Pinticketaro/DZ-GH-60_keyboard/LOG.md

# 製作ログ

新しいものを上に追記する。何を変えたか、実物でどうだったか、次に何を試すかを書く。写真は `photos/` に入れて名前で参照する。

---

## 2026-11-06 道具の更新（monozukuri 0.8.0）
- `scaffold.py --update-tools --force` でテンプレートの道具（geom.py・common.py・coupons.py・dims_sheet.py・render_model.py・slices.py・compare.py・params_diff.py）を入れた。requirements.txt はテンプレートの版に置き換え、ezdxf の1行を足し直した。元は tools/.backup-20261106-182902/
- このプロジェクトは mock.py ではなく gen_case.py → build3d.py で形を作るので、tools/model.py（make_version.py の --tool 用）を足した。mock.py.new は使わないので置かない
- 寸法ファイル：仮の寸法は basis の先頭を「仮（要実測・未確定）」に（0.8.0 はそこで見分ける）、meta.process = both
- 確認ボードを 0.8.0 のテンプレートで作り直して再公開。v19 の問い「底の中央のほぞ」→ いいえ（決定事項に記録）
- 次に試す：DZ60 が届いたら USB-C の位置・PCB の厚さ・PCB の下の部品の高さを測る → v20 は `make_version.py . v20 --tool tools/model.py`（gen_case.py の VER・PARENT を先に書き換える）

## 2026-10-27 v17〜v19（確認ボードで版を重ねた日）
- 2026-10-27 v17（モック）：補強板を枠の掘り込みに入れた（チャットで決定。ボードへの書き込みは0件）→ 側面のアクリルが1枚になり塊感が増した。ただしサポート確認で、上面下・下面下どちらで刷っても壁の内側に幅11.7mmのサポートが1周要ると分かった → 印刷の向き（A上面下／B下面下／Cv16に戻す）をボードで決める。図面・Fusionスクリプトは向きが決まってから更新。
- 2026-10-27 v18b（モック・v17 から分けた案 B・ブランチ claude/tray-v18、はじめ v18 として作り改名）：トレー型（枠＋底3.0一体のPLA、底を下にして印刷、ほぞは下側・M3×8）→ v17 の壁の内側のサポートが消え、残るのは小さな橋渡しだけ。見た目と高さはv17と同じ。次：トレー型とサンドイッチ型のどちらで進めるかをボードで決める。確認ボードはPCのブラウザで開く形（tools/serve_review.py）でも見られるようにした。
- 2026-10-27 v18a（モック・v17 から分けた案 A、ブランチ claude/old-design-v02）：サンドイッチ型のまま、枠は上面を下にして刷り、掘り込みの床をサポート（約19cm³）で受ける。形は v17 と同じ。確認ボードを monozukuri の最新（版の枝分かれ・ツリー表示）で作り直した。
- 2026-10-27 v19（モック・v18b から）：確認ボードの答えとフィードバックを反映（底2mm・M3×16・手前16.9mm、補強板の穴をU字の切り欠き（角は角ごと）、USBの窓を13×7の長穴＋窓の上は掘り込みを止める、内角の逃げ0.3、下面の面取り0.6、継ぎ目のV溝、マットブラック＋すりガラス）→ 窓の上下のPLAは2.55mmに。切り欠きを縁へまっすぐ抜くと角に細い耳が残るのに気づき、角は角ごと抜いた。次：DZ60 の USB-C の位置を実測して窓を決める、試し片（すき間・逃げ・ナット溝）。
- 2026-10-27 案：トレー型ならPCBを下からねじ止めできる（スペーサー＋下からM2）→ 保留。打鍵感がやわらかすぎたら検討（docs/改善案.md 1-8）。
- 次に試す：DZ60 の USB-C の位置を実測して窓を決める、テストピース（すき間・内角の逃げ・ナット溝）

## 2026-10-22
- 外部のデザインレビュー（docs外、design_feedback_v15）を受けて、方向性は「塊（ソリッド感）」に決定。傾きの指摘（3〜5°）は未決
- v16（サンドイッチ＋スカート）：枠を下へスカート状に延ばし（厚さ2・高さ2.9）、ボトムプレートを内側に収める（約310×121、ネジ穴はU字の切り欠き）。横から見えるのは枠と上のアクリル2枚だけに。枠は上面を下にして印刷する前提で、継ぎ目のほぞを上側へ（ナットは右半分の下面、ボトムプレートで隠れる）。全高は変わらず18.3
- 比較案として「箱型（底一体のPLAトレイ）」も検討中（未作成）

## 2026-10-15
- 旧プロジェクト（2025年2〜3月）のデータを調査 → `docs/旧プロジェクト.md`
- 方針変更：旧デザイン（2025-03-05の積層ケース）を踏襲。プレート・底板はレーザー、枠だけ3Dプリントの混成。外形315×126、M3×8
- 配列を旧配列に戻す：2u Backspace。あわせてKLEのCaps段のキー数の誤り（13→12）を修正。旧swillkbのスイッチ穴65個と全数一致を確認
- 矢絣模様は入れない
- 角はApple風（曲率が連続する角丸）にする。比較図とA4テスト片を作成。半径は現行iPadの角に当てて決める
- 図面v01を生成（`tools/gen_case.py`）：プレート・枠・底板、重ね合わせ図 `docs/img/overlay_v01.png`
- 構造を確定：トッププレート（アクリル・レーザー）／枠（PLA・3Dプリント）／ボトムプレート（アクリル・レーザー）
- 図面v02：枠の内側の角もApple風に丸める。PCBの角に当たらない最大のR4.5（すき間0.58mm）。角のネジ穴は自動で再配置
- PCBはネジ止めせず、ボトムプレート側の柔らかい台座で押し上げてトッププレートとスイッチで挟み込む方式に決定。トッププレートは剛性のため3mm（仮）
- v03：高さ方向をパラメータ化（枠の厚さは自動計算で8.6mm、合計14.6mm）。断面図 `docs/img/section_v03.png`
- 訂正：3mmの1枚板ではMXの爪が掛からず、台座で押し上げるとPCBとスイッチが浮く（挟み込みにならない）
- Fusion 360で寸法ベースに編集できるように：`fusion/DZ60_case/`（Fusionで実行するスクリプト。ユーザーパラメータ約40個と寸法つきスケッチ・押し出し・フィレット・分割でケースを組み立てる。生成元 `tools/make_fusion_script.py`）と、寸法確認用のSTEP（`case/step/`、`tools/export_step.py`）を追加
- v15：枠の継ぎ目をピンからほぞ＋縦向きのM3×6ボタンヘッドに（剛性のため）。ほぞ（左半分の下側から出る舌 幅9×厚さ4.5×長さ16）を右半分の下が開いたほぞ穴（片側0.2大）に入れ、縦向きのM3×6ボタンヘッド（他の8本と同じ向き・種類）で締める。前後の壁に1組ずつ、継ぎ目から8の所。頭は上面のざぐり、ナットはほぞの下面（上下ともプレートで隠れる、プレートは貫通しない）。サポートなしで印刷できる形に限定（最初に横向きボルトで作ったのは取り消し）
- Fusion 360で自分でモデリングする用の図面セット（A3・7枚：組立断面と部品表／外形・ネジ穴と角の点列／トッププレートとスタビ穴の詳細／スイッチ穴の座標表／補強板／枠／足）と、同じ座標のDXF・CSVを `case/drawings/` に追加（`tools/fusion_drawings.py`）
- v14：傾きをなくす（0°）。手前の角の穴を奥と前後対称に移し（Y=103.3、X=−5.85／290.85）、足を同じ形のPLAのバー×4に（幅12・長さ110.6・高さ3.7、`foot_bar_x4_v14.stl` を4個）。手前の高さ18.3mm
- v13：丸棒の加工がネックなので、一旦奥もPLAの足に。手前と同じ左右ずつのバー×2（高さ8.1、ナット受け）、ボルトは8本ともM3×18＋ナット。傾き約2.2°と後ろの穴位置（φ4）は丸棒φ8版と同じにして、あとで差し替えられるようにした
- v12：角R8・丸棒φ8で一旦検討。傾き約2.2°、丸棒313.3mm・約134g。溝底φ6.4では下穴が下まで6.4mmしかないため、めねじは貫通（ドリル・タップとも通し）。ねじ込み4.6、ボルト先端は下の出口から1.8手前。端の溝が丸棒の端に寄りすぎたので（縁から0.9mm）、後ろの角の穴を自動で内側へ（溝の縁から端まで3mm、X=−5.85／290.85）
- v11：丸棒の平面加工をやめ、旋盤でねじ穴を中心に全周の溝×4（幅10.5・深さ0.8）を掘ってゴムテープ（幅10・厚さ1）を巻く形に。テープは溝より0.2厚く、締めると上側が沈んで丸棒の外周がほぼプレートに接する。ボルトはテープを貫通。傾き約4.1°。加工図を溝つきに更新（平面の高さ公差は±0.1に緩和、端面は旋盤仕上げを明記）
- v10：丸棒の上面を幅6mmの平面にフライス加工する案に（削り深さ0.80、平面から下端11.20）。奥の受け台をなくし、ねじ込みは5.4mmに。傾き約3.7°。加工を頼む人に渡せる加工図（A3・第三角法・図枠と表題欄・正面/平面1:1・断面A-A 5:1・注記）を作成
- v09：足を左右ずつまとめる形に変更（手前バー×2＋奥の丸棒受け×2、各110mm）。中央2本のネジを左右対称（X=92.7／192.3）にし、左右の部品を鏡像の同じ形に。丸棒の穴位置も左右対称になり、治具1つで両端に使える
- v08：足を前後一体の4本に（取り消し：意図と違った）。列ごとに手前のナット受け（丸い台）と奥の丸棒受けを1本につなぐ（幅12・厚さ3・約120mm）。部品は足4＋丸棒1。Ender-3でそのまま印刷できる
- v07：丸棒とボトムプレートの間にPLAの受け台（最も薄い所1mm、左右2分割）を追加し、線当たりによるアクリルの割れを防ぐ。後ろの穴を全層φ4.0に広げ、丸棒の穴位置±0.3を吸収。傾きは約4.6°（φ12）。丸棒の穴あけ治具（左右2つ）と加工図（PDF）を追加
- v06：奥側の足を真鍮丸棒φ12（仮）に。底面の奥側に沿わせて左右方向に置き、横から端の丸が見えるように。後ろの4穴を一直線に並べ、M3×20を丸棒のめねじへ。傾きは丸棒の太さから自動計算（φ12で約4.1°）。穴あけ型紙を追加
- v05：外観・打鍵感の改善を調査して反映（`docs/改善案.md`）。打鍵感は板の厚さより留め方とフォームで決まると判明（はんだ後のたわみは1Nで約0.004mm）。足兼ナット受け（φ12×8、傾き5°仮、M3×18）、枠を0.3mm内側に、継ぎ目の位置決め穴、フォームの型紙、3Dモデル（STL）と外観プレビュー・色比較
- v04：トッププレート1.5mm（爪が掛かる）＋補強板2mm（穴は片側0.8mm大きい）に変更。補強板は接着せず、枠との間に挟んでM3で共締め。枠8.1mm、合計14.6mm

## 2026-10-14
- 方針決定：DZ60 V2（はんだ付け版）、CO2レーザーでプレート（1.5mm）、PLAで2分割ケース
- 配列データ（KLE）を作成：ISO系カスタム、分割Backspace、左Shift 1u＋1u、右Shift 1u×3
- GH60オープンソースPCBから基準寸法（外形・ネジ穴・キー位置）を抽出
- リポジトリ作成

- 2026-10-22 確認ボード公開（v05〜v16 の節目を収録、v16 が最新）。決めてほしいこと：補強板の埋め込み／箱型案／傾き／ボルトの色・低頭／継ぎ目のV溝／配色。次はボードのフィードバックを読んで v17 に反映。
