Pinticketaro/DZ-GH-60_keyboard/docs/決定事項.md

# 自作キーボード（DZ60）決定事項

最終更新：2026-10-27

## 基本方針
**旧デザイン（2025-03-05の積層ケース案）を基本的に踏襲する。** 旧データの中身は [旧プロジェクト.md](旧プロジェクト.md)。

## 資材
| 項目 | 決定 | 備考 |
|---|---|---|
| PCB | DZ60 V2（はんだ付け版） | 配列はPCB上の対応レイアウトから選ぶ |
| 配列 | 旧配列どおり（KLE：`layout/layout_kle.json`） | **2u Backspace**、ISO Enter、Caps段1u×12、4段目1u×15（左右Shiftとも1u分割）、下段 1.25u×3＋6.25u＋1u×5。計65キー（2026-10-15変更：分割BS→2u） |
| ケース方式 | **積層（サンドイッチ）・混成**：トッププレート（アクリル1.5）／補強板（アクリル2）／枠（PLA・3Dプリント）／ボトムプレート（アクリル） | 4層をM3ネジ8本で共締め。**接着しない** |
| PCBの固定 | **ネジ止めしない**。スイッチの爪がトッププレートの裏に掛かって上方向、肩がプレート上面に乗って下方向を止める。ボトムプレート側の柔らかい台座で下から軽く支える（ダンパー） | 2026-10-15決定。台座の素材・位置は未決（PCB裏の部品を避ける） |
| 外形 | **315×126mm**（旧デザイン） | 枠の幅14mm → 枠の内側287×98mm（PCB 285×94.6の周囲に約1mm） |
| 角 | **Apple風の角丸**（曲率が連続する角）。枠の内側の角も同じ方式で丸める（R4.5） | 外側は**R8・スムージング0.6で一旦検討**（2026-10-15、v12。v11まではR12）。比較図 `docs/img/corner_compare.png`、テスト片 `case/corner_test_A4.svg` |
| トッププレート | **アクリル1.5mm**、CO2レーザー。スイッチ・スタビ穴は旧swillkb出力（Cherryスタビ） | MXの爪が掛かる厚さ（1.6mm以下）。1.5mmアクリルはスタビ周りが割れやすいのでキャスト材を推奨 |
| 補強板 | **アクリル2mm（仮）**、CO2レーザー。トッププレートの下に重ね、枠との間に挟んで共締め | 2026-10-15決定（3mm1枚案は爪が掛からず不可）。穴はトッププレートより片側0.8mm大きく（15.6角）爪の逃げを確保。役目は、はんだ前の薄いアクリルの割れ防止・外周の剛性・プレート下の空洞を減らすこと。はんだ後の全体の硬さはプレート＋スイッチ＋PCBの箱で決まる（`docs/改善案.md`）。**2026-10-27（v17・試し中）：枠の上面の掘り込み（深さ2、外側の縁2、すき間0.2）に入れる**→外形310×121（ボトムプレートと同じ）。横から見えるアクリルはトッププレートだけ。印刷の向きは未決（どちら向きでも壁の内側に幅11.7のサポートが1周要る） |
| 枠 | PLA、Ender-3 Pro、左右2分割（中央 X=142.5）。**下にスカート（厚さ2）を延ばし、ボトムプレートを内側に収める**。**上面を下にして印刷**。継ぎ目はほぞ＋縦向きのM3×6ボタンヘッド（前後の壁に1組ずつ） | 2026-10-22（v16）：ソリッド感のため、横から見えるのを枠と上のアクリル2枚だけにした（ボトムプレートは見えない）。スカートの高さはボトムプレートより0.1低く2.9（足がボトムプレートを直接押さえる）。継ぎ目：ほぞ（左半分の上側から出る舌 幅9×厚さ3.8×長さ16）を右半分の上が開いたほぞ穴（片側0.2大）に入れ、縦向きのM3×6ボタンヘッドで締める。前後の壁に1組ずつ、継ぎ目から8の所。頭はほぞの上面のざぐり（補強板で隠れる）、ナットは右半分の下面（ボトムプレートで隠れる）。上面を下にした向きで、ほぞ・ほぞ穴・スカートの段差ともサポート不要 |
| ボトムプレート | **アクリル**、CO2レーザー、3mm（仮）。**枠のスカートの内側に入る大きさ（約310×121）、ネジ穴は縁から切り込んだU字の切り欠き** | 2026-10-22（v16）：位置はスカートで決まり、足と共締めなので閉じた穴でなくてよい（縁が細くならず割れにくい）。台座の土台になる |
| ネジ | **M3ボタンヘッド×8本＋ナット**。8本ともM3×18、上から全層を通す | 2026-10-15決定。穴は前後・左右対称の一直線2列：X=−5.85／92.7／192.3／290.85、Y=−8.7（奥）／103.3（手前）。奥の列は全層φ4.0のまま（丸棒に戻すときもプレートはそのまま使える） |
| 足 | **v14：傾きなし（0°）。同じ形のPLAのバー×4（幅12・長さ110.6・高さ3.7、ナット受け×2ずつ）** | 2026-10-15。手首の反りを減らすため平らに。手前の角の穴を奥と対称に移し、4本を同じ部品にした（`case/stl/foot_bar_x4_v14.stl` を4個印刷）。丸棒（v12の加工図）は保留。戻すなら手前の足も丸棒と同じ高さ（約8mm）にして平らのまま差し替え |
| 装飾 | 矢絣模様は入れない | 2026-10-15決定 |
| 外観の細部 | 枠をアクリルより0.3mm内側に下げる（影の線）。USB切り欠きは枠の全高 | 改善案は `docs/改善案.md` |
| フォーム | ケースフォーム（PCB下・台座を兼ねる）とプレートフォーム（補強板〜PCB 1.5mm） | 型紙は `case/foam_*_v05.svg`。素材は未決。**PORONはレーザーで切らない** |
| スタビ | PCBマウント・ネジ止め式 | はんだ付け前に取り付ける |
| 版管理 | GitHubリポジトリ | テキスト形式（SVG/DXF/JSON/コード）は差分管理、STEP/STLは版の記録 |

## 道具の分担
- Claude：基準寸法・図面生成（`tools/gen_case.py`）・枠の土台モデル（STEP）・寸法チェック・部品表
- Fusion 360：枠の最終造形（本人）→ STEPで返して寸法チェック
- Inkscape：プレート・底板の図面確認とレーザーへの出力（本人）
- Blender：完成イメージのレンダリング（任意）

## 進め方
1. 入力をそろえる：KLE JSON（済）、角丸の決定、実測値
2. プレート：図面生成（v01済）→ テストカット（スイッチ穴1＋スタビ1組）→ カーフ確定 → 本番
3. 枠：土台モデル → USB部と角の試し刷り → 2分割で本番
4. 底板：プレートと同じ外形・穴で切断
5. 組み立て：スタビ取付 → スイッチをトッププレートに挿す → PCBに載せてはんだ付け → 台座をボトムプレートに貼る → 補強板・枠・ボトムプレートを重ねて共締め → 動作確認
   ※補強板はスイッチを挿す前にトッププレートの下へ重ねておく（スイッチの下部が補強板の穴を通る）

## 確認ボードで決めたこと（2026-10-27）
| 項目 | 決定 | 理由 | 版 |
|---|---|---|---|
| ケースの形 | **トレー型**（枠と底を一体のPLAトレーに、底を下にして印刷）。サンドイッチ型（v18a）は残すが続けない | サポートがほぼ要らない。v17 の掘り込みはどちら向きでも壁の内側に1周サポートが要った | v18b で選び、v19 から |
| 底の厚さ | 2.0mm（ボルト M3×16、足 3.3mm、手前の高さ 16.9mm） | 全体を1mm低く | v19 |
| 傾き | 0°のまま | — | v19 |
| 補強板のネジ穴 | 縁へ開いたU字の切り欠き。角の4本は角ごと抜く | 穴と縁の間が約2.8mmで割れが不安（フィードバック）。角は細い耳・尖った先を残さない | v19 |
| USBの窓 | 角丸の長穴 13×7、窓の上は掘り込みを止めて壁を上まで残す（補強板は R1.5 で切り欠く） | 窓の上下のPLAが薄くて折れそう（フィードバック）。高さと位置は DZ60 の実測まで仮 | v19 |
| 内角の逃げ | RELIEF=0.3（ほぞ穴の奥の角、掘り込みの床と縁のL字） | 3Dプリントの内角の丸みで相手の角が当たる（フィードバック）。大きさは試し片で | v19 |
| 底の反り対策 | 下面の外周に0.6mmの面取り＋ブリム（スライサー）。内側を0.2mm浮かせる案は採らない | 浮かせると約280×95mmの橋渡しになり、0.2mmでは垂れてベッドに付く。付きも弱くなる | v19 |
| 継ぎ目の線 | 前後の外側の面に深さ0.4のV溝 | 継ぎ目を意図した線に見せる | v19 |
| 色 | PLA マットブラック、アクリル すりガラス | — | v19 |
| 天面のボルト | 頭の低いもの（極低頭 M3） | — | v19 |
| 底の中央のほぞ | 入れない（v19 の問いで「いいえ」。2026-10-27） | 前後の壁のほぞ2組と、プレート・補強板の共締めで足りるとみる。試作で継ぎ目の段差・たわみを確かめる | v19 |

## 未決事項
- 角丸：一旦R8（v12）。テスト片を現行iPadの角に当てて最終決定
- CO2レーザーの加工エリア（プレート・底板に **315×126mm以上** が必要）
- 補強板の厚さ（2mm／3mm）、ボトムプレートの厚さ
- 補強板の穴の大きさ（爪の逃げ0.8mm、スタビのハウジング下部）→ テストカットに補強板の小片も入れて確認
- アクリルの種類（キャスト／押し出し）と色・透明度
- （保留）真鍮丸棒：加工先が見つかったら差し替え（傾き0°のまま使うなら手前の足も約8mmに）。太さは一旦φ8。溝＋テープのとき φ6≈1.2°／φ8≈2.1°／φ10≈3.2°／φ12≈4.1°／φ14≈5.1°
- テープの素材（硬めのゴム推奨。厚さが変わる場合は溝の深さを「テープ厚−0.2」に合わせる）
- 丸棒の加工場所（大学のものづくりセンター、ホームセンターの工作室など）。治具と加工図は用意済み
- 剛性が足りなければ：補強板とトッププレートの間に薄い両面テープ、またはキーの間にM2の小ネジを数本足す
- DZ60実測値（USB-C位置・高さ、裏面部品高さ）→ USB切り欠き位置と枠の厚さが決まる
- 色の組み合わせ（トッププレートの仕上げ：すりガラス推奨、枠の色）
- 台座・フォームの素材（PORON／EVA／PE）
