Pinticketaro/DZ-GH-60_keyboard/docs/改善案.md

# 外観・打鍵感の改善案（v12時点）

調査・評価日：2026-10-15
数値の根拠：`tools/analysis.py` → `case/analysis_v05.json`、`tools/gen_case.py` → `case/params_v05.json`
状態：**反映済**＝図面・モデルに入れた／**推奨**＝作るときにやる／**選択肢**＝試してから決める

---

## 0. いちばん大事な発見：打鍵感は「板の厚さ」より「留め方とフォーム」で決まる

| 状態 | 1N（指1本分の目安）で中央がたわむ量 |
|---|---|
| トッププレート1.5mmだけ | 約0.6mm |
| ＋補強板2mm（接着なし） | 約0.23mm |
| PCBだけ | 約0.026mm |
| **プレート＋スイッチ＋PCB（はんだ後）** | **約0.004mm** |

- スイッチ65個でプレートとPCBがつながると、5mm離れた2枚の板が組んだ「箱」になり、アクリル単体の100倍以上硬くなる。全体のたわみはほぼ無視できる。
- つまり**打鍵感・打鍵音は、この箱をケースがどう支えるか（周囲のネジ、台座・フォームの硬さ）でほぼ決まる。**
- 補強板の役目は「はんだ付け前の薄いアクリルを割れから守る」「外周の剛性」「プレート下の空洞を減らす（響き対策）」「横から見た厚み」。全体の硬さのためではない。

## 1. 打鍵感・打鍵音

| # | 内容 | 状態 | 効果・注意 |
|---|---|---|---|
| 1 | **ケースフォーム＝台座**：PCBの下の空間（5mm）をフォームの板で埋め、そのまま台座にする | **反映済**（型紙 `case/foam_case_v05.svg`） | 空洞の響きが減り、底打ちがやわらかくなる。フォームは隙間より0.5〜1mm厚いものを選び、少しつぶして入れる（つぶれた分だけPCBを押し上げ、爪が受け止める）。USB-Cの裏は仮の逃げ。PCB裏の部品の位置を測ってから穴を足す |
| 2 | **プレートフォーム**：補強板とPCBの間の1.5mmにフォームを入れる | **反映済**（型紙 `case/foam_plate_v05.svg`） | 高音の響きが減る。1.5mmのEVA／PE。薄いPE（0.5mm前後）にすると「ポコポコ」した明るい音（PEフォームmod） |
| 3 | 台座の素材で硬さを選ぶ | 選択肢 | PORON（ポリウレタン）＝やわらかく深い音／EVA＝やや硬め／シリコン＝弾む。密度が高いほど響きを強く抑える |
| 4 | **枠はインフィル高め・壁多め**で印刷 | 推奨 | 中がスカスカだと響く。インフィル100%なら枠は約114g（左右合計） |
| 5 | スタビライザーの調整（グリス、ワイヤーの端、バンドエイドmod） | 推奨 | スペース・Enter・Backspaceのカチャつきは打鍵音の印象を大きく左右する |
| 6 | もっとやわらかい打鍵感にしたい場合：ネジの所にゴムのワッシャー（グロメット）を挟み、プレートを少し浮かせる | 選択肢 | ふわっとするが、組み立てが複雑になる。まずは1〜3で調整し、物足りなければ試す |
| 7 | プレートにスリット（フレックスカット）を入れて板ばねにする | 選択肢 | 弾む打鍵感になるが、アクリルはスリット端から割れやすい。端を丸くして小片で試してから |
| 8 | **PCBを下からねじ止め**（トレー型ならでき）：GH60の穴（M2×4）に5mmの真鍮スペーサーを先に上から低頭ネジで留め、トレーの底の下からM2皿ネジで留める | 保留（2026-10-27：打鍵感がやわらかすぎたら検討） | PCBががたつかず、USBの位置も決まる。そのかわり硬いトレーマウントの感触になり、PCBがプレート（スイッチ）とトレー（スペーサー）の両方に固定されるので、スペーサーの上面の高さがずれるとPCB・プレートがたわむ。穴の位置は DZ60 の実測で確かめる |

**フォームを切るときの安全上の注意**
- **PORON（ポリウレタン）はレーザーで切らない。** 大学の安全資料では、ポリウレタンは加熱でシアン化水素を出す材料として「切断不可」。型紙を100%で印刷し、カッターで切る。
- EVA・PEは、成分がはっきりしていて換気できる場合のみレーザー可。**PVC（塩ビ）と成分不明のフォームは切らない。**

## 2. 外観

| # | 内容 | 状態 | 説明 |
|---|---|---|---|
| 0 | **ボトムプレートを枠のスカートの内側に収め、横から見えなくする** | **反映済**（v16） | 外部レビュー（2026-10-22）の「塊か積層か」への答えとして「塊（ソリッド感）」を選択。側面は枠のPLAの帯＋上のアクリル2枚だけになる（比較 `docs/img/side_compare_v15_v16.png`）。さらに補強板も枠の掘り込みに入れれば、見えるアクリルはトッププレート1.5だけにできる（未決） |
| 1 | **枠をアクリルより0.3mm内側に下げる** | **反映済**（`FRAME_INSET`） | 印刷の誤差で枠がはみ出さず、層の間に細い影の線が出て、仕上がりがきれいに見える |
| 2 | **足：v14は同じ形のPLAのバー×4（傾きなし）**。丸棒（φ8＋旋盤の溝×4にゴムテープ）は加工先が見つかったら差し替え | **反映済**（v14）／丸棒は保留（v12） | 部品が1種類で済む。丸棒は真鍮に黒いテープの帯が並ぶアクセントで、横から端の丸が見える |
| 3 | **傾き0°・手前の高さ18.3mm**（キーキャップ別） | **反映済** | 平らなほうが手首の反りが少ない。キーキャップ（OEM・Cherryなど）の段ごとの高さ・角度で奥の段は自然に高くなる。Wootingの目安「手前はキーキャップ込みで30mm以下」に収まる見込み |
| 4 | **トッププレートはすりガラス（艶消し）を推奨** | 推奨 | 透明だと補強板の大きい穴の縁が二重線に見え、PCBも透ける。すりガラス／スモークならまとまって見える（比較図） |
| 5 | アクリルの種類：トップはキャスト材、補強板・ボトムは押し出し材でも可 | 推奨 | キャストは切り口がきれいで、彫刻が白くはっきり出て、割れにくい。押し出しは厚さのばらつきが小さく安い |
| 6 | **枠の継ぎ目**：ほぞ（左半分の下側から出る舌 幅9×厚さ4.5×長さ16）を右半分の下が開いたほぞ穴（片側0.2大）に入れ、縦向きのM3×6ボタンヘッド（他の8本と同じ向き・種類）で締める。前後の壁に1組ずつ、継ぎ目から8の所 | **反映済**（v15。v14まではφ1.75ピン） | ほぞで上下・前後のずれと曲げを受け、ボルトで上下に締めつける。ほぞは下面から立ち上がる板、ほぞ穴は下が開いた溝（天井は幅9.4の橋渡し）なので、どちらの半分もいつもの向きでサポートなしで印刷できる。プレートには穴を開けない |
| 7 | **印刷の継ぎ目（Zシーム）を継ぎ目に隠す** | 推奨 | 外周は角まで全部なめらかなので、Curaの「最も鋭い角」にすると、角が立っている分割面のふちにシームが寄る。プレビューで確認する |
| 8 | 枠はマット系PLA、外壁は積層0.12〜0.16mm | 推奨 | 横から見える8mmの帯の積層の筋が目立ちにくい |
| 9 | ボルトはボタンヘッド（ISO 7380）で8本の向きと色をそろえ、薄いワッシャーを入れる | 推奨 | 上面に見える唯一の金物。締めすぎるとアクリルが割れる |
| 10 | USBの切り欠きを枠の全高にし、上下のアクリルで縁取られた窓にする | **反映済** | 位置はPCBの実測後に確定 |
| 11 | 角丸の大きさ | 一旦R8（v12） | A4テスト片を現行iPadに当てて最終決定 |

**色の組み合わせ**：`docs/img/color_variants_v05.png`（A：すりガラス＋ウォームグレー／B：透明＋白／C：スモーク＋チャコール）

**真鍮丸棒の太さと傾き**（溝深さ0.8＋テープ1.0。φ8で長さ313.3mm）

| 丸棒 | 傾き |
|---|---|
| φ6 | 約1.2° |
| φ8（一旦） | 約2.1° |
| φ10 | 約3.2° |
| φ12 | 約4.1° |
| φ14 | 約5.1° |

テープの厚さを変えるときは、溝の深さ＝テープの厚さ−0.2mm にする（締めたとき丸棒がほぼプレートに接する）。

参考：丸台8個（v05）にした場合の傾きと足の高さ（ボルトは8本ともM3×18。ナットが傾いた底面から出ない高さで自動計算）

| 傾き | 前の足 | 後ろの足 | 手前の高さ（キーキャップ別） |
|---|---|---|---|
| 0° | 3.7mm | 3.7mm | 18.3mm |
| 3° | 3.9mm | 9.8mm | 18.5mm |
| 5° | 4.1mm | 13.9mm | 18.7mm |
| 7° | 4.2mm | 18.0mm | 18.8mm |

## 3. 重さ（ケース部品）
トッププレート46g、補強板53g、ボトムプレート141g、枠114g（インフィル100%）、計約354g。ここにPCB・スイッチ・キーキャップが加わる。重いほど机の上で動きにくく、音も落ち着く。

## 4. 次に決めること
1. 丸棒に戻すかどうか（傾きは0°に決定）
2. 色の組み合わせ（トッププレートの仕上げと枠の色）
3. 台座・フォームの素材（PORON／EVA／PE）
4. 角丸の大きさ（iPadとの比較）

## 参考
- 打鍵音のmod全般（ケースフォーム・PEシート・テープmod）：[evetech](https://evezone.evetech.co.za/quick-bytes/keyboard-sound-mods-explained-foam-tape-pe-sheets)
- プレートフォーム・ケースフォームの効果：[Make Tech Easier](https://maketecheasier.com/modify-keyboard-case-plate-to-perfection)
- 傾きと手前の高さ：[Wooting 80HE ergonomics and feet](https://wooting.io/post/wooting-80he--ergonomics-and-feet)
- レーザー加工の禁止材料（ポリウレタン・PVC）：[University of Florida EHS](https://www.ehs.ufl.edu/wp-content/uploads/2021/06/Laser-Cutter-Materials.pdf)
- フォームのレーザー加工：[Thunder Laser](https://www.thunderlaser.com/laser-wiki/material-applications/laser-cut-foam.html)
- キャストと押し出しアクリル：[Thunder Laser](https://www.thunderlaser.com/laser-wiki/material-applications/extruded-acrylic-vs-cast-acrylic)
- Zシームの隠し方：[Sovol](https://www.sovol3d.com/blogs/news/3d-printer-z-seam-placement-alignment-and-surface-finish-tips)
