Pinticketaro/DZ-GH-60_keyboard/refs/資料.md

# 資料

寸法の根拠にした図面・データ・実測の記録。寸法ファイル（`params/params_<版>.json`）の各項目の `ref` からこのフォルダのファイル名か URL で指す。確認ボードの「寸法と根拠」と「資料」に出る。
ここにあるファイルのうち 基準寸法.md・dz60_実測.md・決定事項.md・swillkb_switch_layer.svg は、元の場所（docs/・measurements/・tools/data/）へのリンク。直すときは元のファイルを直す。

| ファイル | 何か | 出典 | 使った寸法（キー） |
|---|---|---|---|
| 基準寸法.md | GH60互換の基準寸法（PCB外形・ネジ穴・キー位置・高さ方向） | GH60 オープンソースPCB（https://github.com/komar007/gh60 の keyboard.kicad_pcb）から抽出 | pcb_w, pcb_h, key_pitch, plate_top_to_pcb, top_t, usb_x |
| dz60_実測.md | DZ60 V2 の実測の記録（まだ空欄。PCBが届いたら記入） | ノギスで実測 | pcb_t, under_pcb, usb_x |
| 決定事項.md | 決めたことと理由・日付 | このプロジェクト | outer_w, corner_r, stiff_t, tilt など |
| swillkb_switch_layer.svg | トッププレートのスイッチ・スタビ穴の形（旧デザインの swillkb 出力） | swillkb Plate & Case Builder（2025年に出力） | switch_cut |

- 記憶や推測の値は資料にならない。その寸法は status を「仮」にして、basis に「要実測」などと書く。
