Pinticketaro/DZ-GH-60_keyboard/docs/事例とアイデア.md

# 事例とアイデア・制作進行方式

調査日：2026-10-14
GitHubや3Dモデル共有サイトの事例から、このプロジェクト（DZ60 V2・CO2レーザープレート・PLA 2分割ケース）に使えるものを抜き出した。

---

## 1. 参考事例

### ケース（3Dプリント・GH60互換）
| 事例 | 特徴 | 使えるところ |
|---|---|---|
| [Mech-60](https://www.printables.com/model/413278-mechanical-keyboard-mech-60-gh60-compatible) | 底を左・中・右の3分割、ネジで接合。GH60用の部品差し替えあり | 分割をネジで組む実例。更新版でネジ穴を大きくした＝最初の穴は小さすぎた |
| [PH60R2](https://makerworld.com/en/models/808113-ph60r2-printable-60-mechanical-keyboard-kit) | 6パーツ分割、マグネットで合体、ガスケットマウント。GH60 PCB対応 | 印刷設定（0.2mm／壁4周／インフィル100%）、PORONフォーム、全部品を同じプリンタ・同じフィラメントで刷る |
| [MEGA 60](https://www.printables.com/model/495776-mega-60-gh60-modernized-case-soft-mounted-pcb-boun) | PCBをTPUのジャケットで柔らかく保持（ソフトマウント） | ネジ止めでなく弾力で支える発想。M3インサート＋皿ネジ。約300mmで一体印刷（Ender-3では分割が必要） |
| [XF60](https://makerworld.com/en/models/494120-xf60-gh60-keyboard-case) | GH60用ケース | 形状の参考 |

### 生成ツール
| ツール | 内容 | 使えるところ |
|---|---|---|
| [ai03 another-keyboard-builder](https://github.com/ai03-2725/another-keyboard-builder) | KLE → プレートDXF。コマンドで動く（[使い方](https://wiki.ai03.com/books/case-and-plate-design/page/using-ai03-plate-generator-as-a-cli-tool)） | **プレート生成の本命**。スタビ穴形状を自作せず、実績のある生成器に任せる |
| [yacb](https://github.com/Avaviel/yacb) | KLE → DXF/SVG、カーフ設定あり、高精度計算 | ai03の結果と突き合わせる検算用 |
| [cq_keyboard_gen](https://github.com/mryndzionek/cq_keyboard_gen) | CadQueryでケース生成、GitHub ActionsでSTLを自動生成 | **pushすると自動でSTLとプレビュー画像ができる**仕組み |
| [scad-keyboard-cases](https://github.com/Lenbok/scad-keyboard-cases) | KLE → OpenSCADで上下ケース生成 | KLEの座標を取り出す処理、外形・ネジ穴を変数で持つ構成 |
| [Keyboard_case_generator](https://github.com/vladantrhlik/Keyboard_case_generator) | レーザーカットの積層（サンドイッチ）ケース生成 | 3Dプリントがうまくいかないときの代替案。CO2レーザーなのでアクリル積層ケースも作れる |

### 試作の進め方
| 事例 | 学び |
|---|---|
| [FreeCADでの3Dプリント試作（adamws）](https://adamws.github.io/3d-printed-keyboard-prototype-with-freecad/) | ①段階的に穴サイズを変えた**キャリブレーション板**を先に作る。②規格値（約14.0mm）より**13.9mmが最適**だった＝規格値が正解とは限らない。③サイズ調整は生成器側で行い、本体設計は触らない。④安い試作で配列が好みでないと気づけた |

---

## 2. このプロジェクトに取り入れるアイデア

### プレート
- **生成はai03に任せ、カーフ補正だけ自前で足す**：スタビ穴の複雑な形状を自作すると誤差の元になる。
- **キャリブレーション板を最初に切る**：スイッチ穴を13.8〜14.1mmで0.05mm刻み程度に並べた小さな板。スタビ穴も1組入れる。
- **本番素材の前に合板で全面プレートを1枚**：スイッチを挿して打ってみると、配列の好みやスタビ位置の誤りが安く見つかる。

### ケース
- **分割は2分割（Ender-3で各約150mm）を基本、3分割も選択肢**：Mech-60のように中央パーツを作ると、継ぎ目がキー列の下に隠れやすい。
- **接合方式の候補**
  - ネジ＋インサート（確実、分解できる）
  - マグネット（PH60R2方式。工具なしで開けられる）
  - 位置決めダボは共通で入れる
- **マウント方式の候補**
  - トレイマウント（標準。DZ60のネジ穴をそのまま使う）
  - TPUジャケットのソフトマウント（MEGA 60方式。打鍵感がやわらかい。ただしEnder-3の標準構成はTPUが刷りにくいので要確認）
- **ネジ穴は最初から少し大きめに**：Mech-60も更新で拡大している。
- **印刷設定の出発点**：積層0.2mm、壁4周、インフィル高め（重さと打鍵音の安定のため）。全パーツ同じフィラメント・同じ設定で刷る。
- **フォーム**：PCBとケースの間にフォーム（PORONなど）を入れると、打鍵音の反響が減る。

### データ管理
- **GitHub Actionsで自動生成**：KLEやパラメータを変えてpushすると、プレートDXF・ケースSTL・プレビュー画像が自動で作られる。生成物の作り忘れや古いファイルの取り違えを防げる。
- **代替案は残しておく**：レーザー積層ケースは、3Dプリントで行き詰まったときの逃げ道として記録しておく。

---

## 3. 制作進行方式

### マイルストーン
各段階で実物を作り、完了条件を満たしたらGitタグを付けて次へ進む。

| # | 段階 | 作るもの | 完了条件 | タグ |
|---|---|---|---|---|
| M0 | 準備 | 実測表、ツール準備 | `measurements/` が埋まる | `m0-measured` |
| M1 | プレート校正 | キャリブレーション板（穴サイズ違い＋スタビ1組） | スイッチ穴サイズとカーフ値が決まる | `m1-plate-cal` |
| M2 | プレート試作 | 合板の全面プレート | 全スイッチが挿さり、スタビが動く。配列に納得 | `m2-plate-proto` |
| M3 | ケース校正 | 角・USB部・継ぎ目・ネジボスの小片 | はめ合い公差、インサート下穴、USB切り欠きが決まる | `m3-case-cal` |
| M4 | ケース本番 | 2分割ケース | PCB＋プレートが収まり、ネジが締まる | `m4-case` |
| M5 | 本番プレート | 本番素材のプレート | M2と同じ条件を満たす | `m5-plate` |
| M6 | 組み立て | スタビ→スイッチ→はんだ→ケース | 全キー動作、ガタなし | `m6-build` |

### ルール
- **1回の試作で変える条件は1つ**：カーフと素材を同時に変えると、何が効いたかわからなくなる。
- **試作のたびに記録**：LOG.mdに「何を変えた → 結果 → 次の一手」、写真を `photos/` に（定規を一緒に写す）。
- **決めたことは理由と一緒に `docs/決定事項.md` へ**：後で「なぜこうしたか」がわかる。
- **大きな試し（マグネット案、ソフトマウント案など）はブランチで**：うまくいったら本流に取り込み、だめなら捨てる。
- **困りごとはGitHubのIssueに1件ずつ**：例「USB切り欠きが1mm低い」。直したコミットでIssueを閉じると、問題と対策が紐づく。

### Claudeとの分担（段階ごと）
| 段階 | Claude | 本人 |
|---|---|---|
| M1・M2 | キャリブレーション板とプレートのDXF/SVG生成、カーフ補正 | Inkscapeで確認、レーザーで切断、はめ合い確認と写真 |
| M3・M4 | ケース土台（CadQuery→STEP/STL）、校正用の小片 | Fusionで造形、印刷、実物確認 |
| 全体 | 重ね合わせチェック、部品表、LOG・決定事項の更新、コミット | 実測、試作結果の報告 |
