Pinticketaro/DZ-GH-60_keyboard/review/refs/基準寸法.md

# 基準寸法（GH60互換）

出典：GH60オープンソースPCB（https://github.com/komar007/gh60 の keyboard.kicad_pcb）から抽出。
DZ60はGH60互換のネジ穴配置（KBDfansの60%ケースがGH60標準ネジ穴でDZ60各版に対応と明記）。
**DZ60固有の値（USB-C位置など）は `measurements/dz60_実測.md` で実測して確定させる。**

## 座標系
- 原点：PCB外形の左上、X右・Y下、単位mm

## PCB
| 項目 | 値 |
|---|---|
| 外形 | 285.0 × 94.6 mm |
| 角R | 2.0 mm |
| 厚さ | 1.6 mm（要実測） |

## ネジ穴
| # | 種類 | X | Y | 穴径 |
|---|---|---|---|---|
| H1 | 丸穴 | 25.20 | 27.90 | φ2.5 |
| H2 | 長穴 | 128.20 | 47.00 | 5.0×2.5 |
| H3 | 長穴 | 190.50 | 85.20 | 5.0×2.5 |
| H4 | 長穴 | 260.05 | 27.90 | 5.0×2.5 |
| S1 | 左端スロット | 1.46 | 56.50 | 7.0×2.5 |
| S2 | 右端スロット | 283.54 | 56.50 | 7.0×2.5 |

M2ネジ前提。ケースのボスはH1〜H4を基本にする。

## キー配置
- 1U = 19.05 mm
- 左上キー（Esc）の中心：(9.1475, 9.19875)
- キー領域15U×5Uは、PCB中心に対して中央配置
- 任意キーの中心 = (−0.375 + (x + w/2)·19.05, −0.325 + (y + h/2)·19.05)　※x, y, w, h はKLEの値（U単位）

## プレート
| 項目 | 値 |
|---|---|
| スイッチ穴 | 14.0 × 14.0 mm（カーフ補正前） |
| 厚さ | 1.5 mm |
| PCB上面〜プレート上面 | 5.0 mm |
| スタビ間隔（2U〜2.75U） | キー中心から ±11.938 mm |
| スタビ間隔（6.25U） | キー中心から ±50.0 mm |

スタビ穴の形状は ai03 Plate Generator（https://kbplate.ai03.com）の出力を基準にする。

## ケース（積層・混成）— 旧デザイン踏襲
数値は `tools/gen_case.py` の先頭にまとめてあり、`case/params_v16.json` に書き出される。

| 項目 | 値 | 備考 |
|---|---|---|
| 外形 | 315.0 × 126.0 mm | PCB中心に対して中央。外形の左上 = PCB座標 (−15.0, −15.7) |
| 角 | Apple風の角丸（クロソイド＋円弧） | 一旦：R8・スムージング0.6（角から12.0mmでカーブが始まる）。v11まではR12 |
| 枠の幅 | 14.0 mm | 枠の内側 287 × 98 mm、PCBとのすき間 約1.0 mm |
| 枠の内側の角 | Apple風 R4.5・スムージング0.6 | 角から6.8mmでカーブが始まる。PCBの角（R2）とのすき間0.58mm。これ以上大きくするとPCBに当たる（生成時に自動チェック） |
| 枠の厚さ | 8.6 mm（仮・自動計算） | 下の「高さ方向」を参照 |
| 枠の分割 | X = 142.5（中央） | Ender-3 Proで各半分 157.5 × 126 |
| M3穴 | φ3.4 × 8 | 中央4本：X = 92.7, 177.0／Y = −8.7, 103.3。角4本：角丸に合わせ、外周と枠の内側から等距離（v02：X = −5.3, 290.3／Y = −6.0, 100.6、穴の縁から外周・内側まで約6.4mm） |
| USB切り欠き | 中心 X = 18.2、幅 13 mm | GH60標準の位置。**要実測** |
| トッププレート | 1.5 mm、スイッチ穴14.0（カーフ補正前） | 穴形状は旧swillkb出力（`tools/data/swillkb_switch_layer_2025.svg`）。KLEの65キーと全数一致を確認済み |

※ 旧デザインでは下側中央2本の穴だけY位置が1.7mmずれていたので、他と揃えた。

## 高さ方向（PCBはネジ止めせず、スイッチの爪と肩でトッププレートに固定）
図：`docs/img/section_v04.png`

| 層（上から） | 厚さ（mm） | 備考 |
|---|---|---|
| トッププレート（アクリル） | 1.5 | 穴14.0。MXの爪がこの板の裏に掛かる（1.6mm以下であること） |
| 補強板（アクリル） | 2.0（仮） | 穴は片側0.8mm大きい（スイッチ15.6角、スタビも同様）。穴と穴の間の最小幅2.7mm。M3で共締め |
| 補強板の下面〜PCB上面 | 1.5 | ＝ 5.0（プレート上面〜PCB上面、MX規格）− 1.5 − 2.0 |
| PCB | 1.6（要実測） | |
| 台座（柔らかい素材） | 5.0（仮） | PCB裏の部品・USB-Cより高く。少しつぶれる分を見込む |
| ボトムプレート（アクリル） | 3.0（仮） | v16：外形より片側2.5小さい310.0×121.0、ネジ穴はU字の切り欠き。枠のスカート（厚さ2・高さ2.9）の内側に入る |
| **枠（PLA）** | **8.1** | ＝ 1.5 ＋ 1.6 ＋ 5.0 |
| **合計** | **14.6** | キーキャップ・足を除く。M3ネジは 14.6＋ナット分 |

- 補強板を3mmにすると、補強板とPCBの間は0.5mm、枠は7.1mmになる（`STIFF_T = 3.0`）。
- スタビライザーのワイヤーの通り道は、トッププレート・補強板とも貫通してつながっている（スペース：幅4.6mm＋補強板は片側0.8mm広い）。
- PCBマウントスタビのハウジング下部（PCB近く）が補強板に当たらないか、テストカットで実物確認する。

## ボルト・足（v05）
| 項目 | 値 | 備考 |
|---|---|---|
| ボルト | M3×18 ボタンヘッド ×8 | 上から全層を通す。先端はナットの下面とそろう |
| ナット | M3（二面幅5.5・厚さ2.4） | 足の六角溝（二面幅6.1、下から）に入れる。ナットの上のPLA 1.0mm |
| 足 | φ12 ×8、外形より1.0mm以上内側 | 前4.1mm／後13.9mm（傾き5°）。底面は机と平行になるよう斜めに切ってある |
| 手前の高さ | 18.7mm（キーキャップ別） | ＝ 前の足4.1 ＋ 積層14.6 |
| 枠の外周 | アクリルより0.3mm内側 | `FRAME_INSET` |
| 枠の継ぎ目 | ほぞ（左半分の上側から出る舌 幅9×厚さ3.8×長さ16）を右半分の上が開いたほぞ穴（片側0.2大）に入れ、縦向きのM3×6ボタンヘッドで締める。前後の壁に1組ずつ、継ぎ目から8の所（v16で上下を逆に） | 頭はほぞの上面のざぐりφ6.2・深さ1.9（補強板で隠れる）、ナットは右半分の下面の六角溝 二面幅6.1・深さ2.6（ボトムプレートで隠れる）。ほぞ穴の下に残る厚さ4.1。枠は上面を下にして印刷、サポート不要 |

## 足（v14：傾き0°、同じ形のPLAのバー×4）
| 項目 | 値 | 備考 |
|---|---|---|
| バー | 4本とも同じ形：幅12・長さ110.6・高さ3.7 | 2穴（間隔98.55）の丸を凸包でつないだ形。底は平ら |
| 位置 | 中心線 Y=−8.7（奥）／103.3（手前）、左右 X=−5.85〜92.7／192.3〜290.85 | 外形の角に当たらない |
| ナット溝 | 二面幅6.1、下から。上に1.0mmの肉 | M3×18がナットの下面とほぼ面一 |
| ボルト | 8本ともM3×18＋ナット | |
| 傾き | 0°。手前の高さ18.3mm（キーキャップ別） | |
| STL | `case/stl/foot_bar_x4_v14.stl`（4個印刷）、まとめて `feet_v14.stl` | |

## 真鍮丸棒（保留：v12の内容。丸棒ができたら奥バーと差し替え）
| 項目 | 値 | 備考 |
|---|---|---|
| 丸棒 | C3604BD φ8 × 313.3±0.2 | 中心線はY=−8.7（後ろのネジ列）。両端C0.5、端面は旋盤仕上げ。約134g |
| 溝 | ねじ穴を中心に全周×4。幅10.5±0.1、溝底φ6.4±0.05（深さ0.8） | 溝の角は糸面取り。端の溝の縁から丸棒の端まで約3.0mm |
| テープ | 幅10・厚さ1.0のゴムテープを溝に巻く | 溝より0.2厚い。締めると上側が0.2沈み、丸棒の外周がほぼプレートに接する。下側（約0.1つぶれ）が机に当たる |
| めねじ | 4-M3×0.5、下穴φ2.5 貫通・タップ貫通（溝底から反対側の溝底まで6.4） | 丸棒の左端から 8.29 / 106.84 / 206.44 / 304.99（±0.1）。ボルトはテープを貫通 |
| 後ろの穴 | φ4.0（全層）。X = −5.85, 92.7, 192.3, 290.85／Y = −8.7 | 角の2本は溝が丸棒の端に寄りすぎないよう自動で内側へ |
| ボルト | 後ろM3×20（ねじ込み4.6、溝底から。先端は下の出口から1.8手前）、前M3×18＋ナット | |
| 足 | 手前バー×2（各約111） | 奥はPLA部品なし |
| 傾き | 約2.2°（φ8） | 前の足の底と、丸棒の下側のテープが同じ机の面に乗る角度 |
| 手前の高さ | 18.5mm（キーキャップ別） | |
| 加工図 | `case/rod_drawing_v12.pdf`（A3・第三角法・平面図/正面図1:1、断面A-A 5:1） | φ12版：v11。予備：v10（上面を平面加工）、v09（PLAの受け台） |
