Pinticketaro/DZ-GH-60_keyboard/review/refs/dz60_実測.md

# DZ60 V2 実測値

PCBが届いたらノギスで測って記入する。埋まった値は `docs/基準寸法.md` の仮値より優先する。

| 項目 | 値（mm） | 測定日 | メモ |
|---|---|---|---|
| 外形 幅 | | | 基準値 285.0 |
| 外形 奥行き | | | 基準値 94.6 |
| PCB厚 | | | 想定 1.6 |
| USB-C 中心X（左端から） | | | |
| USB-C 中心の高さ（PCB上面から） | | | 裏面実装なら負値 |
| USB-C 上辺からの張り出し | | | |
| 裏面部品の最大高さ | | | |
| ネジ穴 H1〜H4 の有無と位置 | | | 基準値は docs/基準寸法.md |
