Pinticketaro/DZ-GH-60_keyboard/docs/旧プロジェクト.md

# 旧プロジェクト（2025年2〜3月）の中身と引き継ぎ

調査日：2026-10-15
対象：`olderproject/`（74ファイル・9.6MB、Gitには未登録）

---

## 1. 旧プロジェクトの概要

- **時期**：2025-02-13〜2025-03-05
- **使ったソフト**：FreeCAD 0.21（.FCStd）、Inkscape、Cura 4.13.1、swillkb Plate & Case Builder、VIA
- **プリンタ**：Cura の設定は **Creality Ender-3 Pro**（ファイル名の `CE3PRO_`）
- **流れ**：①3Dプリントの積層ケース（2月中旬）→ ②レーザー加工用の積層ケース図面（2月末〜3月上旬）

## 2. 配列（旧）

`hairetsu コピーして使ってね.svg`（swillkbのスイッチ穴図、295.752×105.252mm）より：

| 段 | 旧配列 |
|---|---|
| 1段目 | 1u×13 ＋ **2u Backspace**（スタビあり） |
| 2段目 | Tab 1.5u ＋ 1u×12 ＋ ISO Enter |
| 3段目 | Caps 1.75u ＋ 1u×12（ISO Enterの下側と並ぶ） |
| 4段目 | 1u×15（左Shift・右Shiftとも1u分割） |
| 5段目 | 1.25u×3 ＋ 6.25u Space ＋ 1u×5 |

→ 現在の配列（`layout/layout_kle.json`）との違いは **Backspaceの分割だけ**。

### 現在のKLE・決定事項で見つかった食い違い（2026-10-15 修正済み：旧配列どおり2u Backspace・Caps段1u×12・下段1u×5）
- **KLEの3段目（Caps段）が1u×13になっている**：Caps 1.75u ＋ 13個 = 14.75uで、ISO Enterの下側（13.75〜15u）と重なる。旧配列どおりなら **1u×12**。
- **決定事項の下段が「1u×6」**：1.25×3＋6.25＋6 = 16uになり15uを超える。KLE本体は1u×5なので、決定事項の記述のほうが誤り。

## 3. キーマップ（旧）

| ファイル | 中身 |
|---|---|
| `dz60.layout.json` | **VIA用キーマップ（4レイヤー）**。再利用できる |
| `dz60_layout_60_iso_4th_row_all_1u_2025-02-14*.json`（3つ） | QMK Configuratorの書き出し。3つとも同一で**全キーKC_NO（空）**。使えない |

VIAキーマップの要点：
- レイヤー0：Esc＝Grave Escape、Caps位置＝`~`、左Shift右隣（1u）＝MO(1)、右下＝MPLY・MO(1)・矢印キー、右Shift右に↑と右Ctrl
- レイヤー1（Fn）：F1〜F12、テンキー（P0〜P9・四則）、マウスキー（カーソル・ボタン・ホイール）、RGB操作、PrintScreen/Insert/Home/PgUp/PgDn/End/Delete、音量
- レイヤー2・3：ほぼ未使用（試し入力の跡）

## 4. 3Dプリントの積層ケース（2月中旬）

FreeCADで作った「上板＋枠＋底板」の積層ケース。

| ファイル | 内容 | 寸法（mm） |
|---|---|---|
| `uenoita.stl` | 上板（スイッチ穴つき） | 337.8×146.8×**4** |
| `falame1.stl` / `sagyo1.stl` / `sagyo2.stl` | 枠（左右2分割の半分ずつ） | 175.6×147×8 |
| `sagyo3.stl` | 枠の継ぎ足し部材 | 117.3×16×8 |
| `shitanoita.stl` / `sitanoita.stl` | 底板 | 337.8×146.8×3 |
| `asidamana.stl` → `Ashi_L/R.stl` | 足（全幅の棒を左右2分割） | 338×21×4 → 169×21×4 |
| `are.stl` | 中空の円筒（スペーサー？） | φ9×10 |
| `shitanoyatu bunkatsu.stl` | 印刷用に部品を並べた配置 | — |
| `keyboard sagyo.FCStd` / `stl okiaba.FCStd` / `mimisen.FCStd` | FreeCADの作業ファイル | — |
| `Top_Left/Top_Right/Bottom.stl` | 左右分割の曲線形キーボード部品（他所からのダウンロードと思われる。今回の60%とは別物） | 153.7×133.9 |

**印刷設定（`CE3PRO_Ashi_R.gcode` / `CE3PRO_sagyo3.3mf`）**
- PLA、ノズル198℃、ベッド60℃、積層0.2mm、速度40mm/s
- ラフトあり（マージン7mm）、サポートあり、インフィル三角形
- 足（Ashi_R、厚さ4mm）1本で**約6.5時間・フィラメント16.1m**（ラフト＋サポートで時間が大きく増えている）

## 5. レーザー用の積層ケース図面（2月末〜3月上旬）

**swillkb Plate & Case Builder の設定**（スクリーンショット2枚より）
- スタビ：Cherry only
- ケース：Sandwich（積層）
- USB切り欠き：位置 −124.3（GH60標準）、幅10mm
- 取付穴：8個、φ3mm、外周から14mm
- 外周余白：最初21mm → **18mm** → **14mm** と縮小
- 角R：7mm

| フォルダ・ファイル | 余白 | 外形（mm） |
|---|---|---|
| `33a57e43…_switch/open/closed/bottom.svg`、`TOP plate.svg`、`btm plate.svg` | 21mm | 337.75×147.25 |
| `18/18plate・18Open・18bottom.svg` | 18mm | 331.75×141.25 |
| `18/14palte・14open.svg` | 14mm | 323.75×133.25 |
| `18/14/14plate-kad・14flame-kad.svg`（Inkscapeで角を加工） | 14mm | 334.05×143.45 |
| `18/14-315*.svg`、`14bottom-kad.svg` | — | 315.0×123.45 |
| `18/14/新しいフォルダー/2025-03-05.svg` | — | 335×146（最終案：プレート＋枠＋取付穴8個、左上に**矢絣（やがすり）模様**） |
| `yagasuri.svg` | — | 矢絣模様の素材 |

その他：`kbplate.svg`・`kbplate(1).svg` は中身が空（ai03の出力に失敗したもの）、`hairetu.txt` は空、`*.FCBak` はFreeCADの自動バックアップ。`3822-…DZ60-V3….webp` は販売ページのDZ60基板写真（シルクに「20190706 DZ60」）。

## 6. 今回に活かせること

1. **配列**：旧配列と照合して、KLEのCaps段（13→12個）と決定事項の下段表記（1u×6→1u×5）を直す。
2. **キーマップ**：`dz60.layout.json` のFnレイヤー（テンキー・マウスキー・F列）をそのまま流用できる。
3. **印刷設定**：Ender-3 Pro・PLA 198℃/60℃・0.2mmの実績値がある。ただし平たい部品はラフト＋サポートなしで刷れる形にしないと時間がかかりすぎる。
4. **3Dプリント上板の厚み**：旧上板は4mm厚。MXスイッチのツメは1.5mm前後の板厚でかかるため、今回プレートを1.5mmのレーザー加工にした方針は妥当。
5. **積層ケースの代替案**：swillkbのSandwich設定（余白14mm・取付穴8個φ3・角R7）が残っているので、3Dプリントで行き詰まったときのレーザー積層ケース案の出発点にできる（`事例とアイデア.md` の代替案と同じ方向）。
6. **矢絣模様**：デザイン案として残っている。今回のケースやプレートの装飾に使える。

## 7. 未判明・要確認
- 旧プロジェクトで実際に何を印刷・切断したか（gcodeは足1本分のみ）
- 旧プロジェクトのPCBが今回と同じDZ60 V2か
- 決定事項の「Ender-3の機種」は、Curaの設定から **Ender-3 Pro** と思われる（本人確認で確定）
