Pinticketaro/DZ-GH-60_keyboard/case/rod_drawing_v09.pdf

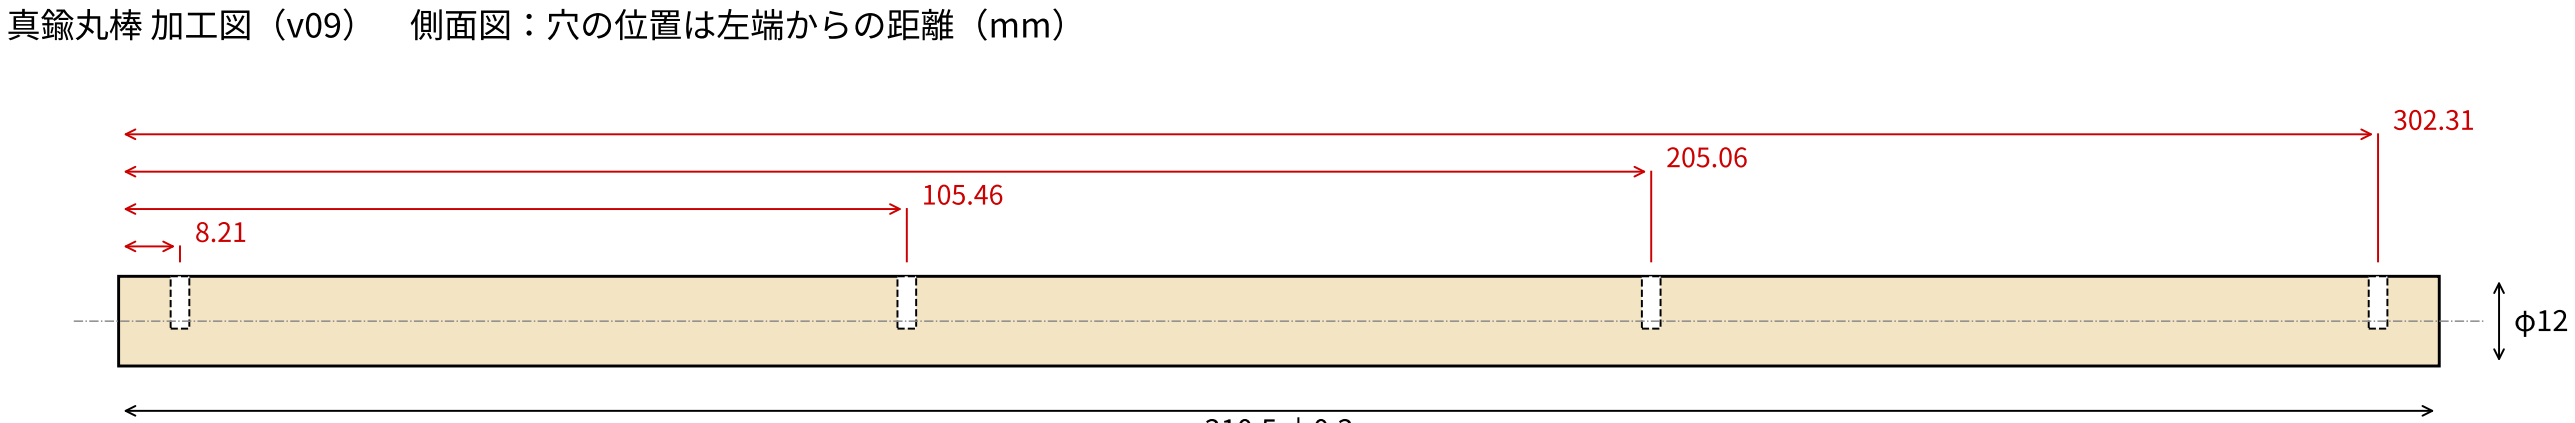
[picture p1: figure]
真鍮丸棒 加工図（v09） 側面図：穴の位置は左端からの距離（mm）

310.5 ±0.3

深さ7

断面（穴は中心に向かって垂直）
・材料：快削黄銅 C3604　丸棒 φ12

# ・長さ：310.5 ±0.3 両端面：直角に仕上げ、C0.5面取り

・横穴：4か所。下穴φ2.5 深さ7 → M3×0.5 タップ（有効ねじ深さ5以上）

・4穴は同じ母線（一直線）上、丸棒の中心軸に向かって垂直

・穴位置の許容：±0.3（相手側の穴をφ4にしてある）

# ・使用ボルト：M3×20 ボタンヘッド（ねじ込み約4.4mm）

・表面：仕上げ自由（磨き・ヘアライン）。変色を止めるならクリア塗装
