Pinticketaro/DZ-GH-60_keyboard/docs/img/color_variants_v12.png

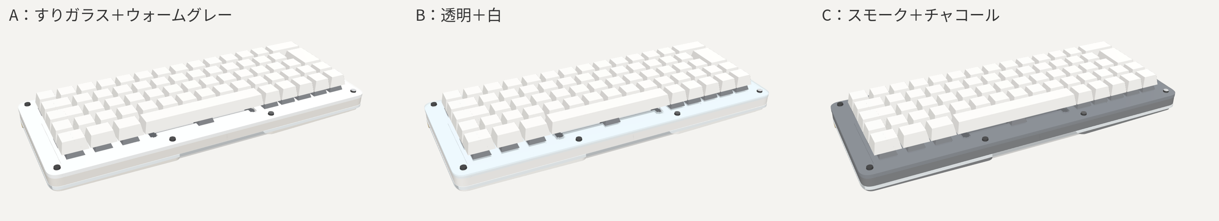
docs/img/color_variants_v12.png
