Pinticketaro/DZ-GH-60_keyboard/docs/img/corner_compare.png

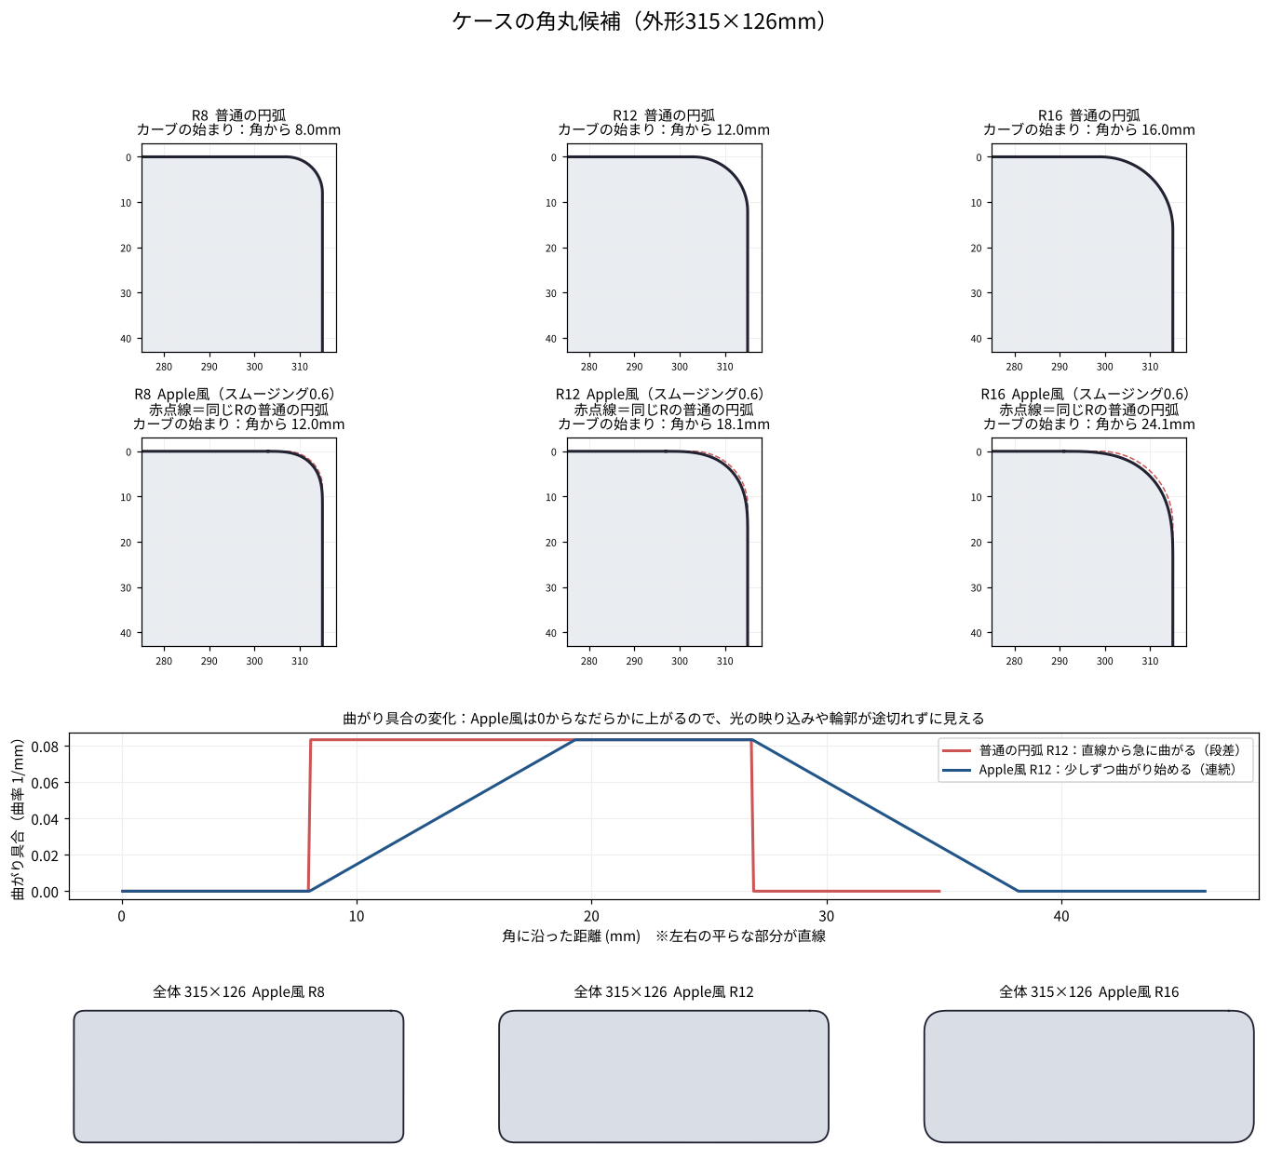
docs/img/corner_compare.png
