Pinticketaro/DZ-GH-60_keyboard/docs/img/drawings_v14_p1.png

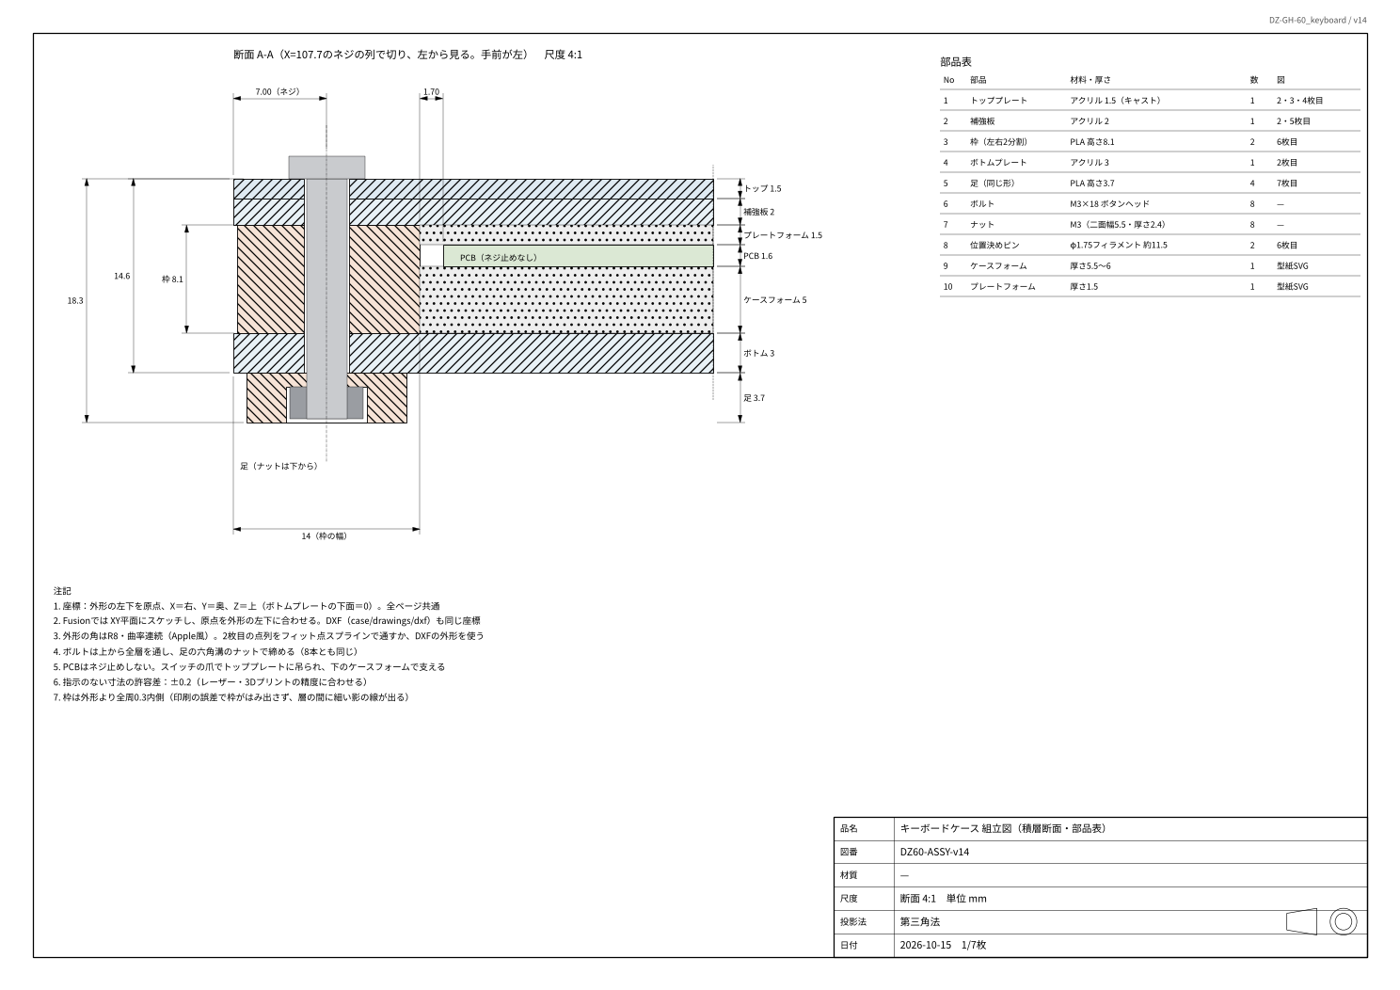
docs/img/drawings_v14_p1.png
