Pinticketaro/DZ-GH-60_keyboard/docs/img/drawings_v14_p2.png

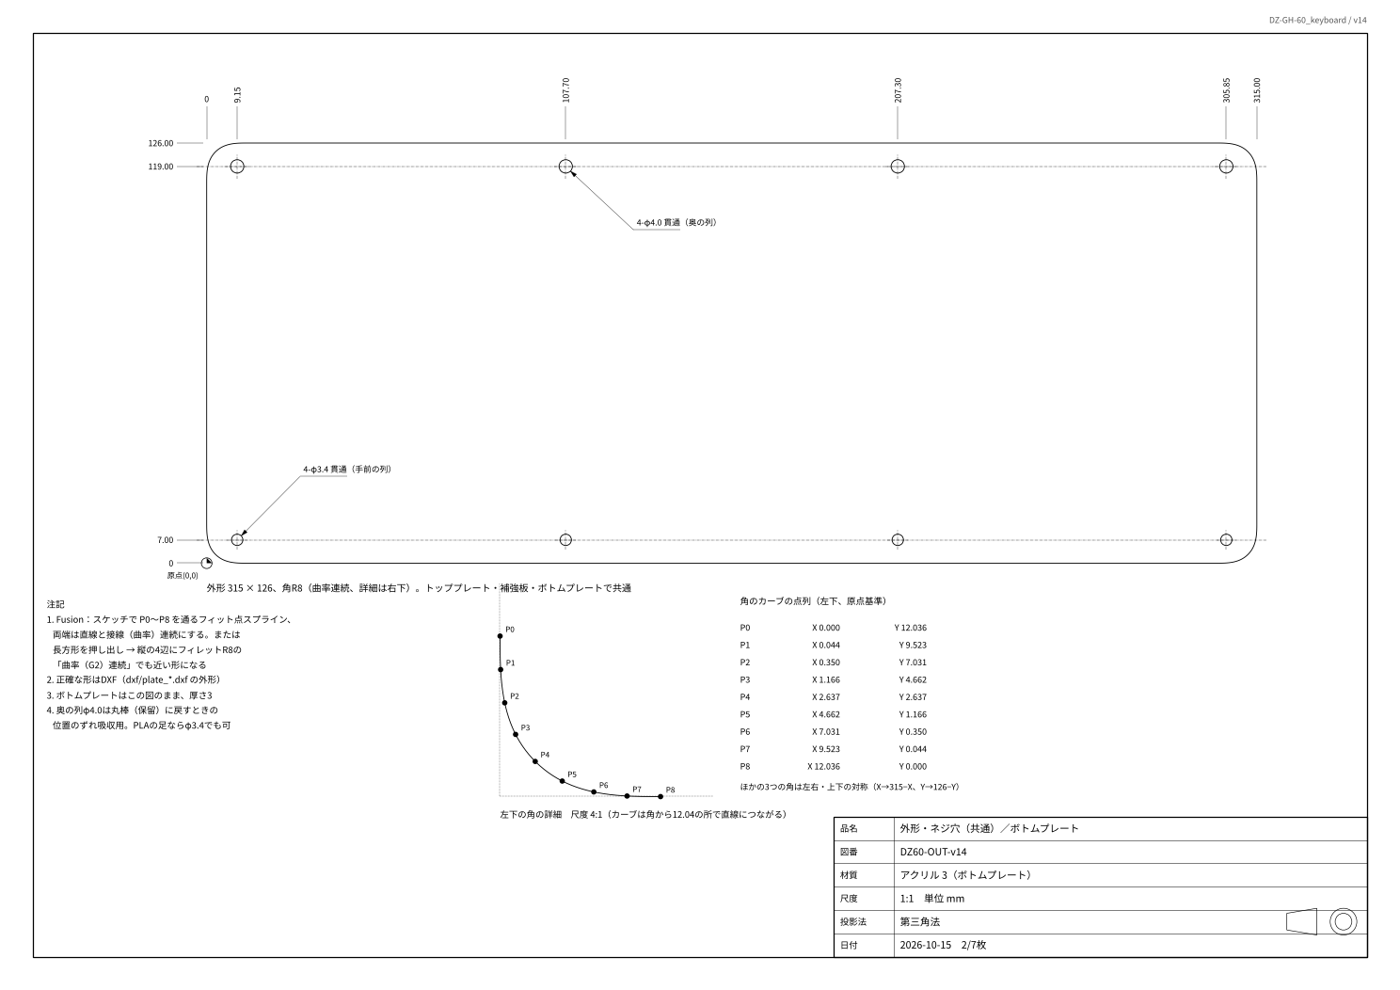
docs/img/drawings_v14_p2.png
