Pinticketaro/DZ-GH-60_keyboard/docs/img/drawings_v15_p3.png

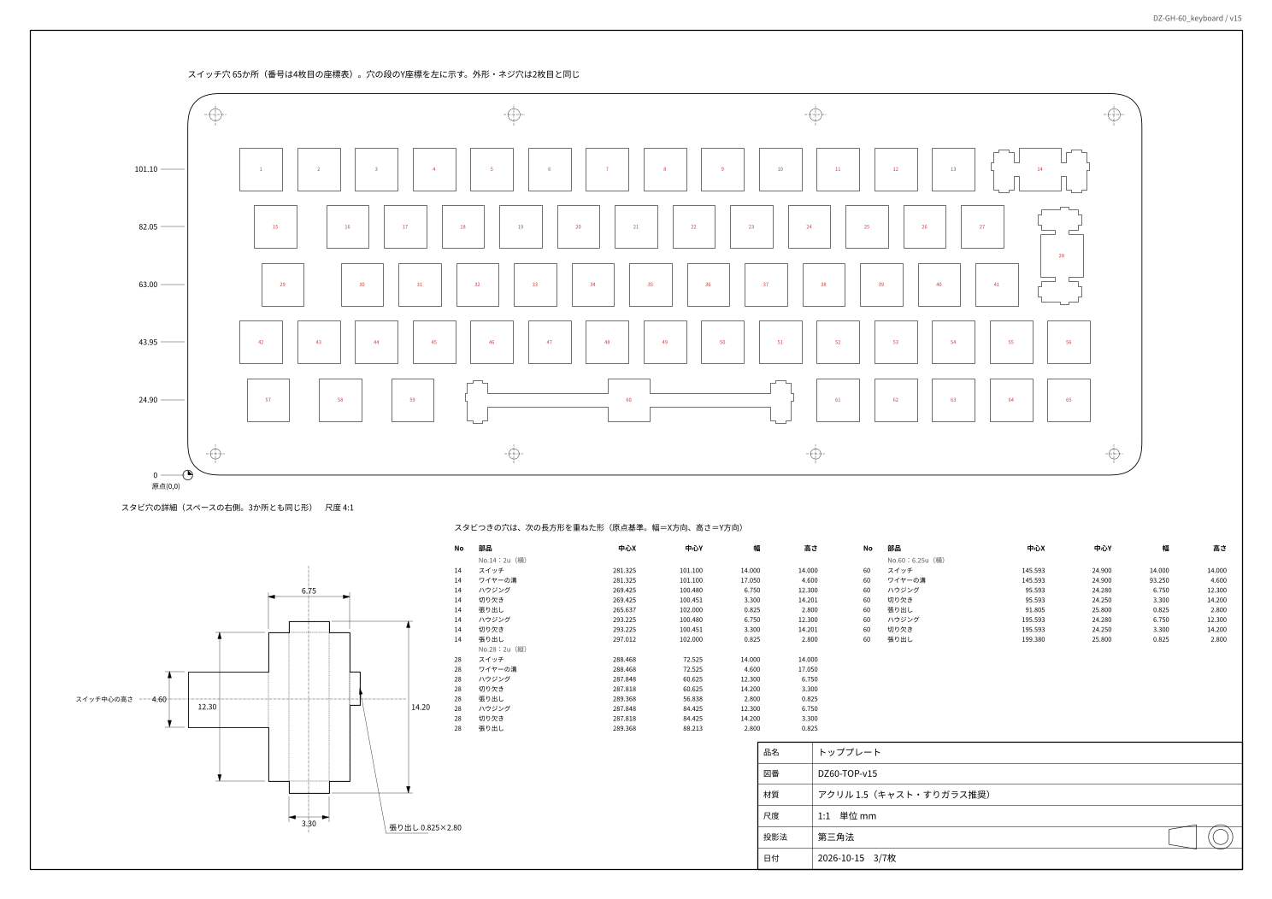
docs/img/drawings_v15_p3.png
