Pinticketaro/DZ-GH-60_keyboard/docs/img/drawings_v16_p6.png

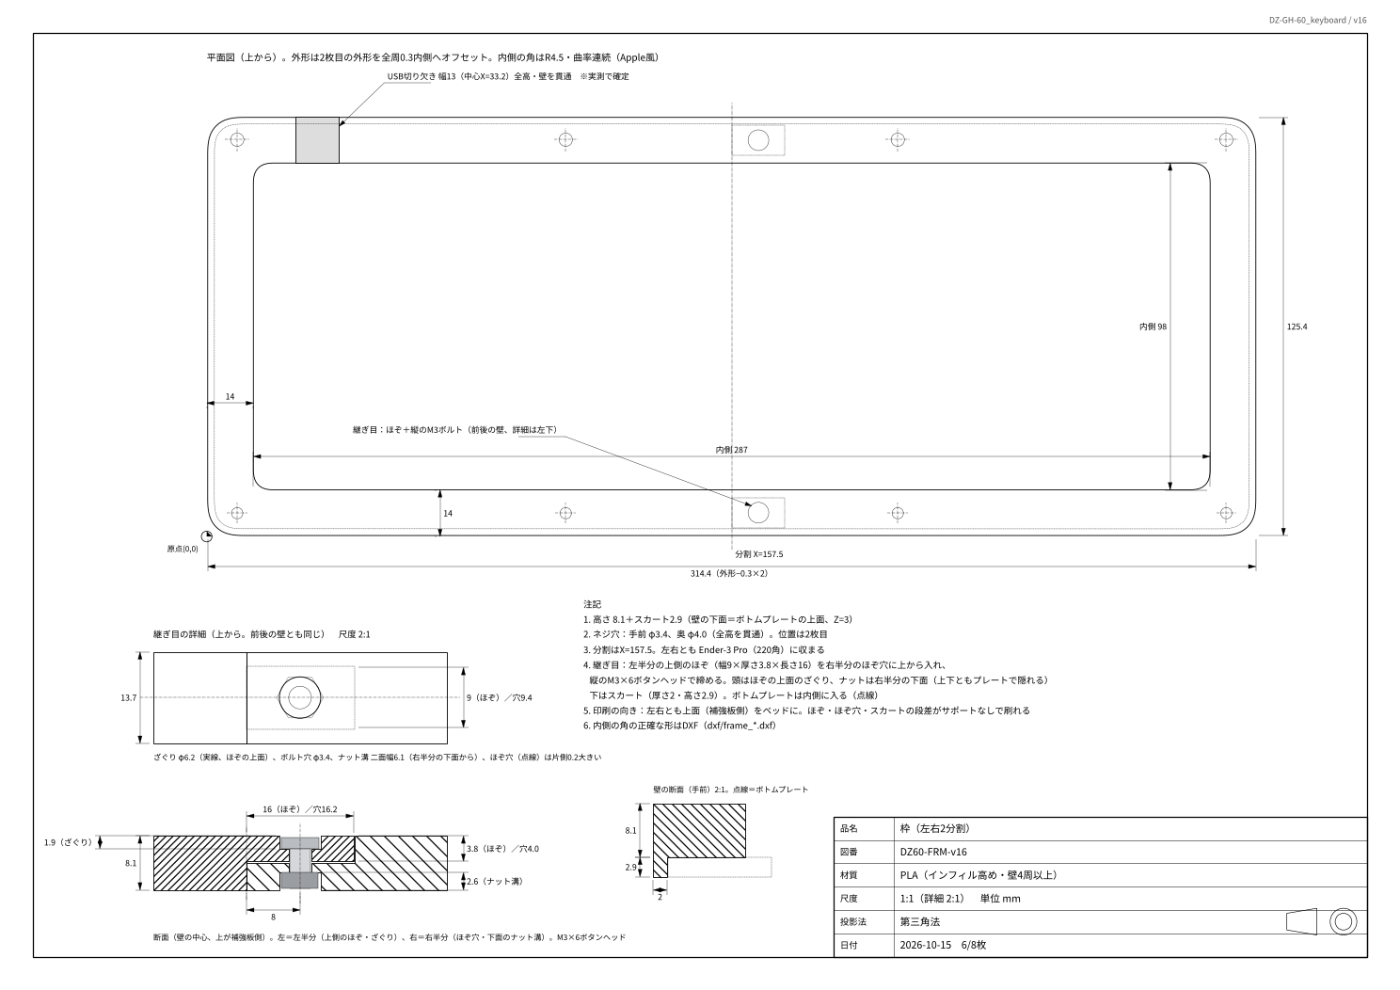
docs/img/drawings_v16_p6.png
