Pinticketaro/DZ-GH-60_keyboard/docs/img/drawings_v16_p8.png

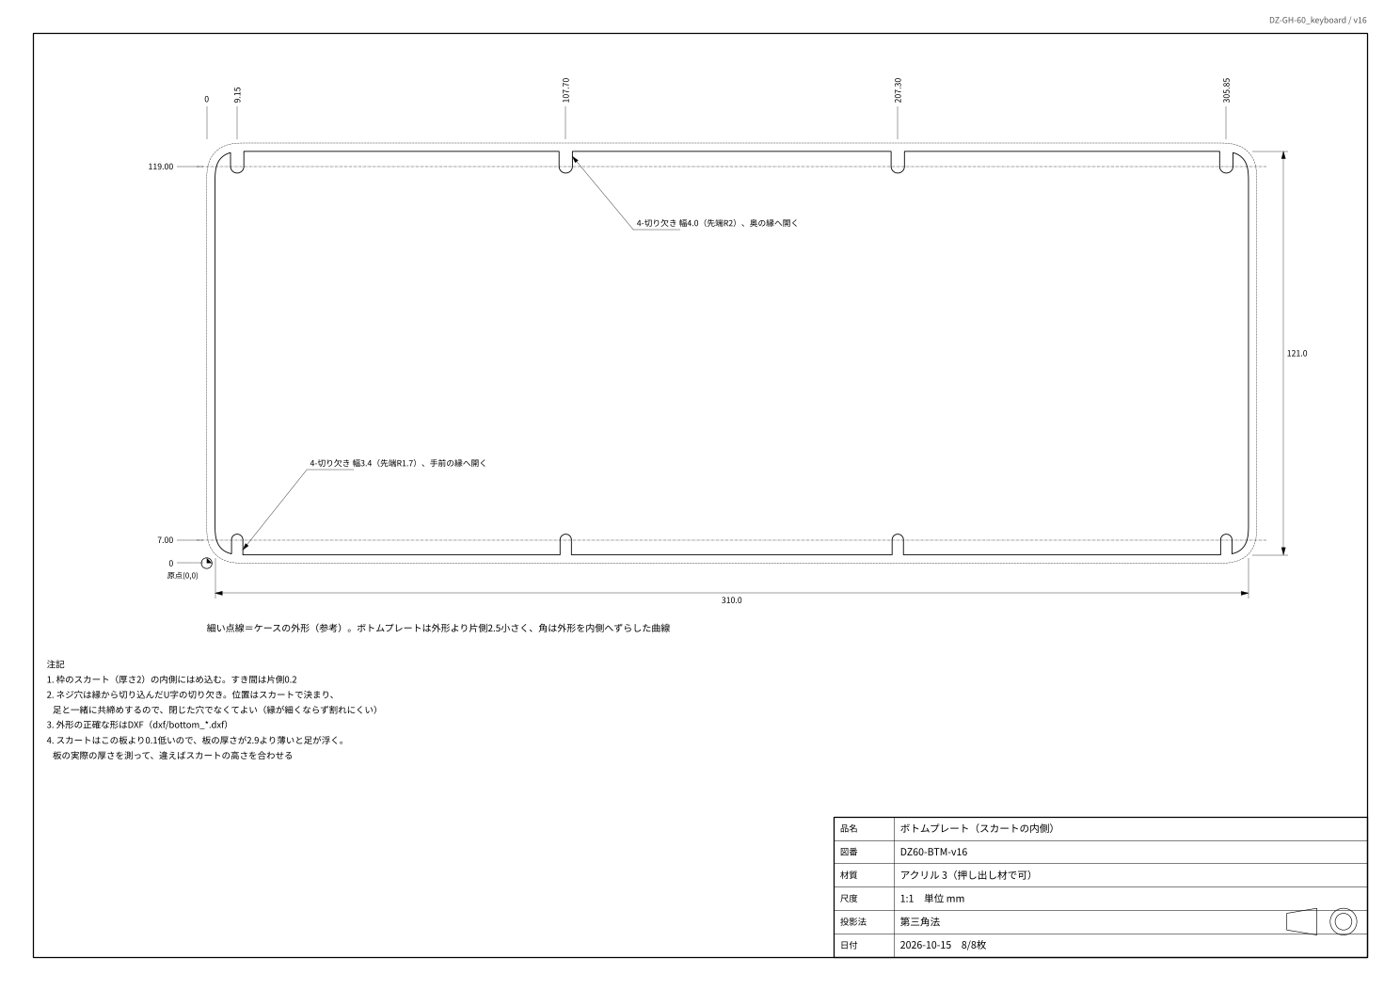
docs/img/drawings_v16_p8.png
