Pinticketaro/DZ-GH-60_keyboard/docs/img/joint_v15.png

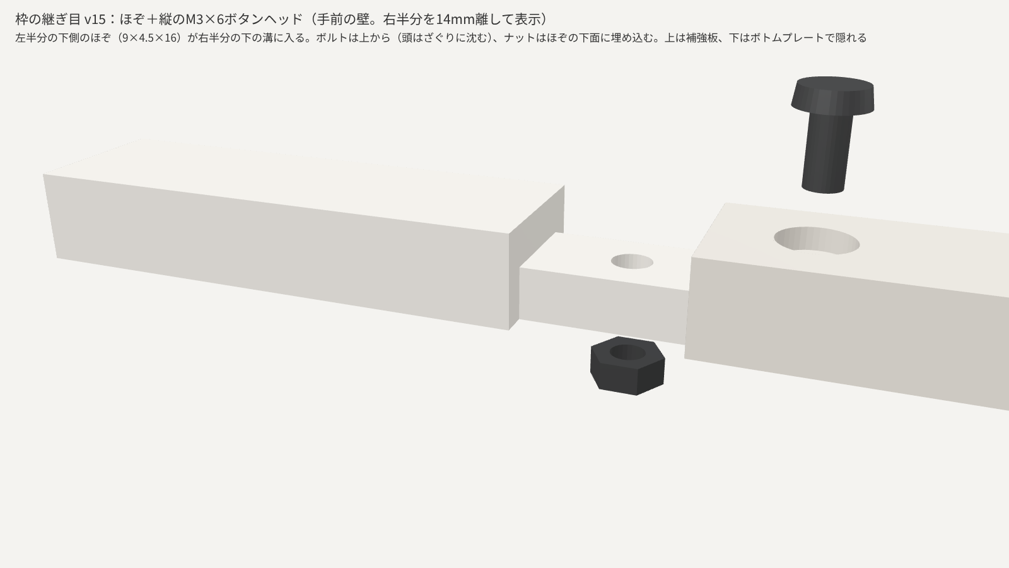
docs/img/joint_v15.png
