Pinticketaro/DZ-GH-60_keyboard/docs/img/joint_v16.png

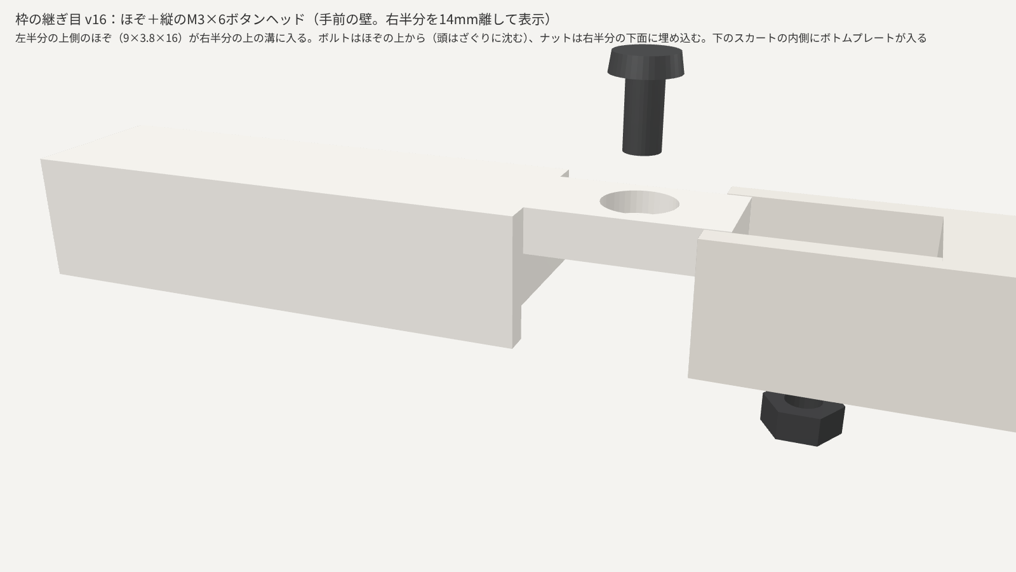
docs/img/joint_v16.png
