Pinticketaro/DZ-GH-60_keyboard/docs/img/overlay_v01.png

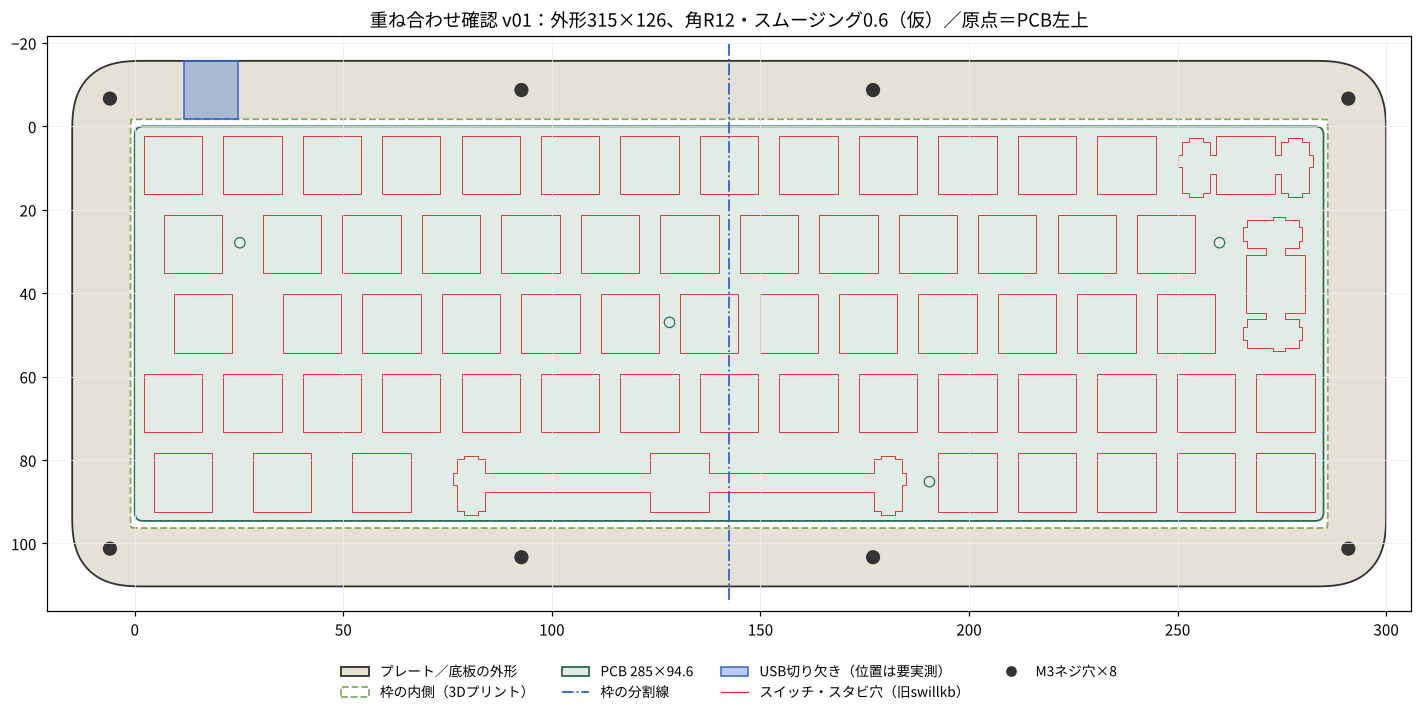
docs/img/overlay_v01.png
