Pinticketaro/DZ-GH-60_keyboard/docs/img/overlay_v04.png

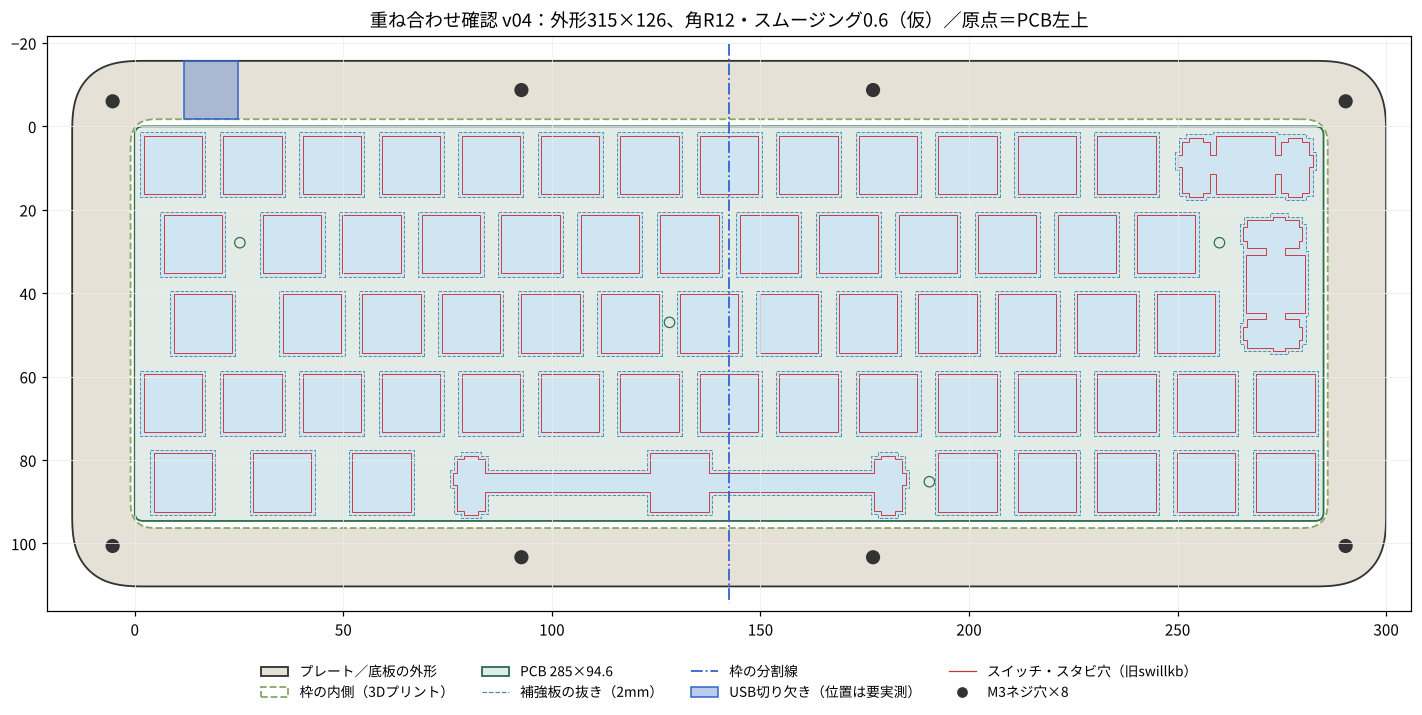
docs/img/overlay_v04.png
