Pinticketaro/DZ-GH-60_keyboard/docs/img/overlay_v06.png

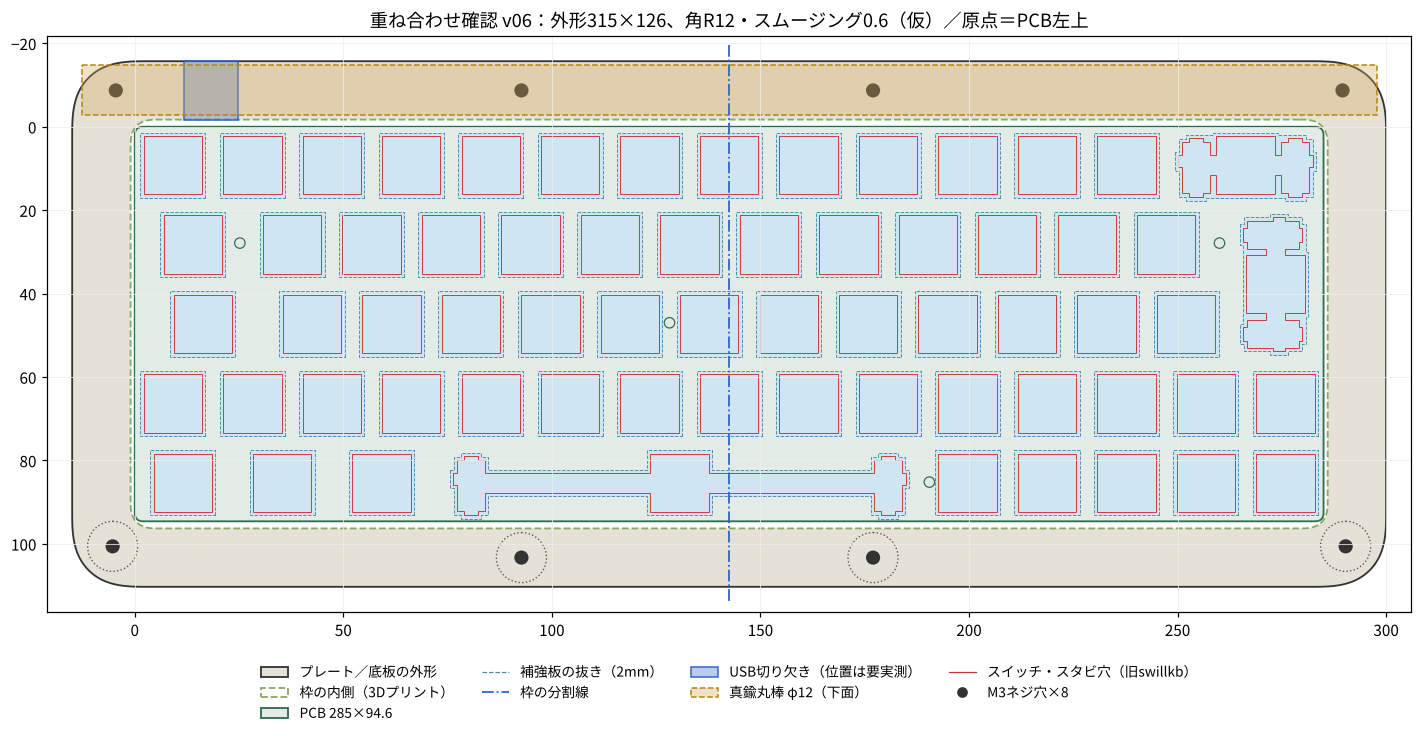
docs/img/overlay_v06.png
