Pinticketaro/DZ-GH-60_keyboard/docs/img/overlay_v08.png

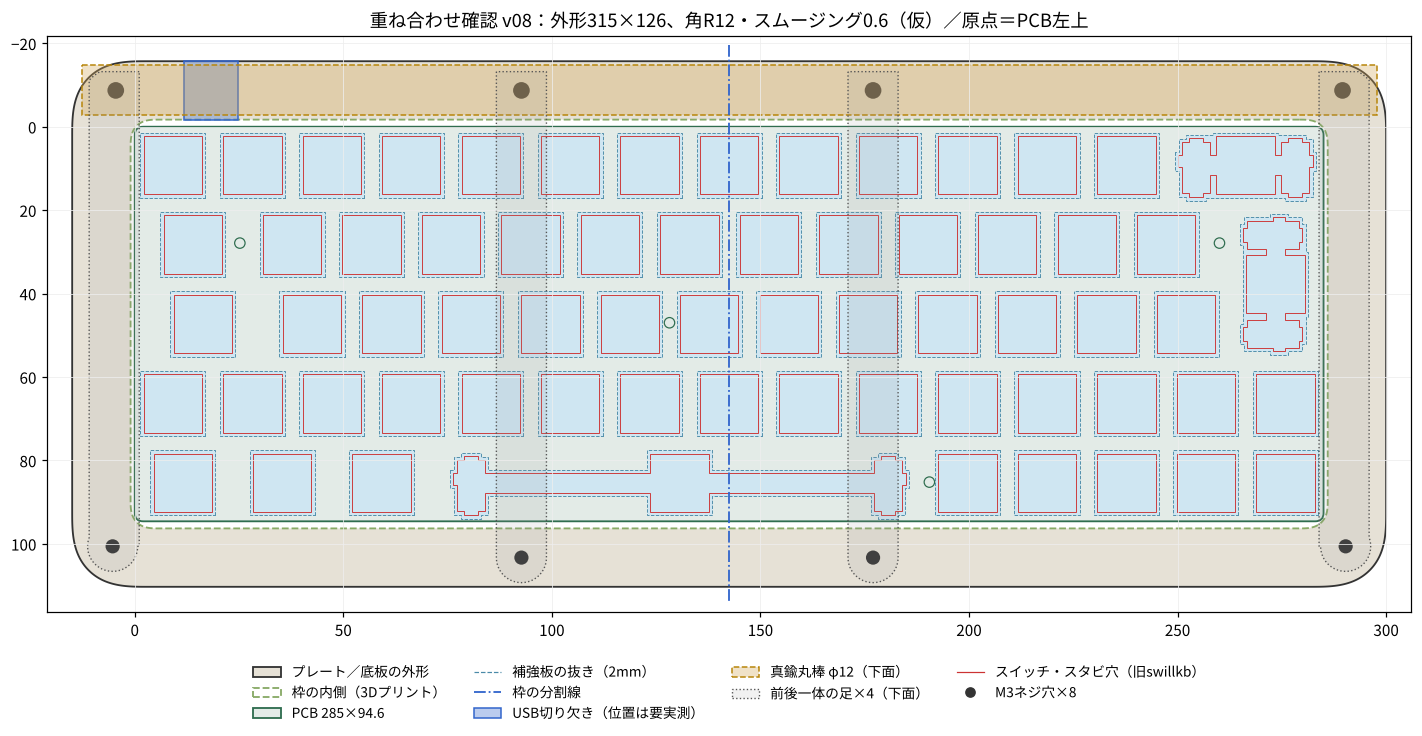
docs/img/overlay_v08.png
