Pinticketaro/DZ-GH-60_keyboard/docs/img/overlay_v09.png

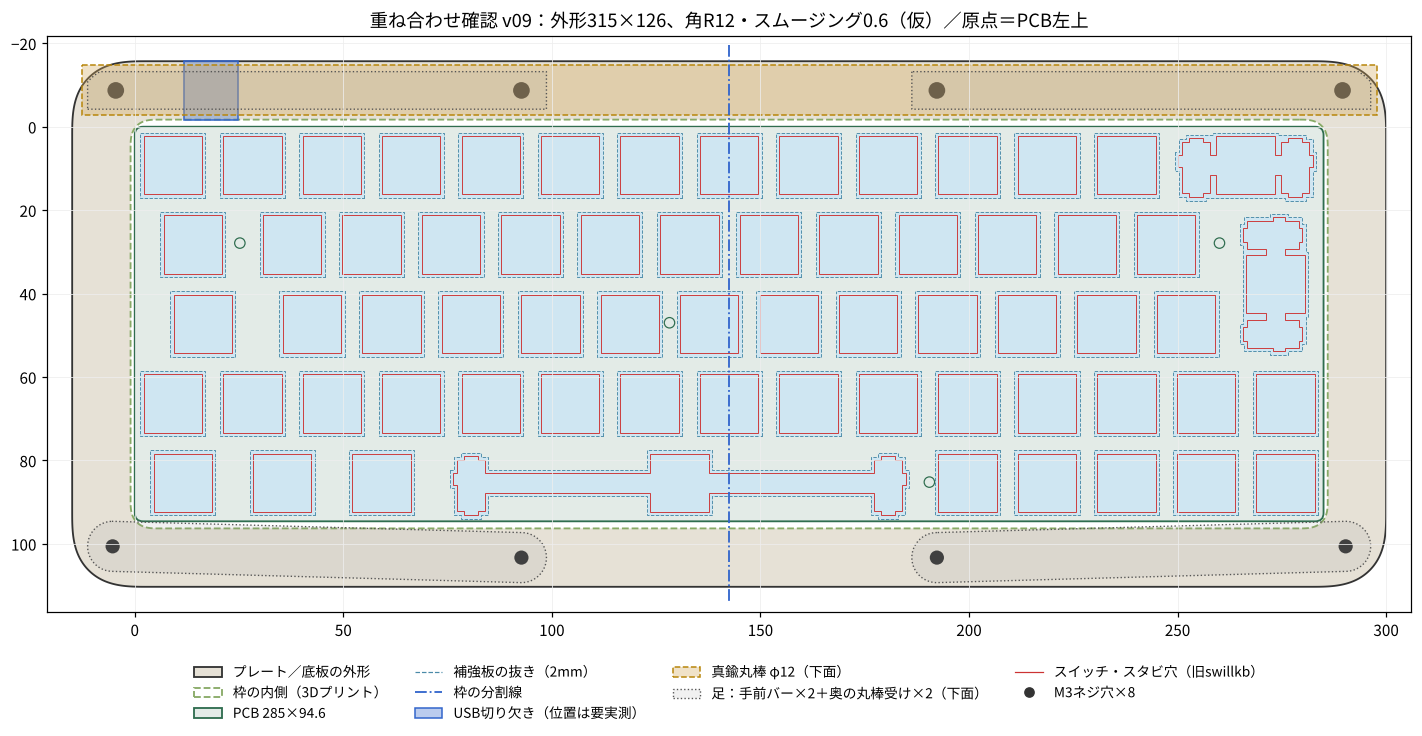
docs/img/overlay_v09.png
