Pinticketaro/DZ-GH-60_keyboard/docs/img/overlay_v13.png

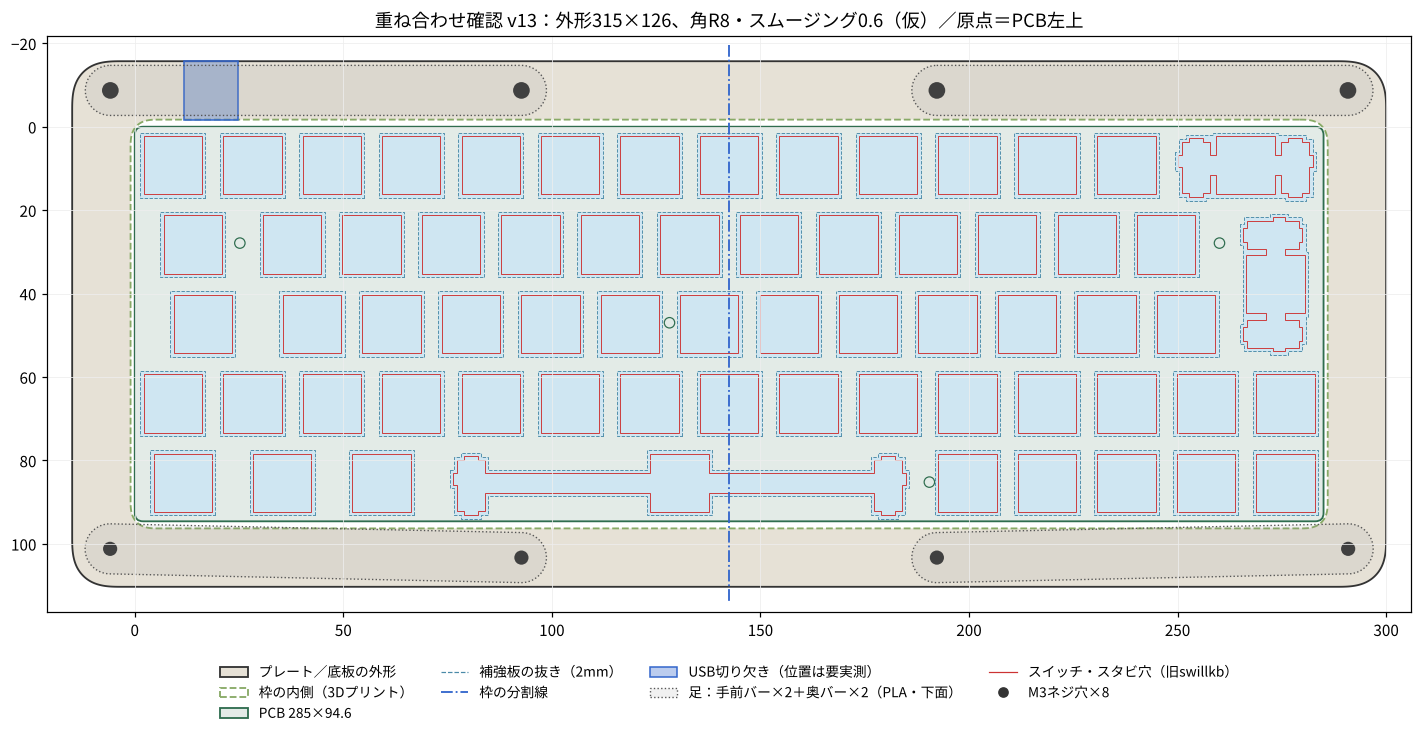
docs/img/overlay_v13.png
