Pinticketaro/DZ-GH-60_keyboard/docs/img/preview_v05.png

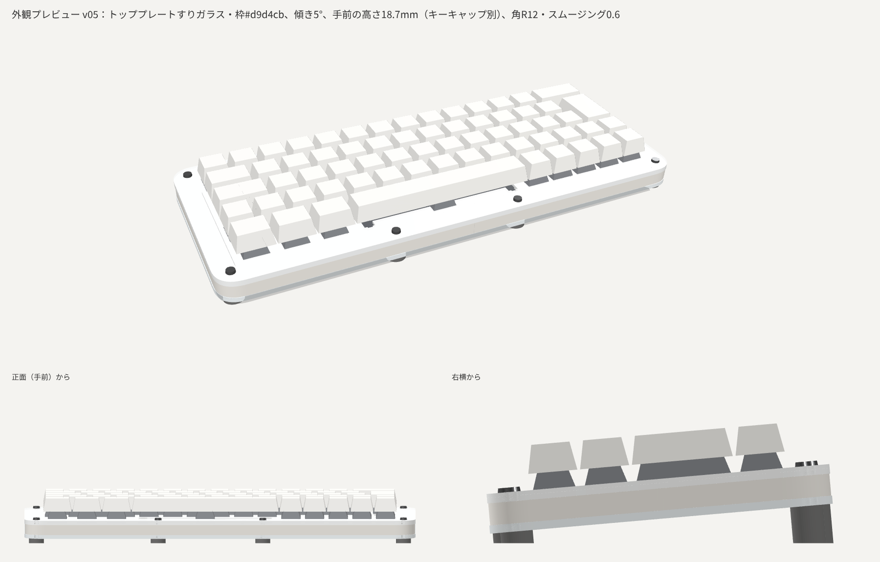
docs/img/preview_v05.png
