Pinticketaro/DZ-GH-60_keyboard/docs/img/preview_v06.png

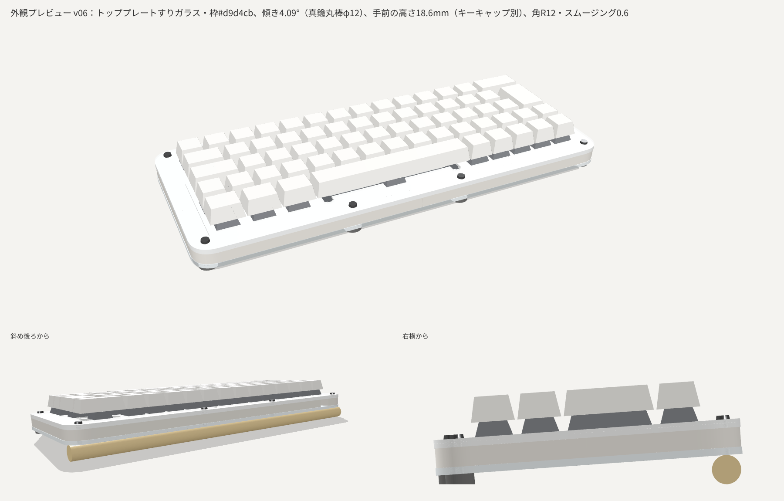
docs/img/preview_v06.png
