Pinticketaro/DZ-GH-60_keyboard/docs/img/preview_v14.png

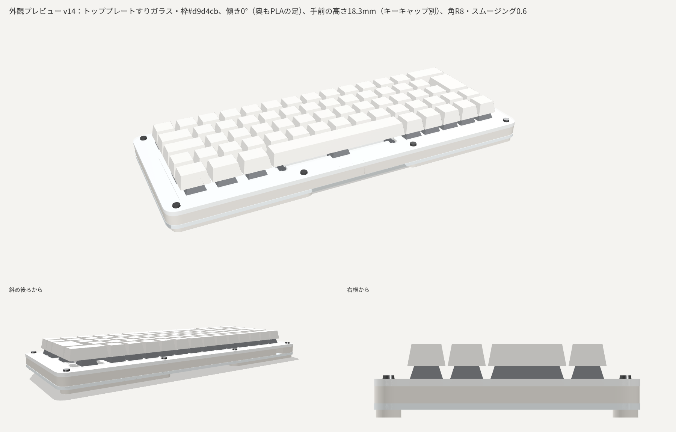
docs/img/preview_v14.png
