Pinticketaro/DZ-GH-60_keyboard/docs/img/rod_drawing_v07.png

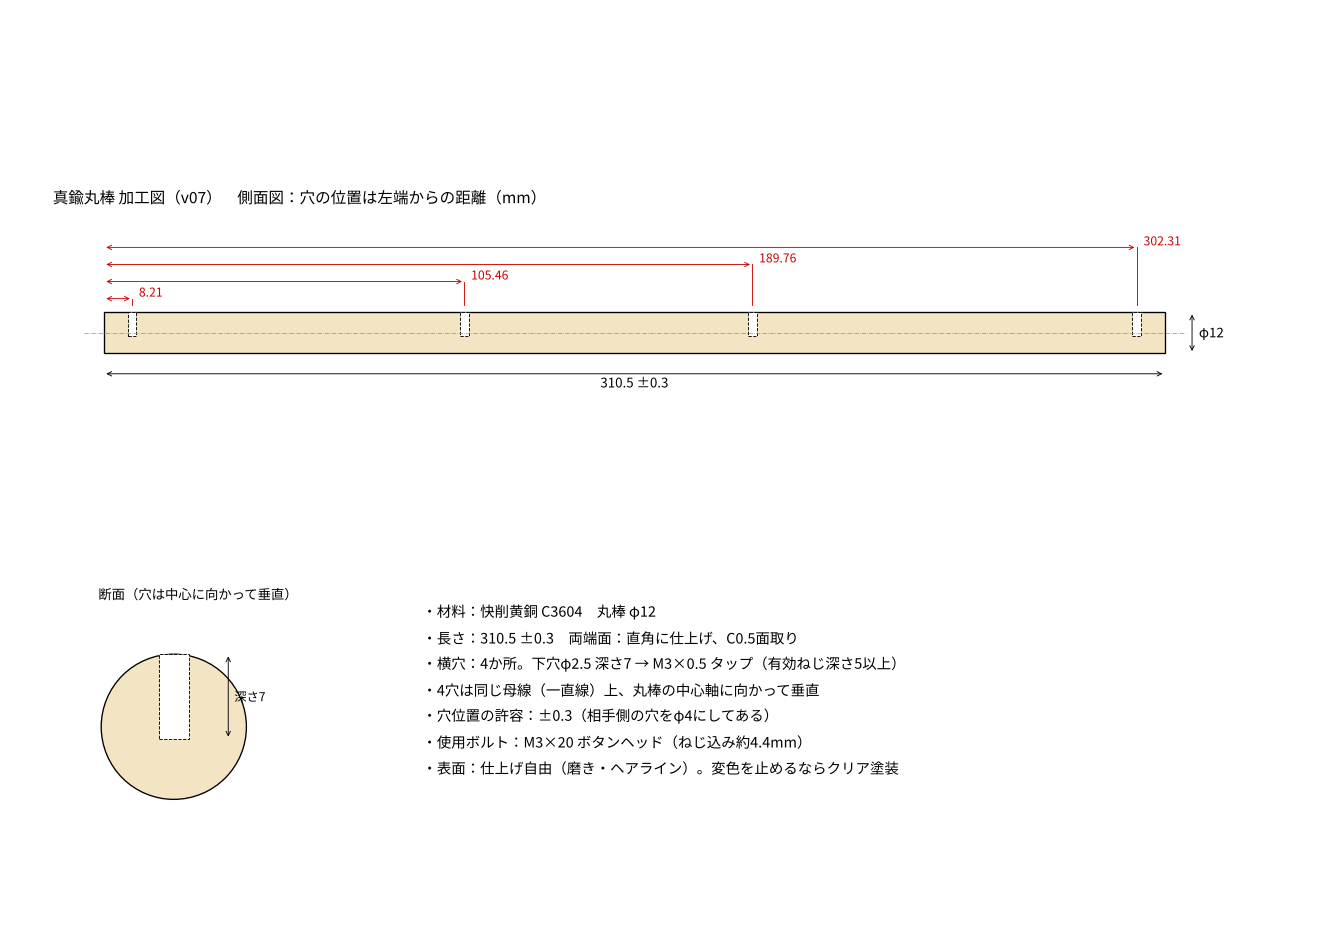
docs/img/rod_drawing_v07.png
