Pinticketaro/DZ-GH-60_keyboard/docs/img/rod_drawing_v12.png

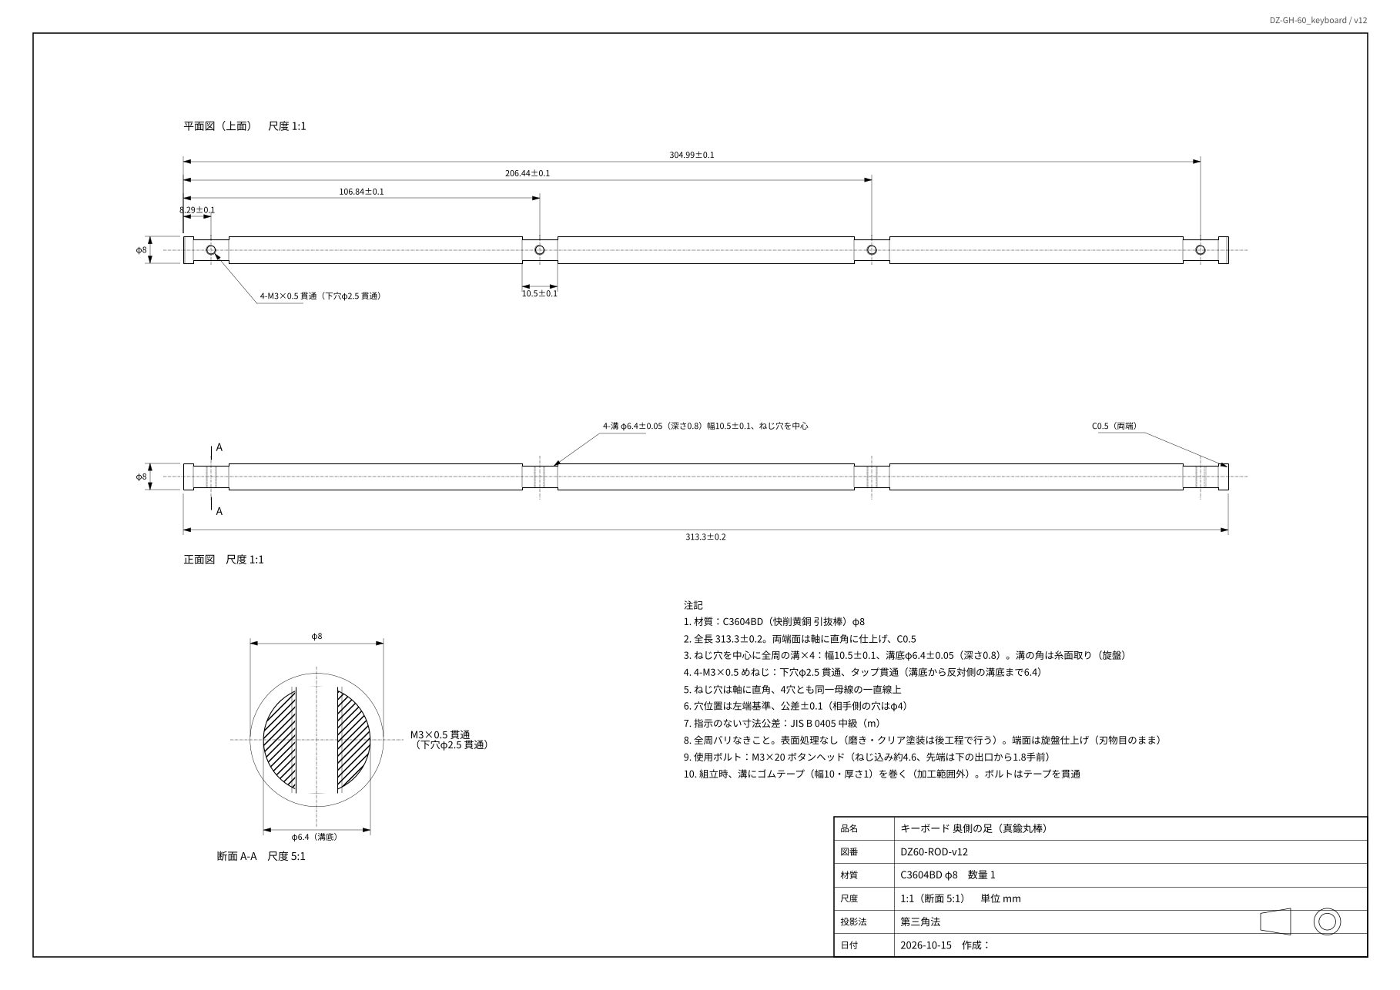
docs/img/rod_drawing_v12.png
