Pinticketaro/DZ-GH-60_keyboard/docs/img/rod_mount_v06.png

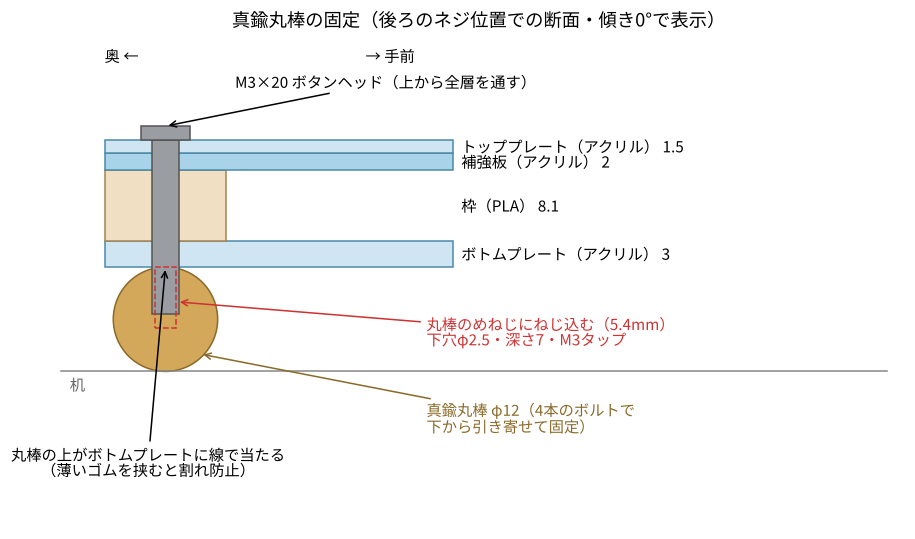
docs/img/rod_mount_v06.png
