Pinticketaro/DZ-GH-60_keyboard/docs/img/rod_mount_v07.png

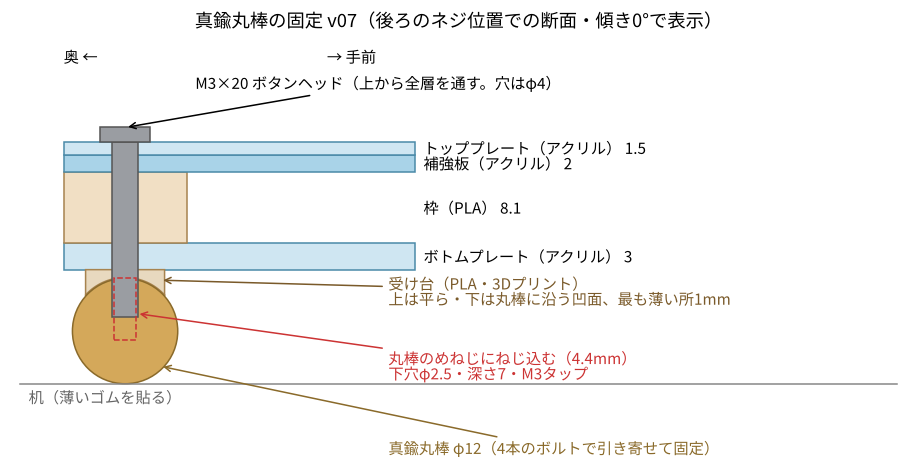
docs/img/rod_mount_v07.png
