Pinticketaro/DZ-GH-60_keyboard/docs/img/section_v03.png

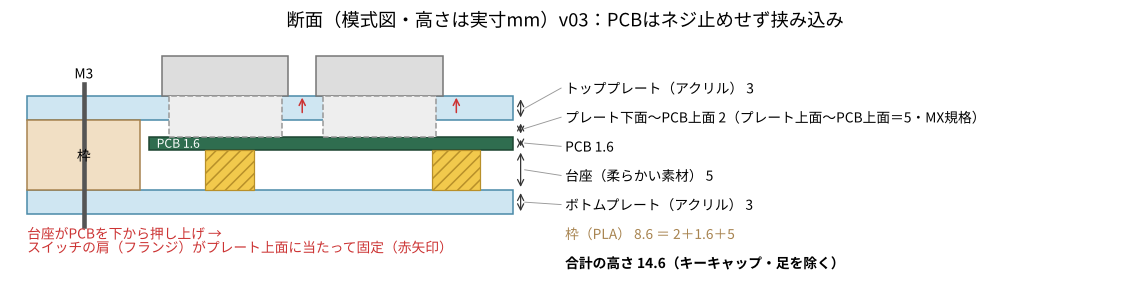
docs/img/section_v03.png
