Pinticketaro/DZ-GH-60_keyboard/docs/img/section_v04.png

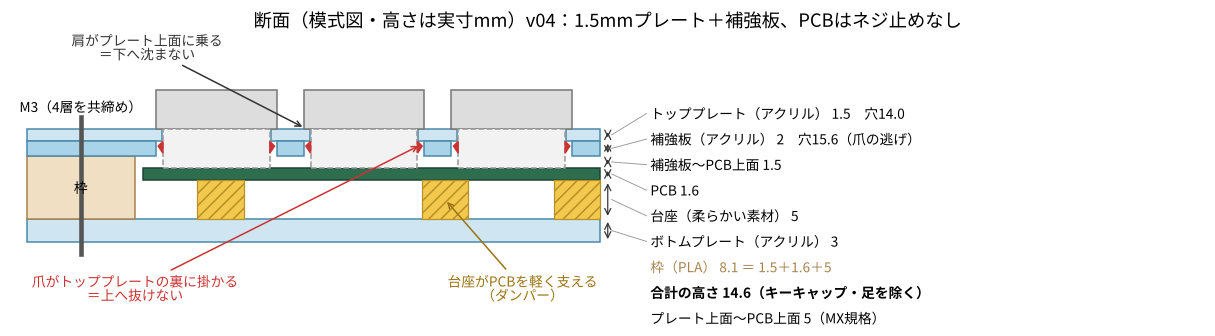
docs/img/section_v04.png
