Pinticketaro/DZ-GH-60_keyboard/docs/img/side_compare_v15_v16.png

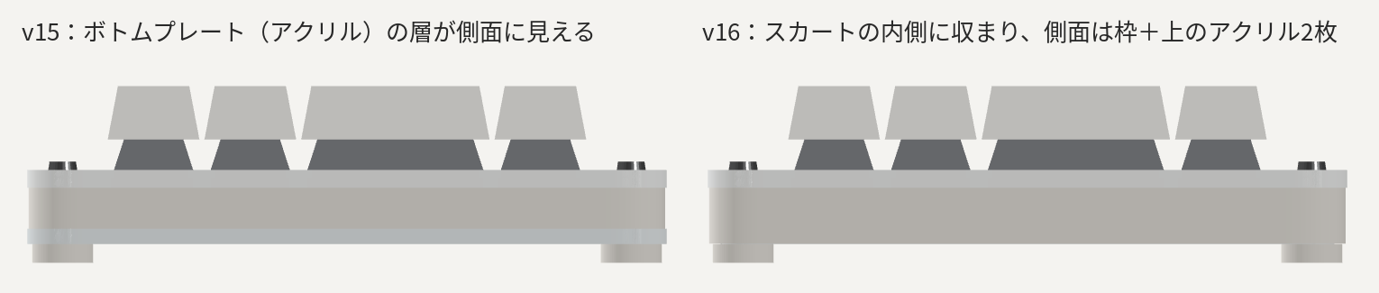
docs/img/side_compare_v15_v16.png
