Pinticketaro/DZ-GH-60_keyboard/out/v19/plan.png

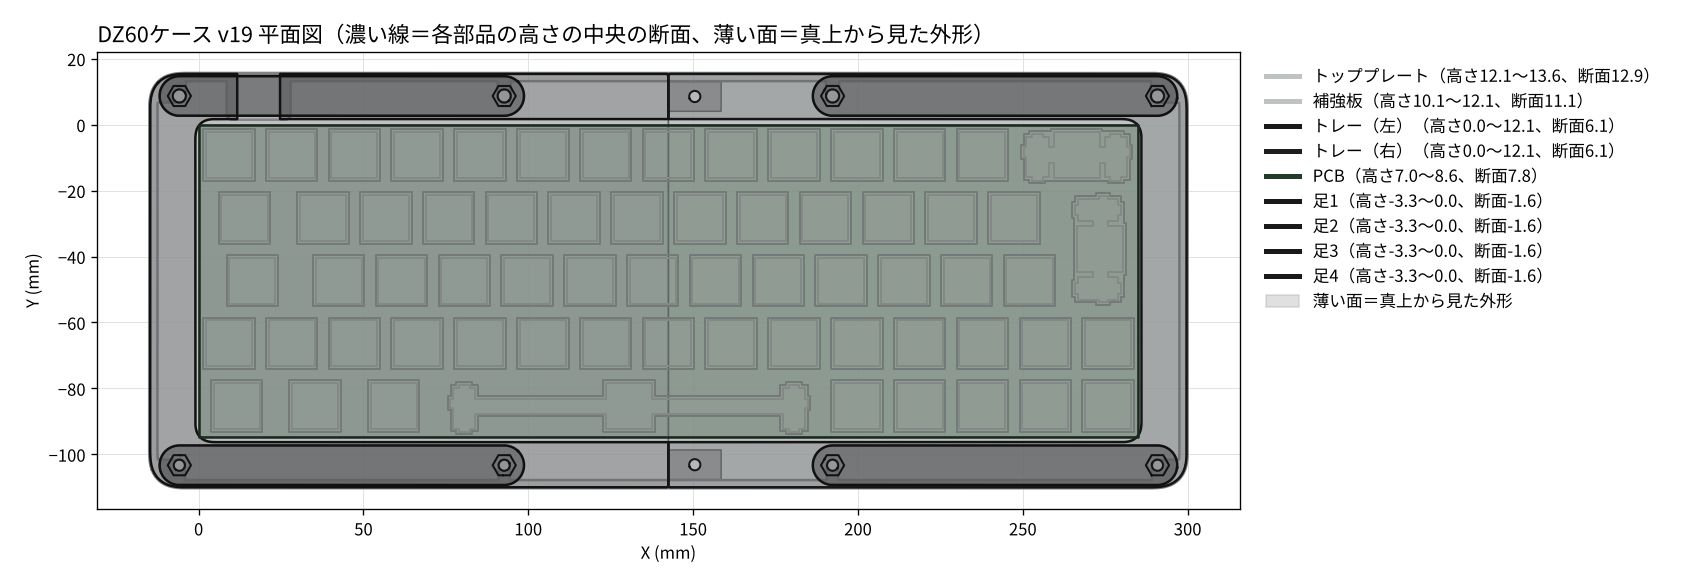
out/v19/plan.png
