Pinticketaro/DZ-GH-60_keyboard/out/v19/preview.png

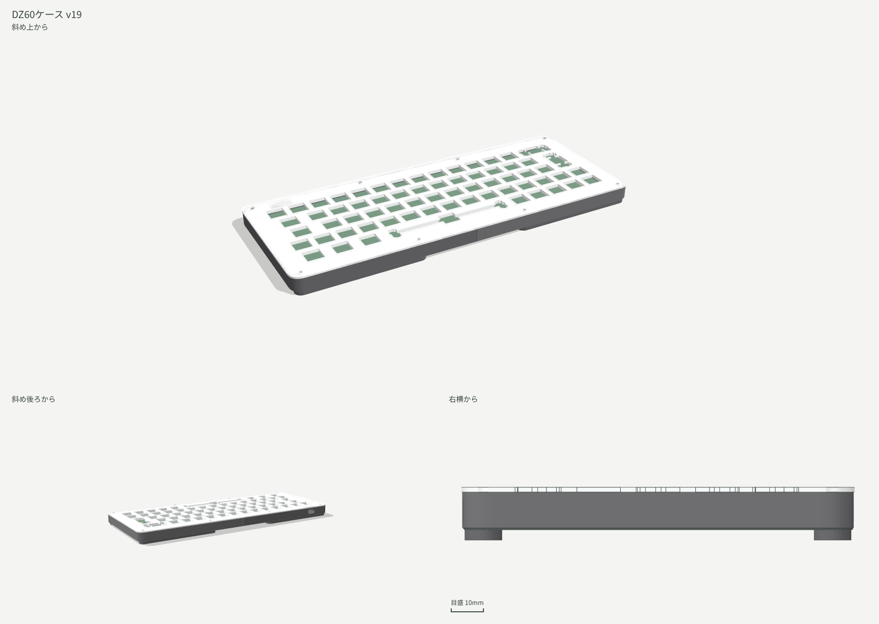
out/v19/preview.png
