Pinticketaro/DZ-GH-60_keyboard/out/v19/section.png

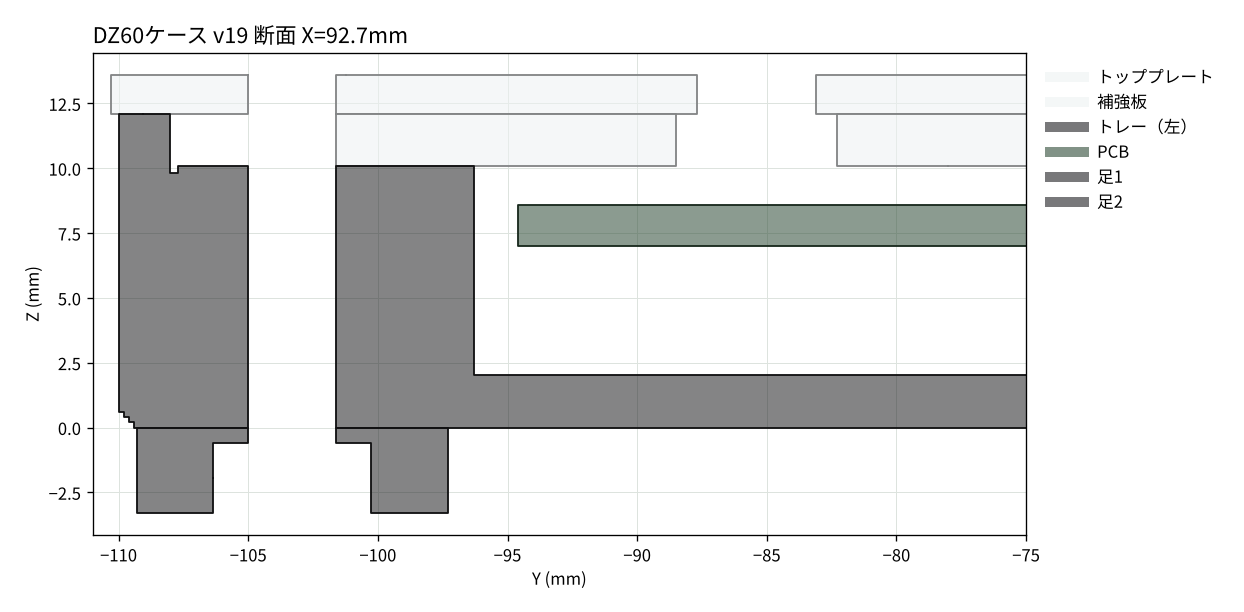
out/v19/section.png
