Pinticketaro/DZ-GH-60_keyboard/out/v19/section_joint.png

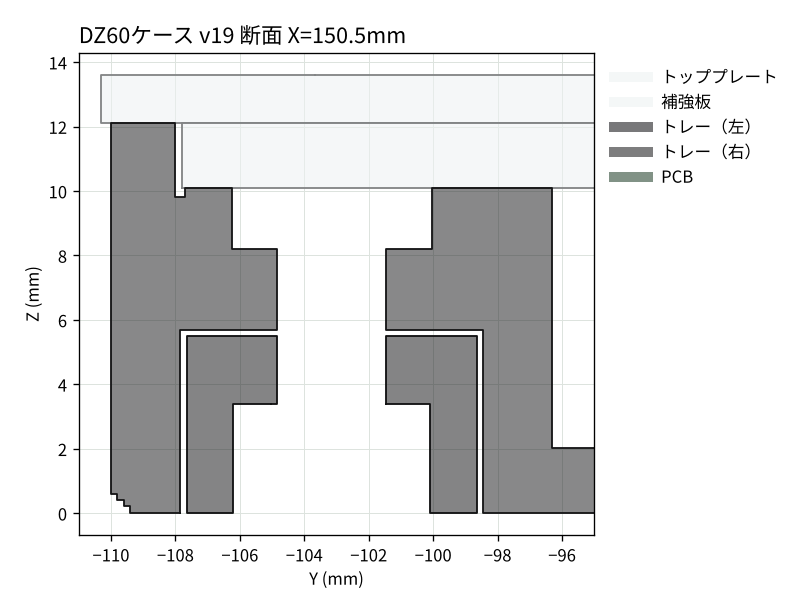
out/v19/section_joint.png
