Pinticketaro/DZ-GH-60_keyboard/out/v19/section_usb.png

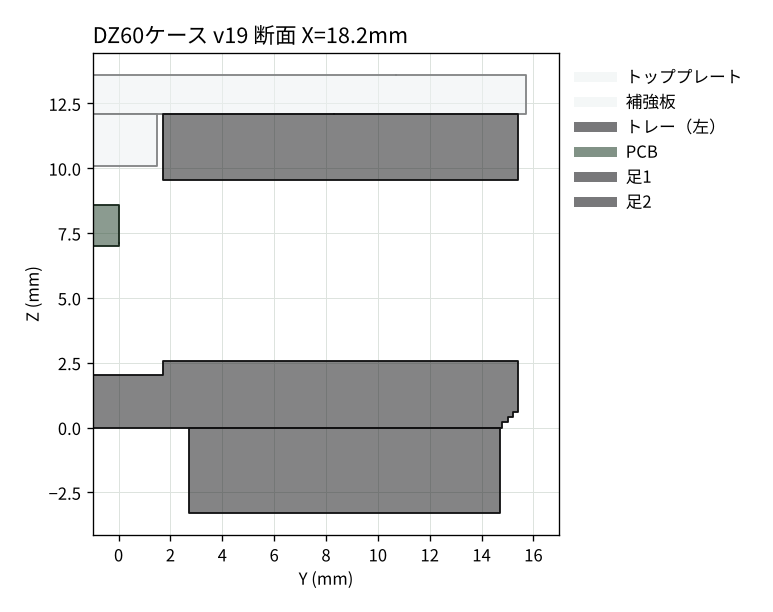
out/v19/section_usb.png
