Pinticketaro/DZ-GH-60_keyboard/out/v19/section_usb_v18b.png

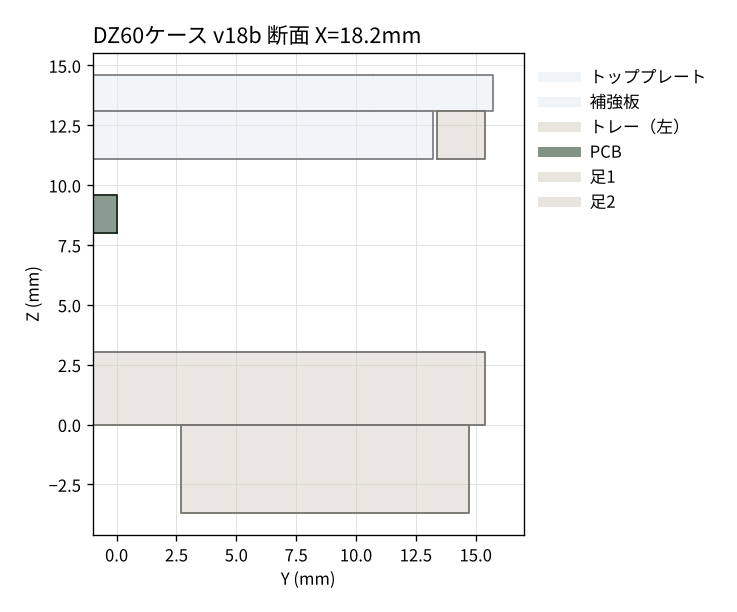
out/v19/section_usb_v18b.png
