Pinticketaro/DZ-GH-60_keyboard/out/v19/stiffener_notch.png

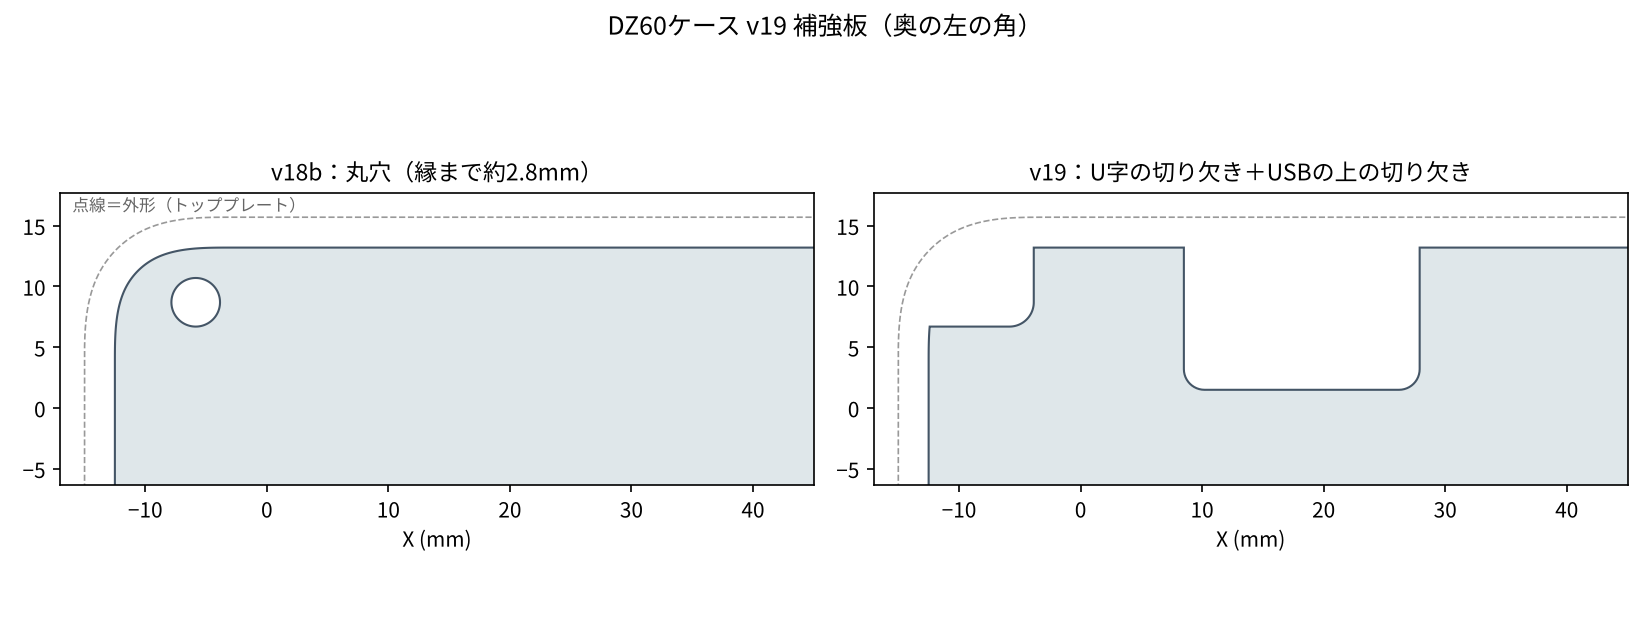
out/v19/stiffener_notch.png
