Pinticketaro/DZ-GH-60_keyboard/review/img/v18a/img06.webp

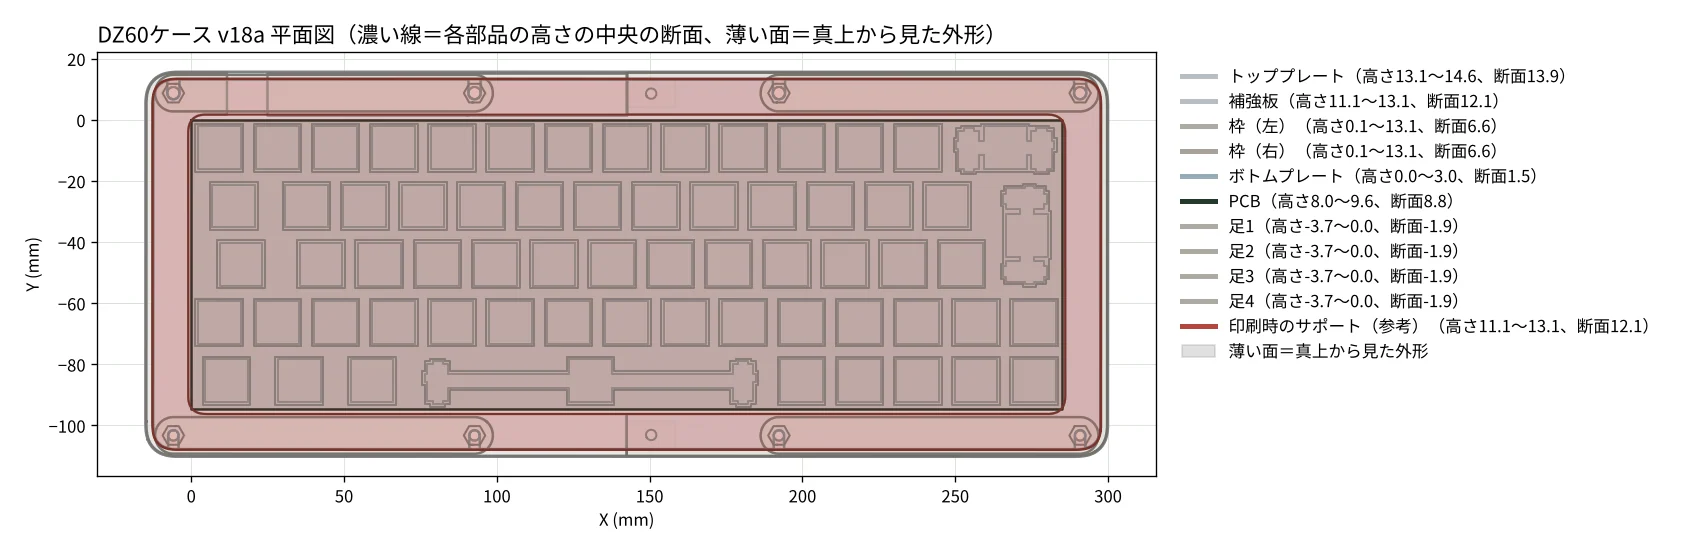
review/img/v18a/img06.webp
