Pinticketaro/DZ-GH-60_keyboard/review/img/v18b/img05.webp

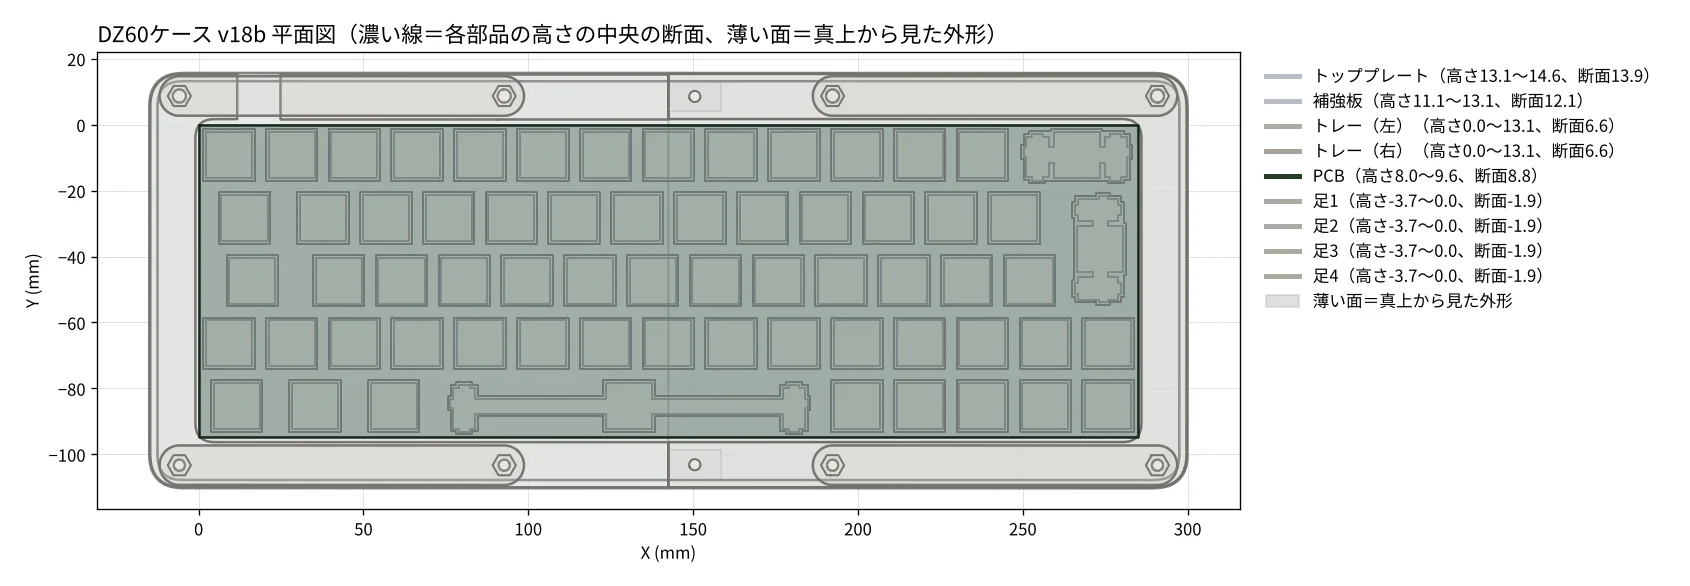
review/img/v18b/img05.webp
