Pinticketaro/DZ-GH-60_keyboard/review/img/v19/cmp03a.webp

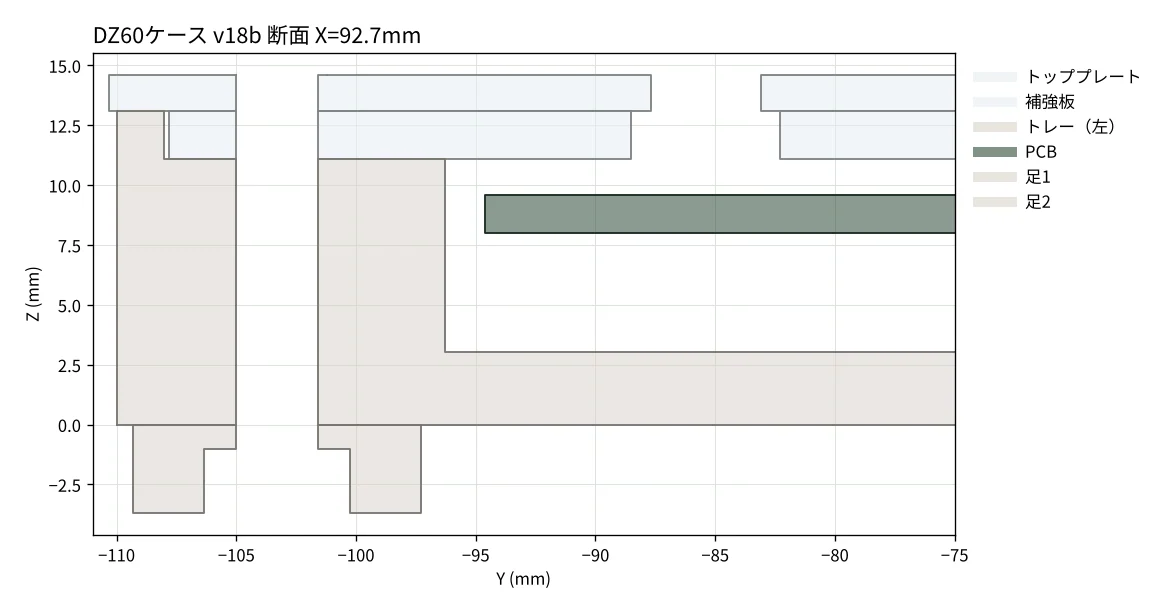
review/img/v19/cmp03a.webp
