Pinticketaro/DZ-GH-60_keyboard/review/img/v19/img07.webp

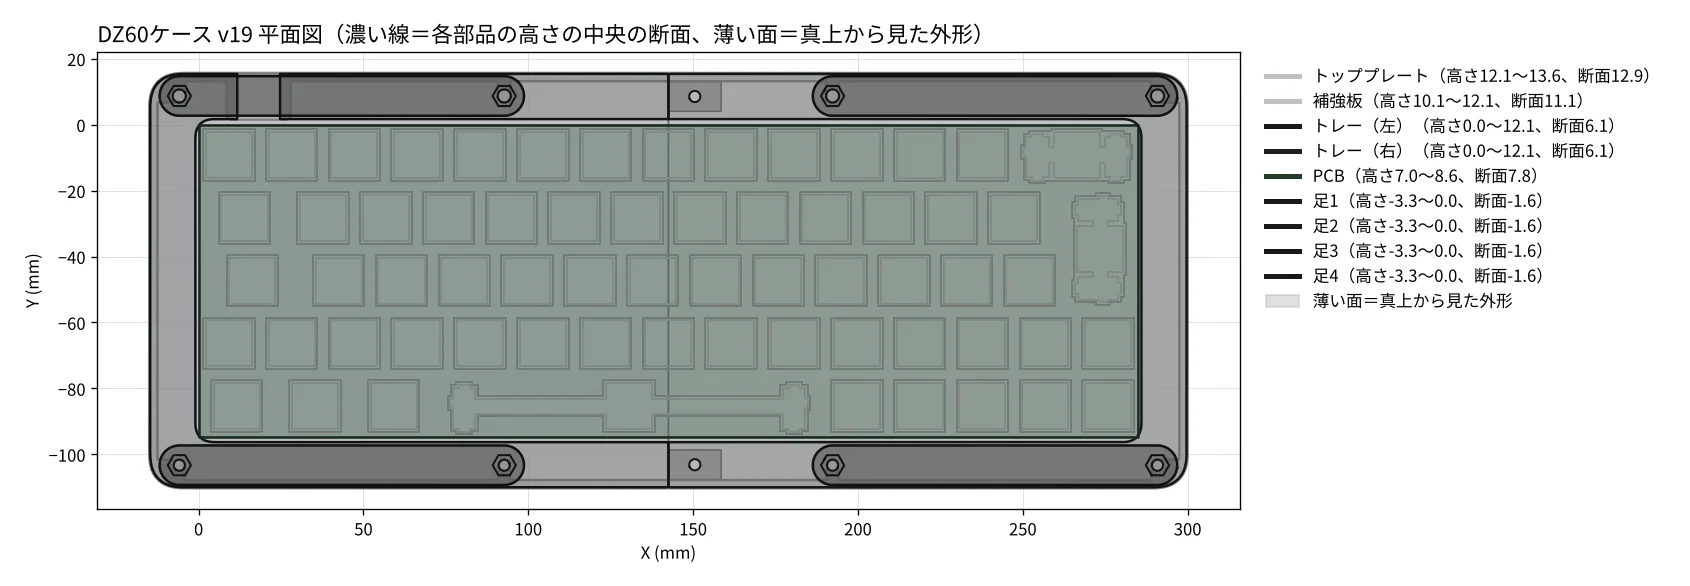
review/img/v19/img07.webp
