Pinticketaro/DZ-GH-60_keyboard/case/step/assembly_v19.step

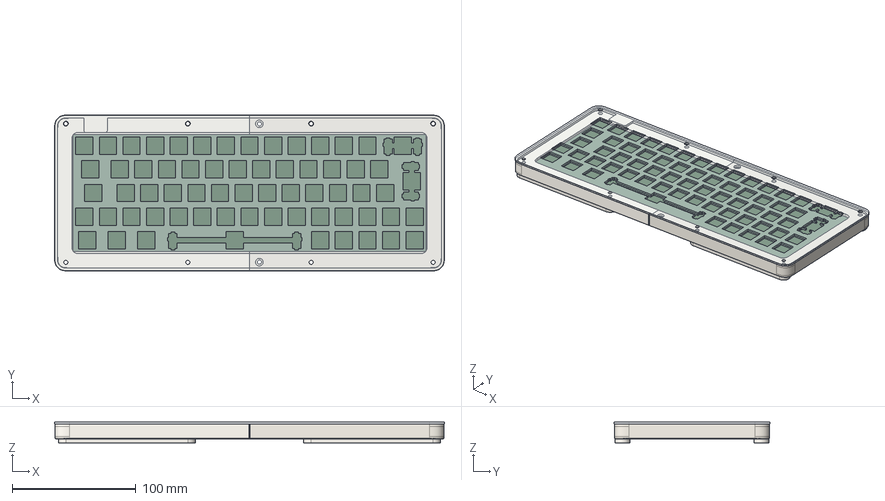
[picture p50: CAD file, 2026-11-06]
case/step/assembly_v19.step
315.0 x 126.0 x 16.9 mm
top_plate
stiffener
frame_left
frame_right
foot_1
foot_2
foot_3
foot_4
pcb_reference
