Pinticketaro/DZ-GH-60_keyboard/case/step/assembly_v18b.step

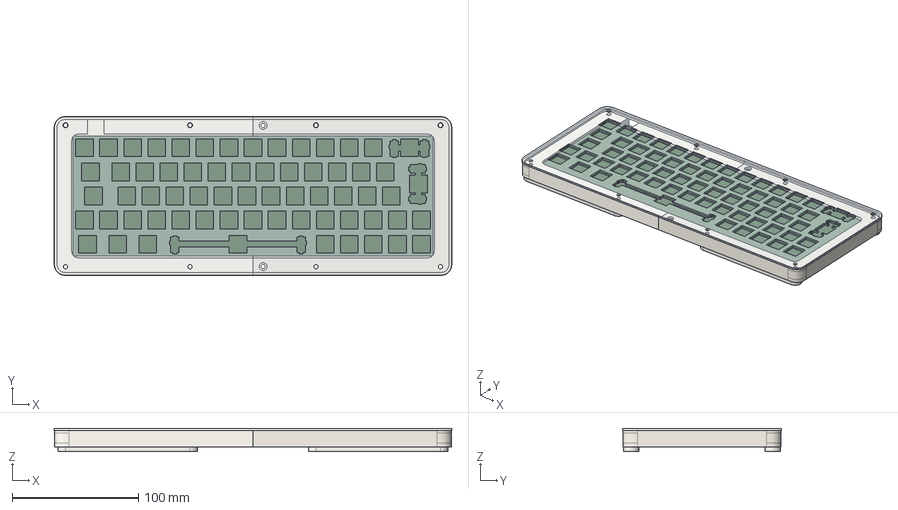
[picture p52: CAD file, 2026-10-27]
case/step/assembly_v18b.step
315.0 x 126.0 x 18.3 mm
top_plate
stiffener
frame_left
frame_right
foot_1
foot_2
foot_3
foot_4
pcb_reference
