Pinticketaro/DZ-GH-60_keyboard/case/drawings/dxf/plate_v16.dxf

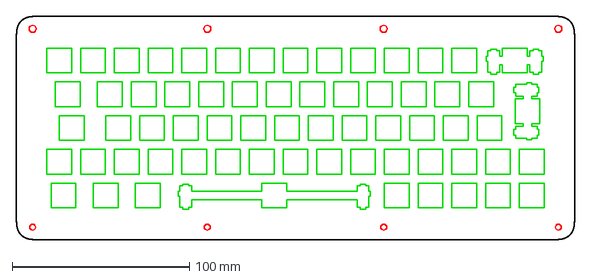
[picture p53: CAD file, 2026-10-22]
case/drawings/dxf/plate_v16.dxf
315.0 x 126.0 mm
