Pinticketaro/DZ-GH-60_keyboard/out/v19/model/stiffener.stl

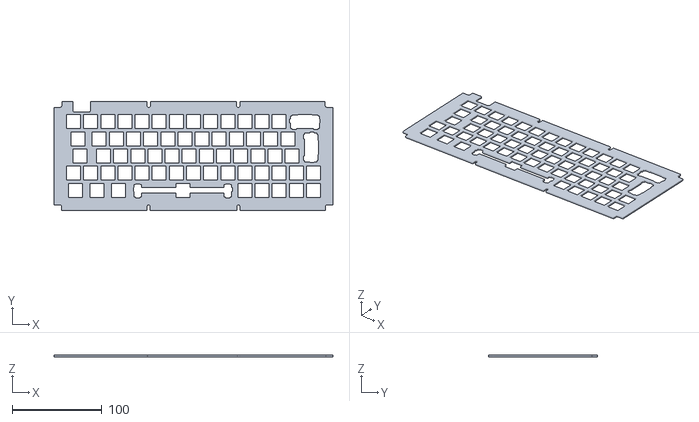
[picture p55: CAD file, 2026-10-27]
out/v19/model/stiffener.stl
310.0 x 121.0 x 2.00
