Pinticketaro/DZ-GH-60_keyboard/case/drawings/dxf/foot_v16.dxf

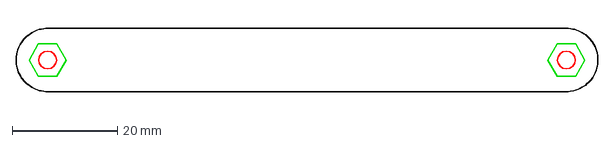
[picture p56: CAD file, 2026-10-22]
case/drawings/dxf/foot_v16.dxf
110.6 x 12.0 mm
