Pinticketaro/DZ-GH-60_keyboard/case/step/frame_right_v19.step

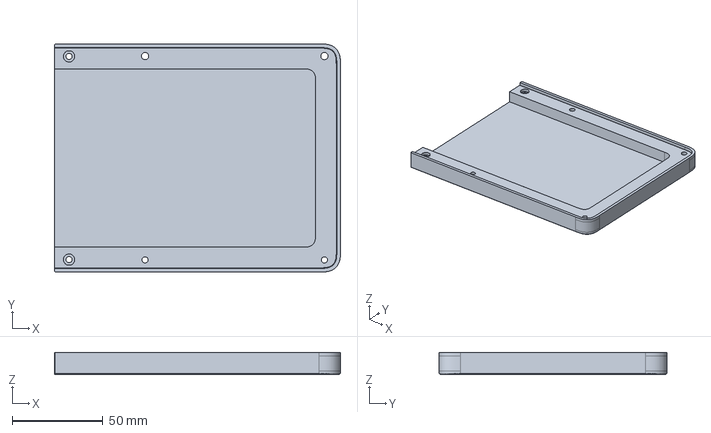
[picture p57: CAD file, 2026-11-06]
case/step/frame_right_v19.step
157.2 x 125.4 x 12.1 mm
