Pinticketaro/DZ-GH-60_keyboard/case/stl/feet_v16.stl

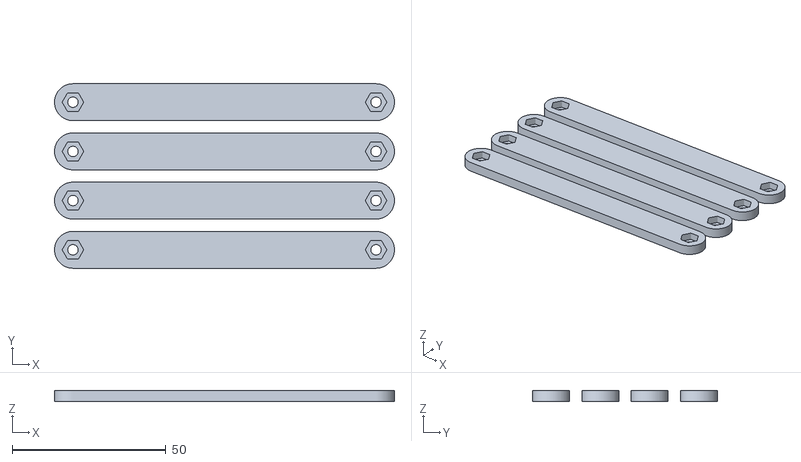
[picture p58: CAD file, 2026-10-15]
case/stl/feet_v16.stl
110.6 x 60.0 x 3.70
