Pinticketaro/DZ-GH-60_keyboard/out/v18a/model/print_support.stl

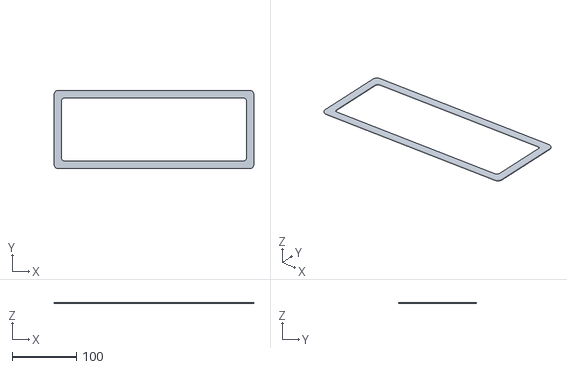
[picture p59: CAD file, 2026-10-27]
out/v18a/model/print_support.stl
310.4 x 121.4 x 2.00
