Pinticketaro/DZ-GH-60_keyboard/out/v19/model/top.stl

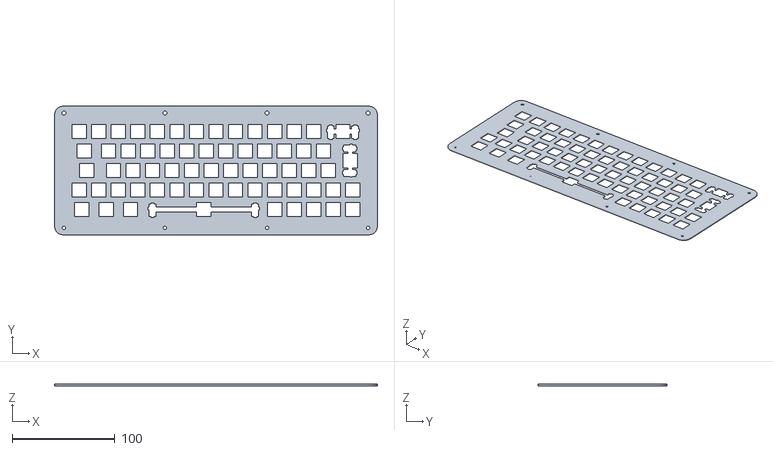
[picture p60: CAD file, 2026-10-27]
out/v19/model/top.stl
315.0 x 126.0 x 1.50
