Pinticketaro/DZ-GH-60_keyboard/case/drawings/dxf/frame_v16.dxf

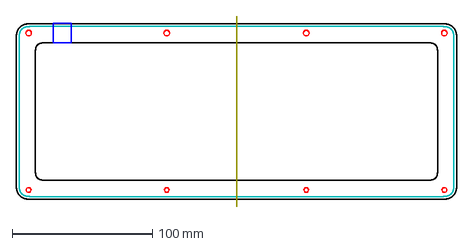
[picture p61: CAD file, 2026-10-22]
case/drawings/dxf/frame_v16.dxf
314.4 x 136.0 mm
