Pinticketaro/DZ-GH-60_keyboard/case/step/foot_v19.step

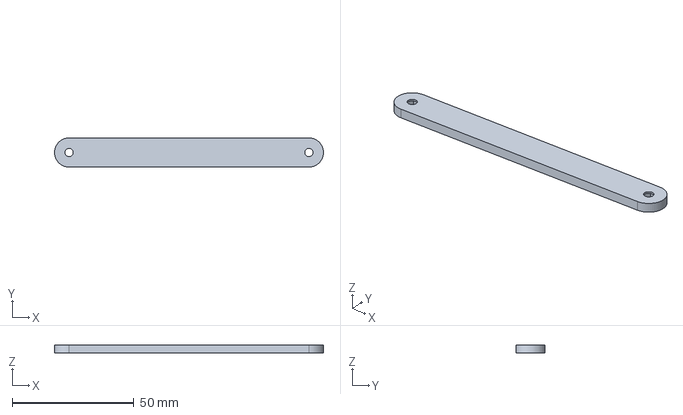
[picture p62: CAD file, 2026-11-06]
case/step/foot_v19.step
110.5 x 12.0 x 3.30 mm
