Pinticketaro/DZ-GH-60_keyboard/out/v19/model/pcb.stl

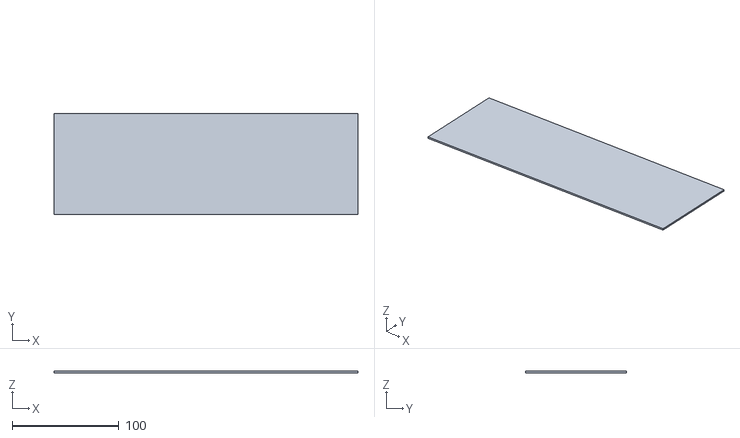
[picture p63: CAD file, 2026-10-27]
out/v19/model/pcb.stl
285.0 x 94.6 x 1.60
