Pinticketaro/DZ-GH-60_keyboard/case/stl/foot_bar_x4_v16.stl

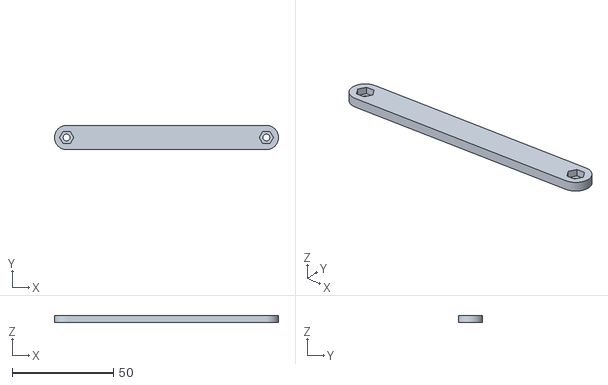
[picture p66: CAD file, 2026-10-15]
case/stl/foot_bar_x4_v16.stl
110.6 x 12.0 x 3.70
