Pinticketaro/DZ-GH-60_keyboard/out/v18a/model/print_frame_left.stl

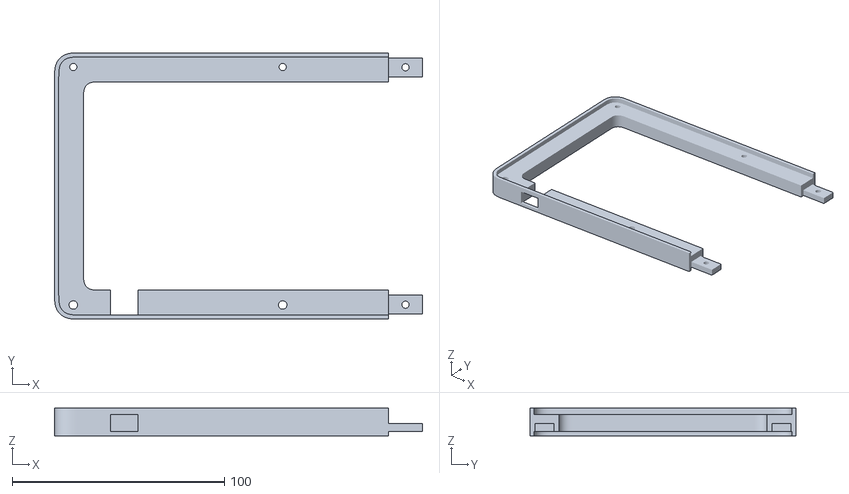
[picture p67: CAD file, 2026-10-27]
out/v18a/model/print_frame_left.stl
173.2 x 125.4 x 13.0
