Pinticketaro/DZ-GH-60_keyboard/case/drawings/dxf/bottom_v16.dxf

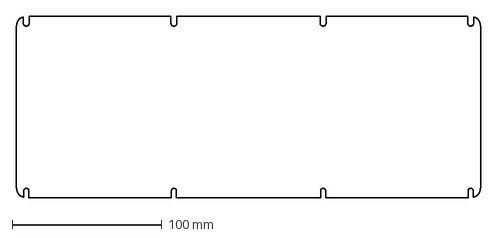
[picture p68: CAD file, 2026-10-22]
case/drawings/dxf/bottom_v16.dxf
310.0 x 121.0 mm
