Pinticketaro/DZ-GH-60_keyboard/case/drawings/dxf/stiffener_v16.dxf

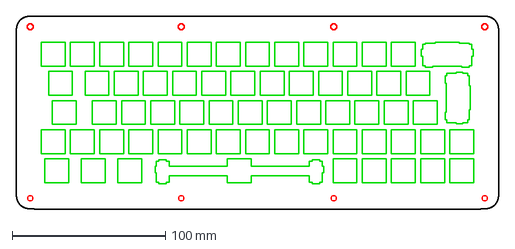
[picture p69: CAD file, 2026-10-22]
case/drawings/dxf/stiffener_v16.dxf
315.0 x 126.0 mm
