Pinticketaro/DZ-GH-60_keyboard/out/v18a/model/stiffener.stl

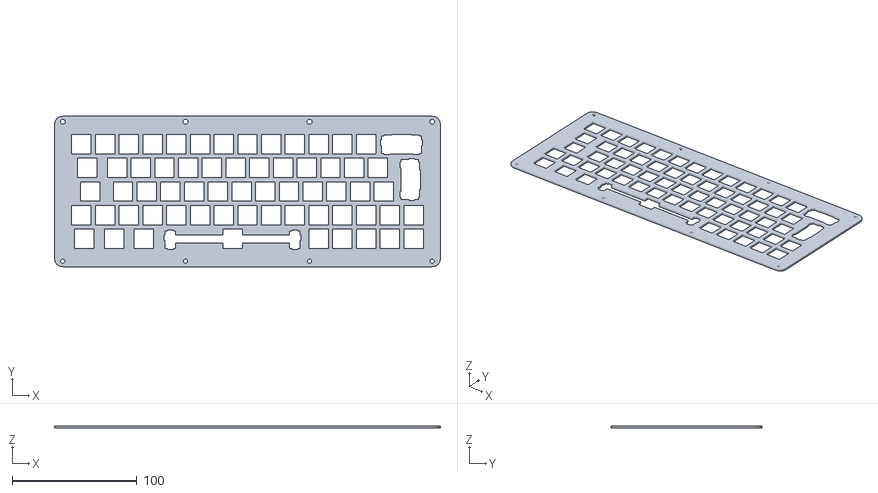
[picture p70: CAD file, 2026-10-27]
out/v18a/model/stiffener.stl
310.0 x 121.0 x 2.00
