Pinticketaro/DZ-GH-60_keyboard/case/stl/foot_rear_left_v13.stl

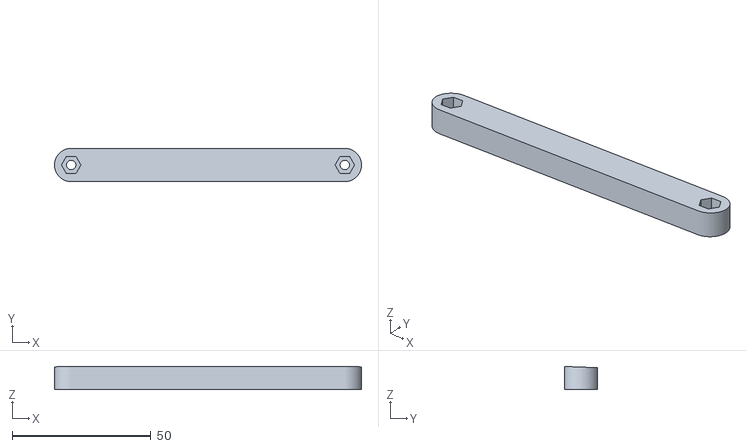
[picture p71: CAD file, 2026-10-15]
case/stl/foot_rear_left_v13.stl
110.6 x 12.0 x 8.33
