Pinticketaro/DZ-GH-60_keyboard/case/step/bottom_plate_v18a.step

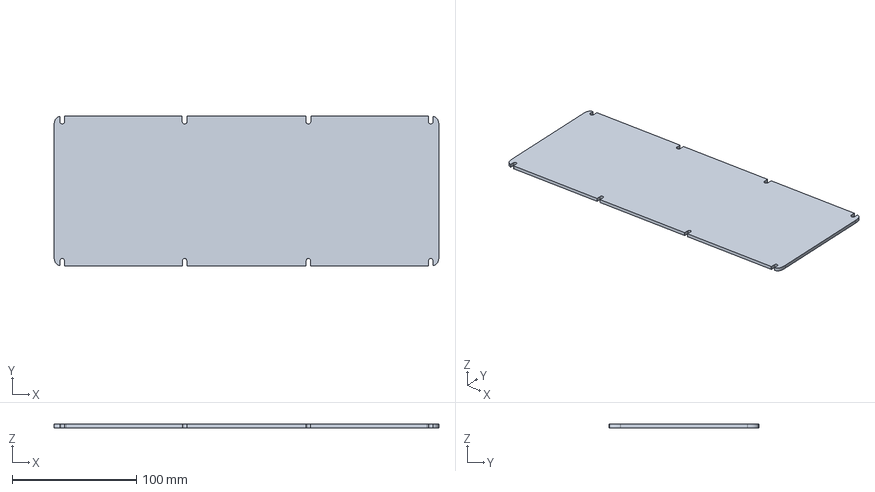
[picture p72: CAD file, 2026-10-27]
case/step/bottom_plate_v18a.step
310.0 x 121.0 x 3.00 mm
