Pinticketaro/DZ-GH-60_keyboard/case/stl/foot_front_right_v13.stl

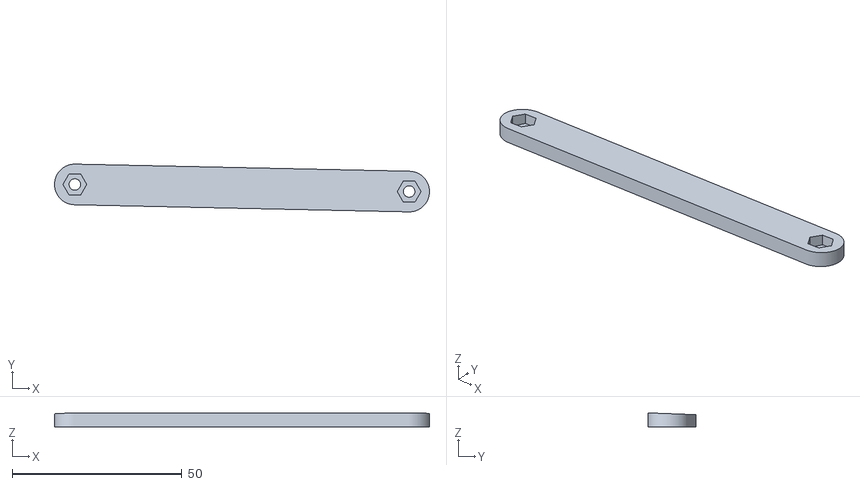
[picture p73: CAD file, 2026-10-15]
case/stl/foot_front_right_v13.stl
110.6 x 14.1 x 4.20
