Pinticketaro/DZ-GH-60_keyboard/case/stl/rod_jig_right_v12.stl

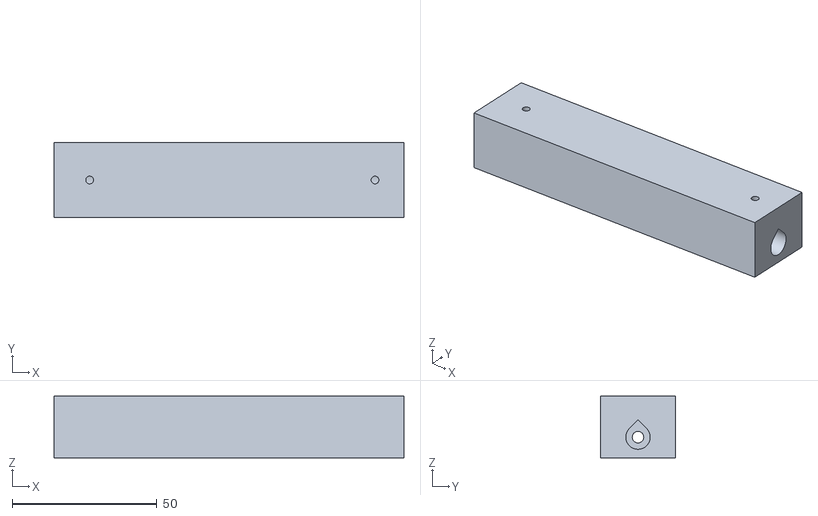
[picture p74: CAD file, 2026-10-15]
case/stl/rod_jig_right_v12.stl
120.9 x 26.0 x 21.4
