Pinticketaro/DZ-GH-60_keyboard/case/stl/brass_rod_reference_v12.stl

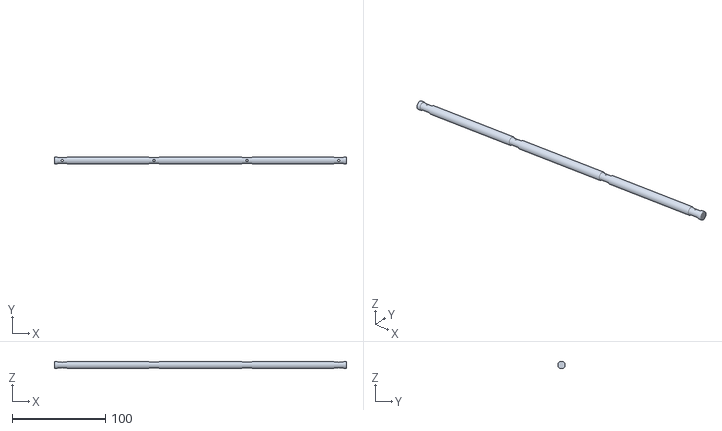
[picture p75: CAD file, 2026-10-15]
case/stl/brass_rod_reference_v12.stl
313.3 x 8.00 x 8.00
