Pinticketaro/DZ-GH-60_keyboard/case/step/frame_left_v18b.step

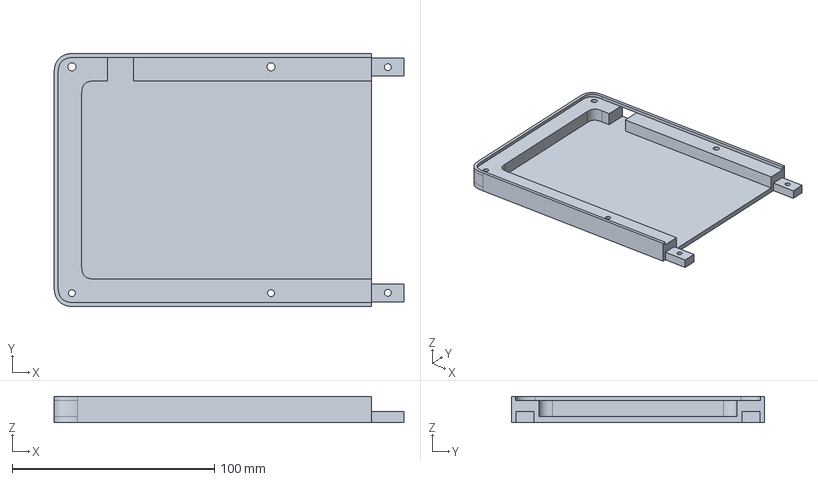
[picture p77: CAD file, 2026-10-27]
case/step/frame_left_v18b.step
173.2 x 125.4 x 13.1 mm
