Pinticketaro/DZ-GH-60_keyboard/case/stl/rod_saddle_left_v09.stl

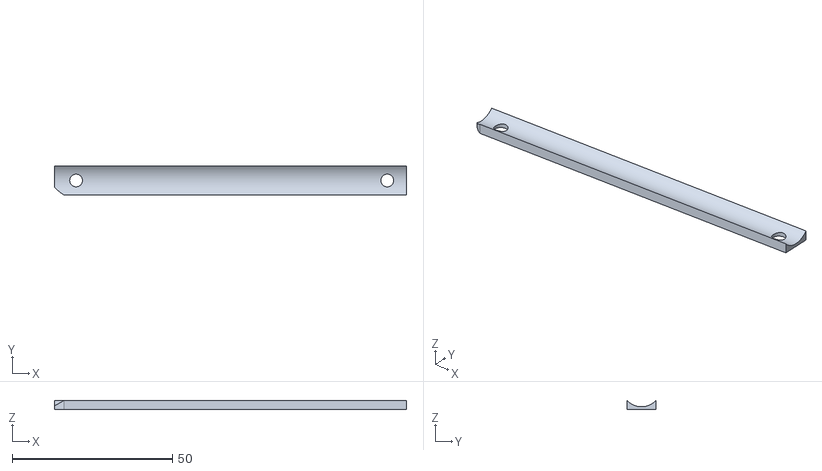
[picture p78: CAD file, 2026-10-14]
case/stl/rod_saddle_left_v09.stl
110.0 x 9.00 x 2.89
