Pinticketaro/DZ-GH-60_keyboard/case/stl/foot_1_v08.stl

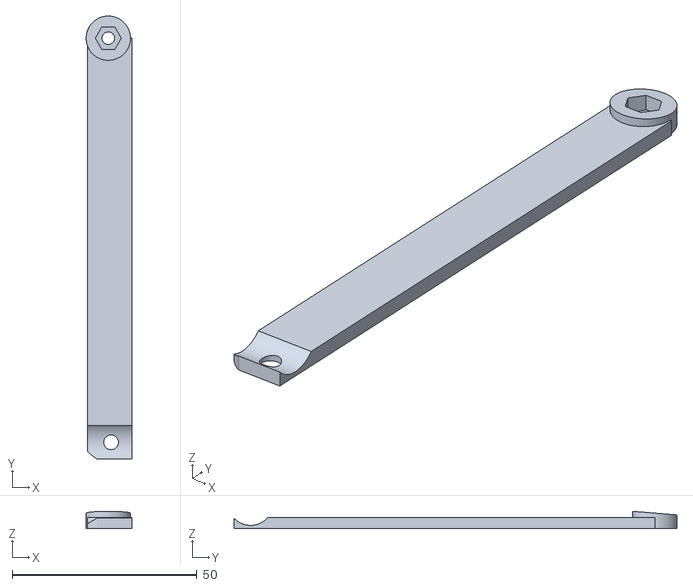
[picture p79: CAD file, 2026-10-14]
case/stl/foot_1_v08.stl
12.4 x 119.8 x 4.70
