Pinticketaro/DZ-GH-60_keyboard/case/stl/foot_3_v08.stl

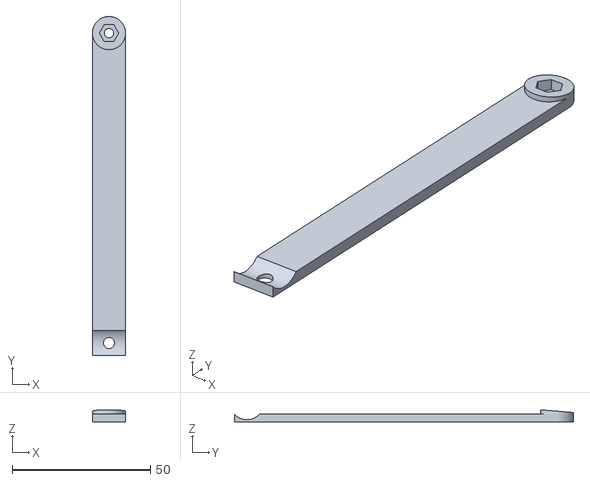
[picture p80: CAD file, 2026-10-14]
case/stl/foot_3_v08.stl
12.0 x 122.5 x 4.48
