Pinticketaro/DZ-GH-60_keyboard/(list of files, cad)

Other CAD files:
out/v18a/model/support.stl
out/v19/model/frame_right.stl
case/step/top_plate_v19.step
out/v18a/model/frame_left.stl
out/v19/model/foot_2.stl
case/step/pcb_reference_v19.step
out/v19/model/foot_3.stl
case/step/stiffener_v19.step
out/v18a/model/frame_right.stl
out/v19/model/foot_1.stl
case/step/stiffener_v18a.step
out/v18a/model/top.stl
out/v19/model/foot_4.stl
case/step/top_plate_v18a.step
case/stl/foot_rear_right_v13.stl
out/v18a/model/foot_1.stl
out/v19/model/frame_left.stl
out/v18a/model/bottom.stl
case/step/frame_right_v18a.step
out/v18a/model/pcb.stl
case/step/foot_v18a.step
case/stl/foot_front_left_v13.stl
out/v18a/model/foot_4.stl
out/v18a/model/foot_3.stl
case/step/pcb_reference_v18a.step
out/v18a/model/foot_2.stl
case/step/frame_left_v18a.step
case/stl/rod_jig_left_v12.stl
case/step/foot_v18b.step
case/step/stiffener_v18b.step
case/step/pcb_reference_v18b.step
case/step/top_plate_v18b.step
case/step/bottom_plate_v17.step
case/stl/rod_saddle_right_v09.stl
case/stl/foot_4_v08.stl
case/stl/foot_2_v08.stl
case/drawings/dxf/bottom_v14.dxf
case/drawings/dxf/bottom_v15.dxf
case/drawings/dxf/feet_layout_v14.dxf
case/drawings/dxf/feet_layout_v15.dxf
case/drawings/dxf/foot_v14.dxf
case/drawings/dxf/foot_v15.dxf
case/drawings/dxf/frame_v14.dxf
case/drawings/dxf/frame_v15.dxf
case/drawings/dxf/plate_v14.dxf
case/drawings/dxf/plate_v15.dxf
case/drawings/dxf/stiffener_v14.dxf
case/drawings/dxf/stiffener_v15.dxf
case/step/assembly_v15.step
case/step/assembly_v16.step
case/step/assembly_v17.step
case/step/bottom_plate_v15.step
case/step/bottom_plate_v16.step
case/step/foot_v15.step
case/step/foot_v16.step
case/step/foot_v17.step
case/step/frame_left_v15.step
case/step/frame_left_v16.step
case/step/frame_left_v17.step
case/step/frame_right_v15.step
case/step/frame_right_v16.step
case/step/frame_right_v17.step
case/step/pcb_reference_v15.step
case/step/pcb_reference_v16.step
case/step/pcb_reference_v17.step
case/step/stiffener_v15.step
case/step/stiffener_v16.step
case/step/stiffener_v17.step
case/step/top_plate_v15.step
case/step/top_plate_v16.step
case/step/top_plate_v17.step
case/stl/assembly_v05.stl
case/stl/assembly_v06.stl
case/stl/assembly_v07.stl
case/stl/assembly_v08.stl
case/stl/assembly_v09.stl
case/stl/assembly_v10.stl
case/stl/assembly_v11.stl
case/stl/assembly_v12.stl
case/stl/assembly_v13.stl
case/stl/assembly_v14.stl
case/stl/assembly_v15.stl
case/stl/assembly_v16.stl
case/stl/brass_rod_reference_v06.stl
case/stl/brass_rod_reference_v08.stl
case/stl/brass_rod_reference_v09.stl
case/stl/brass_rod_reference_v10.stl
case/stl/brass_rod_reference_v11.stl
case/stl/feet_v05.stl
case/stl/feet_v06.stl
case/stl/feet_v07.stl
case/stl/feet_v08.stl
case/stl/feet_v09.stl
case/stl/feet_v10.stl
case/stl/feet_v11.stl
case/stl/feet_v12.stl
case/stl/feet_v13.stl
case/stl/foot_front_left_v09.stl
case/stl/foot_front_left_v10.stl
case/stl/foot_front_left_v11.stl
case/stl/foot_front_right_v09.stl
case/stl/foot_front_right_v10.stl
case/stl/foot_front_right_v11.stl
case/stl/frame_left_v05.stl
case/stl/frame_left_v06.stl
case/stl/frame_left_v08.stl
case/stl/frame_left_v11.stl
case/stl/frame_left_v13.stl
case/stl/frame_left_v14.stl
case/stl/frame_left_v15.stl
case/stl/frame_left_v16.stl
case/stl/frame_right_v05.stl
case/stl/frame_right_v06.stl
case/stl/frame_right_v08.stl
case/stl/frame_right_v11.stl
case/stl/frame_right_v13.stl
case/stl/frame_right_v14.stl
case/stl/frame_right_v15.stl
case/stl/frame_right_v16.stl
case/stl/rod_jig_left_v11.stl
case/stl/rod_jig_right_v08.stl
case/stl/rod_jig_right_v11.stl
case/stl/rod_saddle_left_v07.stl
case/stl/rod_saddle_right_v07.stl
