Pinticketaro/DZ-GH-60_keyboard/case/rod_drawing_v12.pdf

8.29±0.1

106.84±0.1

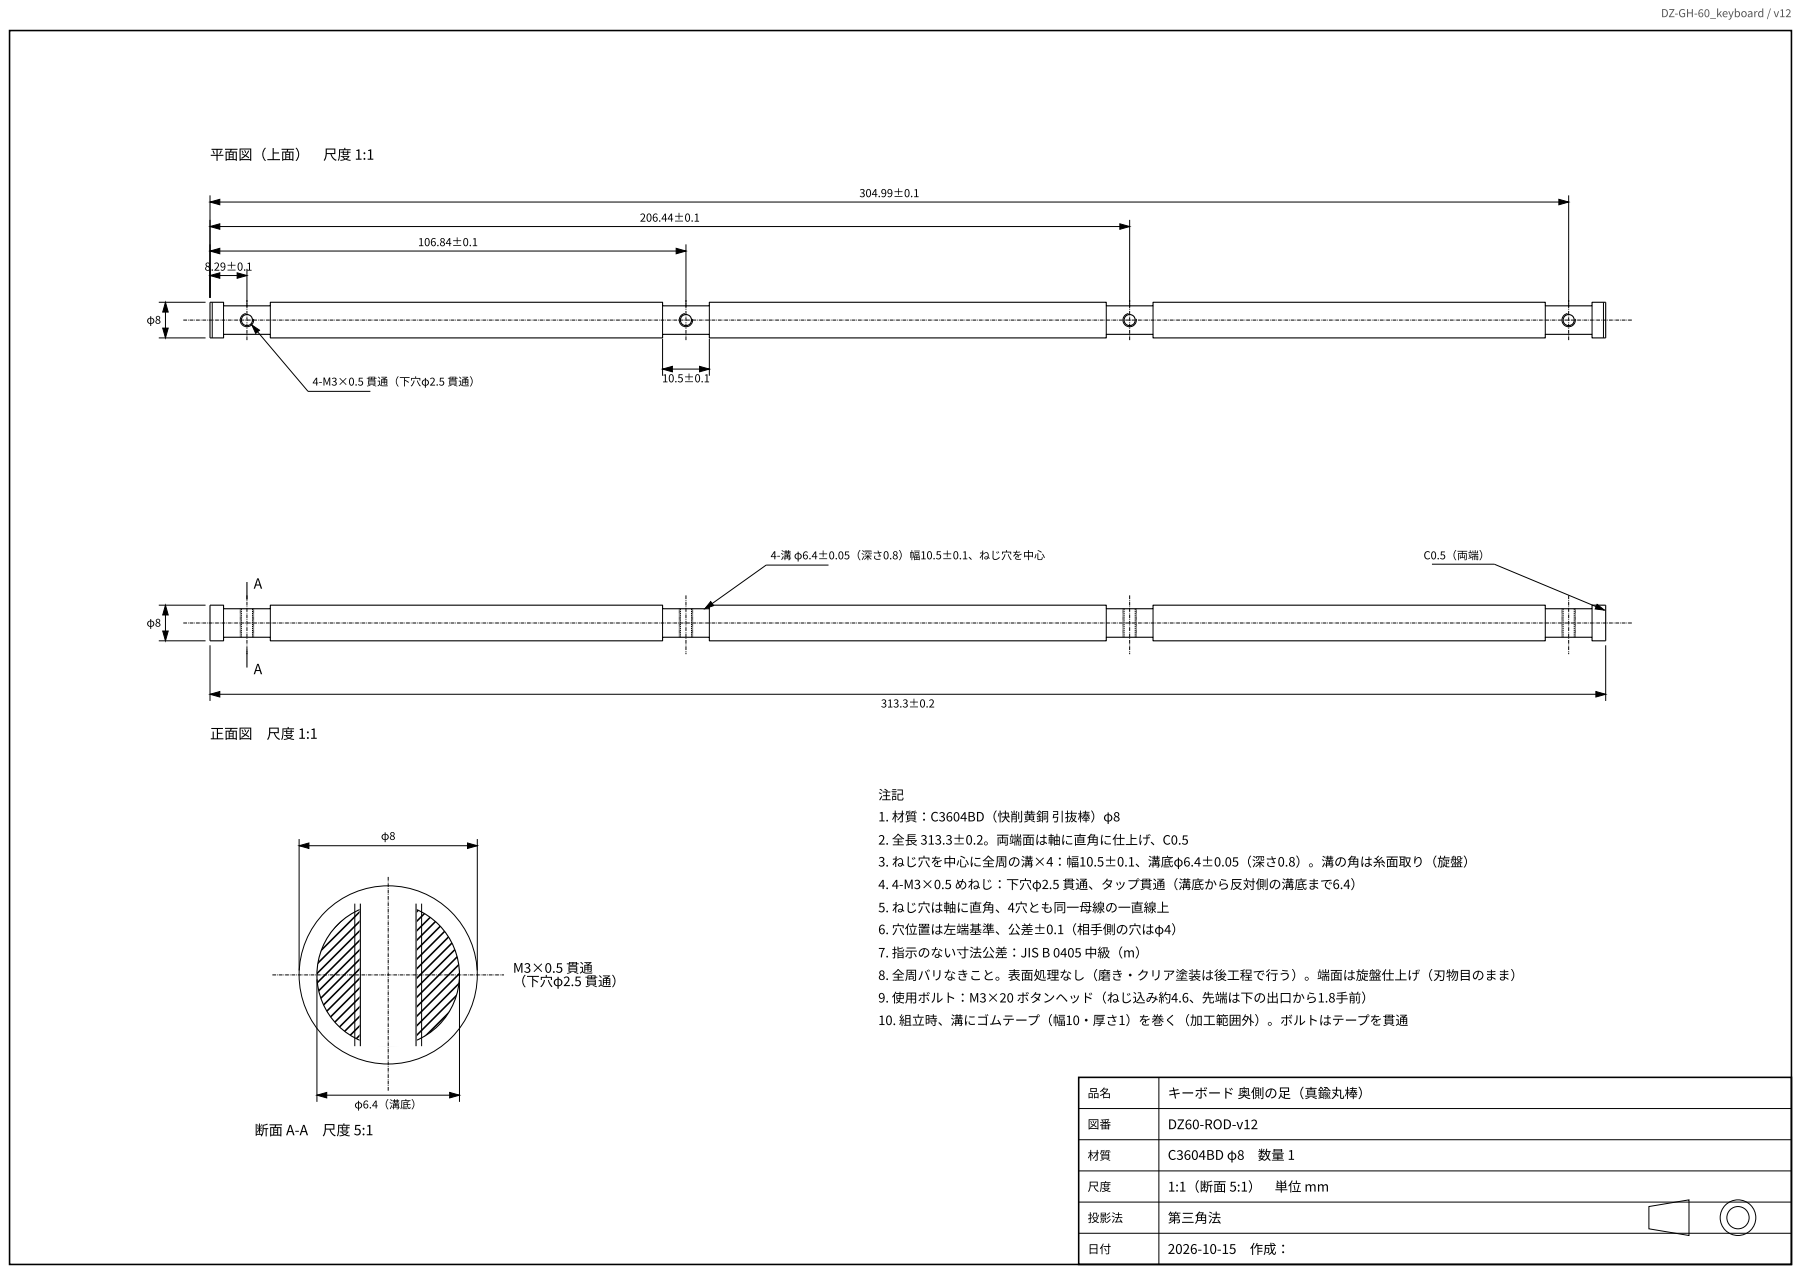
[picture p81: page 1]
4-M3×0.5 貫通（下穴φ2.5 貫通）; 4-溝 φ6.4±0.05（深さ0.8）幅10.5±0.1、ねじ穴を中心; 正面図 尺度 1:1; M3×0.5 貫通 （下穴φ2.5 貫通）; 9. 使用ボルト：M3×20 ボタンヘッド（ねじ込み約4.6、先端は下の出口から1.8手前）; キーボード 奥側の足（真鍮丸棒）; DZ60-ROD-v12; 投影法; 第三角法; DZ-GH-60_keyboard / v12

平面図（上面）　尺度 1:1

1. 材質：C3604BD（快削黄銅 引抜棒）φ8
2. 全長 313.3±0.2。両端面は軸に直角に仕上げ、C0.5

3. ねじ穴を中心に全周の溝×4：幅10.5±0.1、溝底φ6.4±0.05（深さ0.8）。溝の角は糸面取り（旋盤）

4. 4-M3×0.5 めねじ：下穴φ2.5 貫通、タップ貫通（溝底から反対側の溝底まで6.4）

5. ねじ穴は軸に直角、4穴とも同一母線の一直線上
6. 穴位置は左端基準、公差±0.1（相手側の穴はφ4）
7. 指示のない寸法公差：JIS B 0405 中級（m）

8. 全周バリなきこと。表面処理なし（磨き・クリア塗装は後工程で行う）。端面は旋盤仕上げ（刃物目のまま）

10. 組立時、溝にゴムテープ（幅10・厚さ1）を巻く（加工範囲外）。ボルトはテープを貫通
