Pinticketaro/DZ-GH-60_keyboard/case/rod_drawing_v10.pdf

8.21±0.1

105.46±0.1

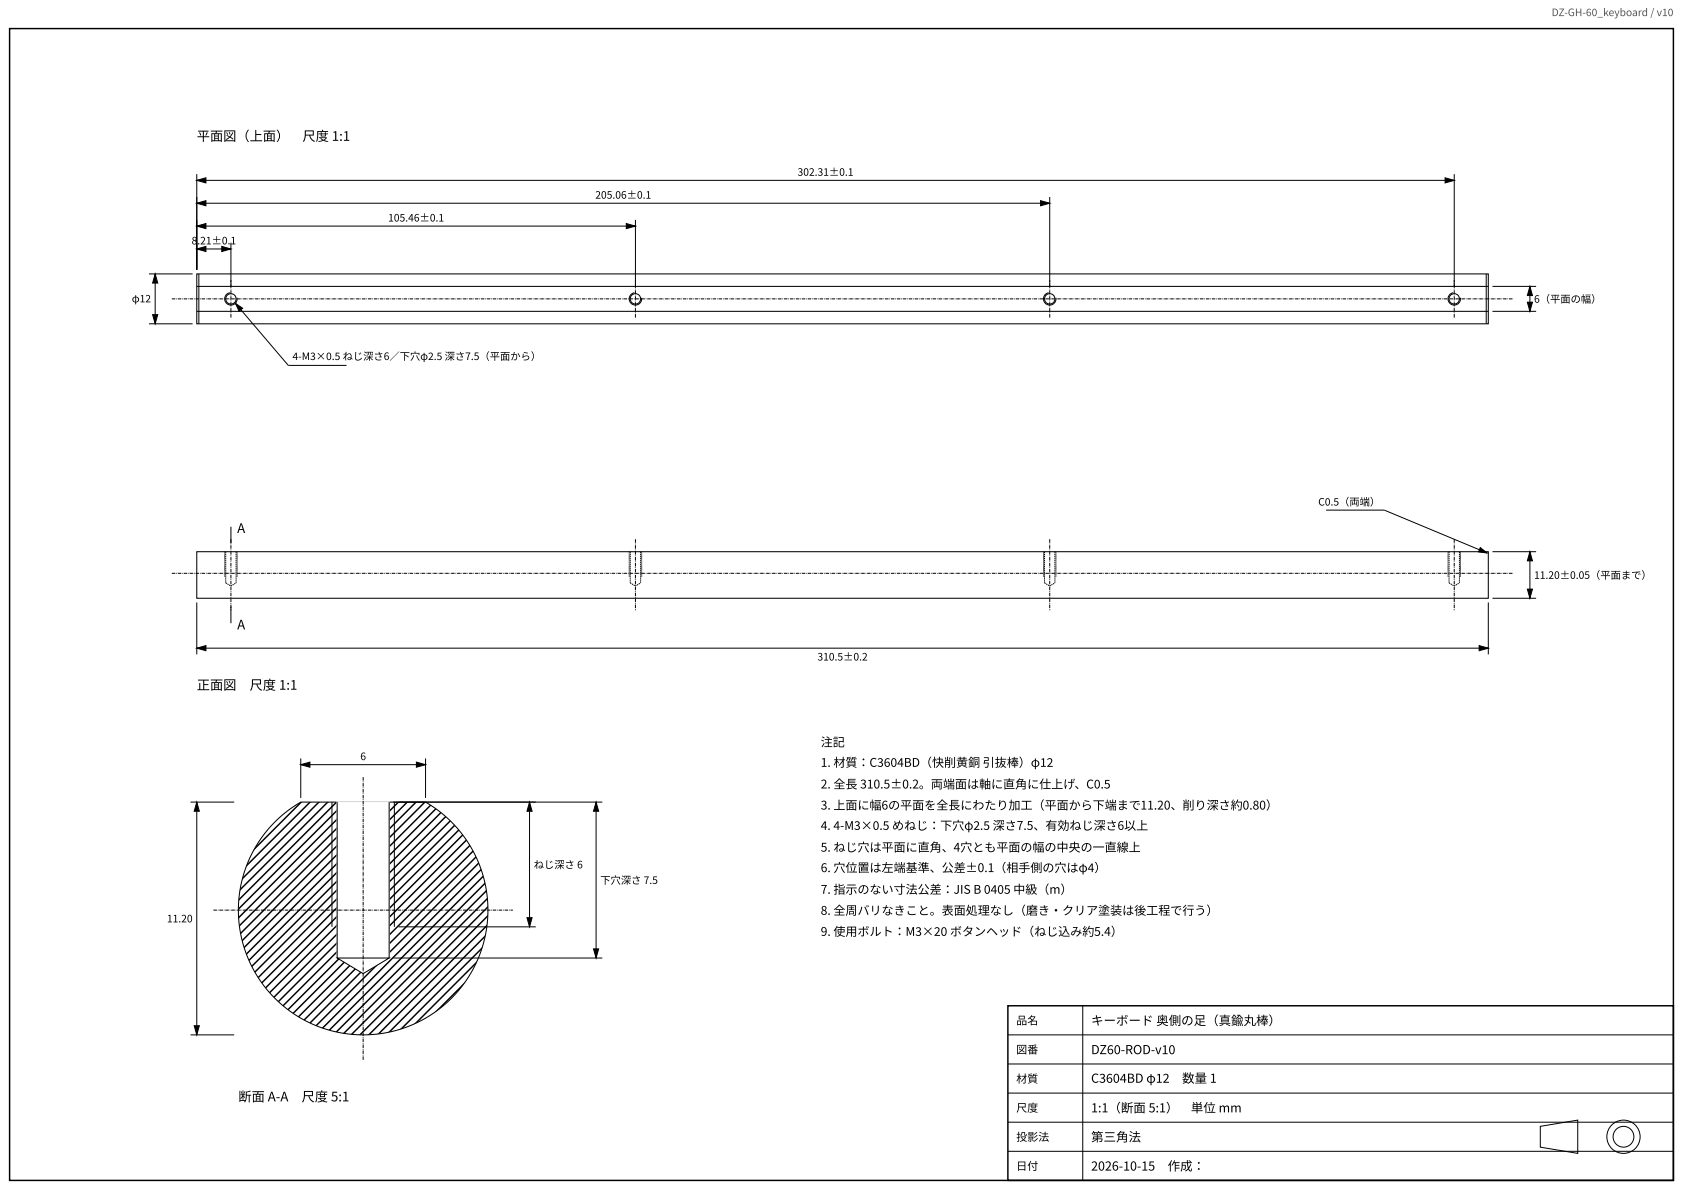
[picture p90: page 1]
6（平面の幅）; 4-M3×0.5 ねじ深さ6／下穴φ2.5 深さ7.5（平面から）; 11.20±0.05（平面まで）; 正面図 尺度 1:1; ねじ深さ 6; 下穴深さ 7.5; 3. 上面に幅6の平面を全長にわたり加工（平面から下端まで11.20、削り深さ約0.80）; 4. 4-M3×0.5 めねじ：下穴φ2.5 深さ7.5、有効ねじ深さ6以上; 5. ねじ穴は平面に直角、4穴とも平面の幅の中央の一直線上; 6. 穴位置は左端基準、公差±0.1（相手側の穴はφ4）; 9. 使用ボルト：M3×20 ボタンヘッド（ねじ込み約5.4）; キーボード 奥側の足（真鍮丸棒）; DZ60-ROD-v10; 投影法; 第三角法; DZ-GH-60_keyboard / v10

平面図（上面）　尺度 1:1

1. 材質：C3604BD（快削黄銅 引抜棒）φ12
2. 全長 310.5±0.2。両端面は軸に直角に仕上げ、C0.5

7. 指示のない寸法公差：JIS B 0405 中級（m）

8. 全周バリなきこと。表面処理なし（磨き・クリア塗装は後工程で行う）
