Pinticketaro/DZ-GH-60_keyboard/case/drawings/DZ60_drawings_v15.pdf

品名 | キーボードケース 組立図（積層断面・部品表）
図番 | DZ60-ASSY-v15
材質 | —
尺度 | 断面 4:1　単位 mm
投影法 | 第三角法
日付 | 2026-10-15　1/7枚

DZ-GH-60_keyboard / v15

断面 A-A（X=107.7のネジの列で切り、左から見る。手前が左）　尺度 4:1

### 部品表

No | 部品 | 材料・厚さ | 数 | 図

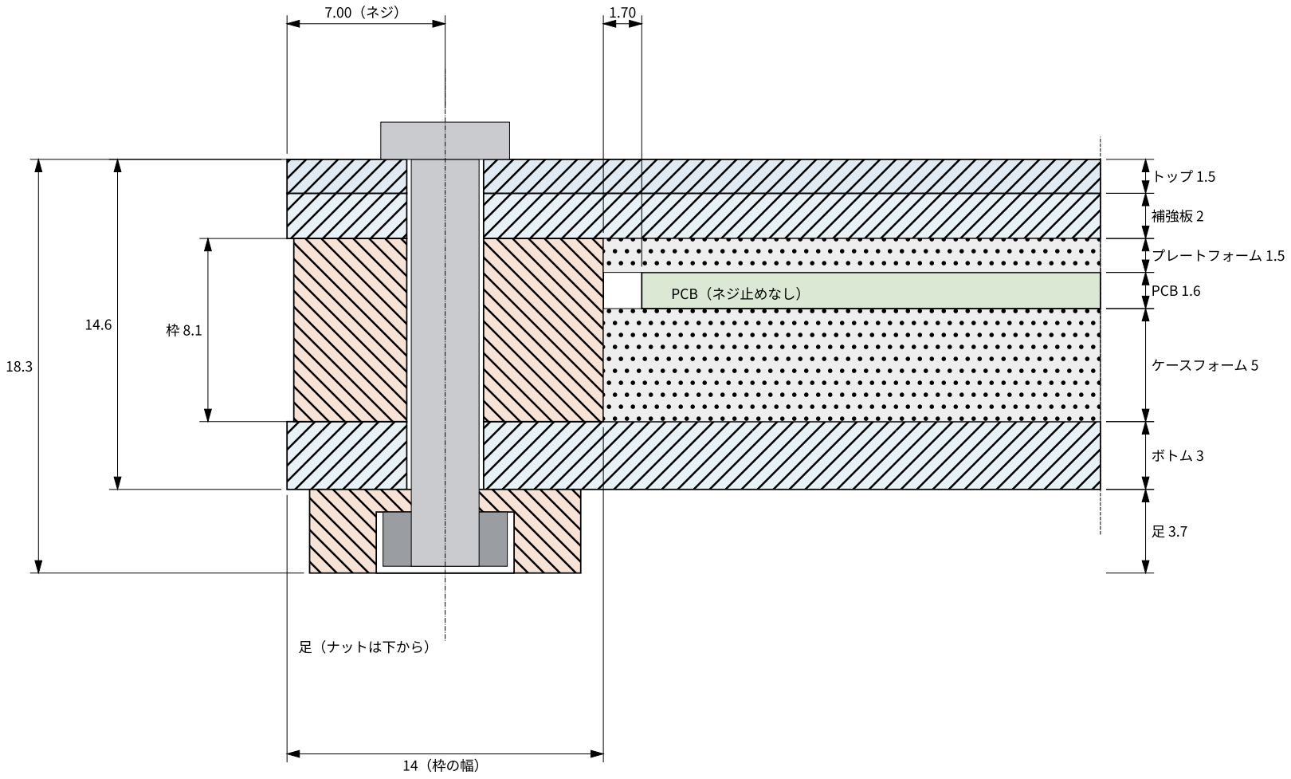
[picture p91: figure]
ボトム 3; ケースフォーム 5; PCB 1.6; プレートフォーム 1.5; 補強板 2; トップ 1.5; 14（枠の幅）; 足（ナットは下から）; PCB（ネジ止めなし）

1 | トッププレート | アクリル 1.5（キャスト） | 1 | 2・3・4枚目
2 | 補強板 | アクリル 2 | 1 | 2・5枚目
3 | 枠（左右2分割） | PLA 高さ8.1 | 2 | 6枚目
4 | ボトムプレート | アクリル 3 | 1 | 2枚目
5 | 足（同じ形） | PLA 高さ3.7 | 4 | 7枚目
6 | ボルト | M3×18 ボタンヘッド | 8 | —
7 | ナット | M3（二面幅5.5・厚さ2.4） | 8 | —
8 | 継ぎ目のボルト・ナット | M3×6 ボタンヘッド＋M3ナット | 各2 | 6枚目
9 | ケースフォーム | 厚さ5.5〜6 | 1 | 型紙SVG
10 | プレートフォーム | 厚さ1.5 | 1 | 型紙SVG

注記

1. 座標：外形の左下を原点、X＝右、Y＝奥、Z＝上（ボトムプレートの下面＝0）。全ページ共通
2. Fusionでは XY平面にスケッチし、原点を外形の左下に合わせる。DXF（case/drawings/dxf）も同じ座標
3. 外形の角はR8・曲率連続（Apple風）。2枚目の点列をフィット点スプラインで通すか、DXFの外形を使う
4. ボルトは上から全層を通し、足の六角溝のナットで締める（8本とも同じ）
5. PCBはネジ止めしない。スイッチの爪でトッププレートに吊られ、下のケースフォームで支える
6. 指示のない寸法の許容差：±0.2（レーザー・3Dプリントの精度に合わせる）
7. 枠は外形より全周0.3内側（印刷の誤差で枠がはみ出さず、層の間に細い影の線が出る）

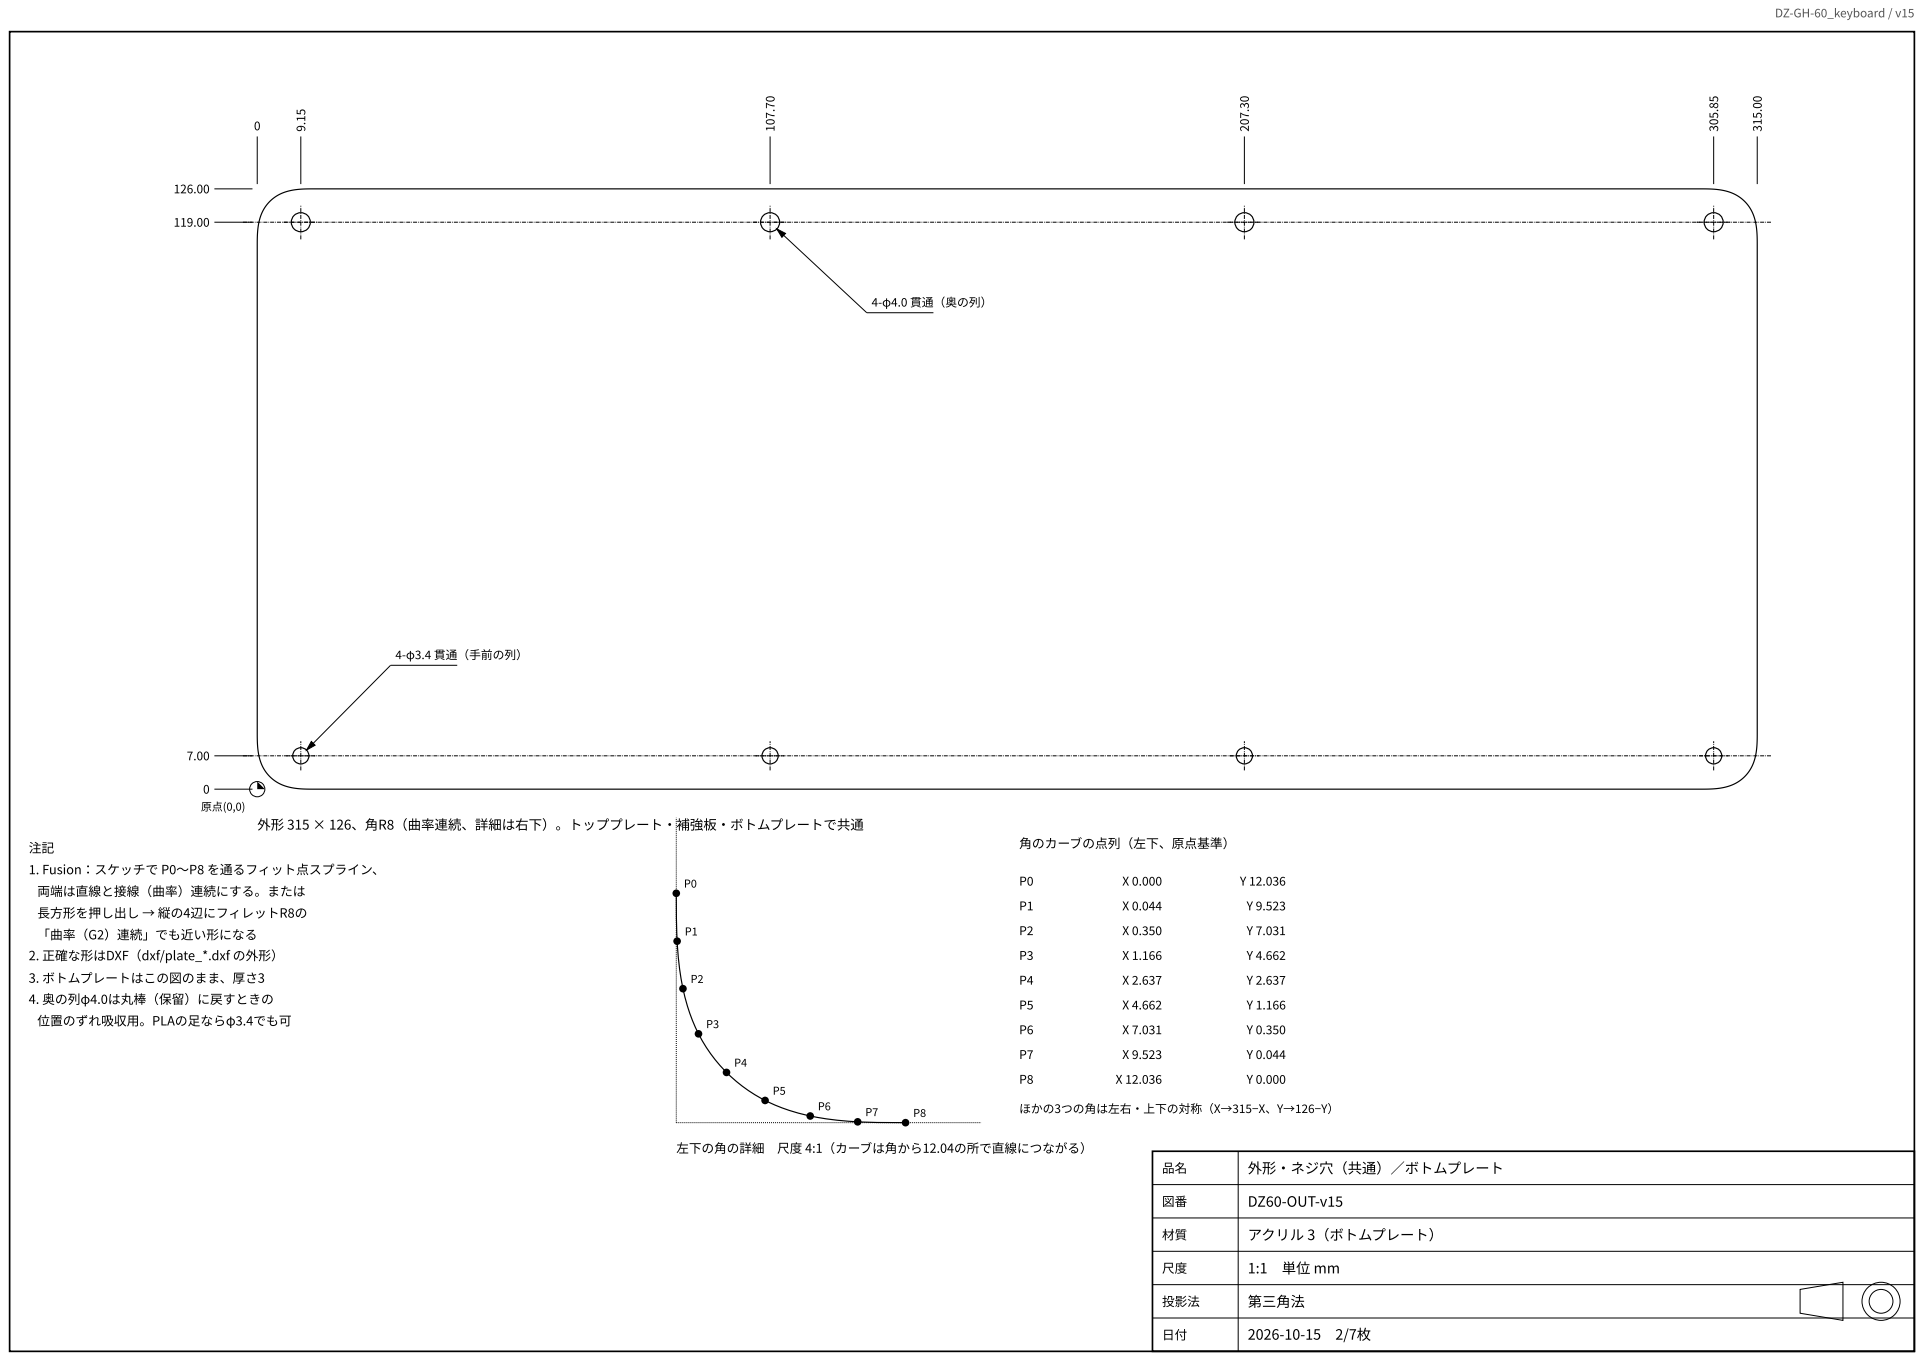
[picture p92: page 2]

外形 315 × 126、角R8（曲率連続、詳細は右下）。トッププレート・補強板・ボトムプレートで共通

1. Fusion：スケッチで P0〜P8 を通るフィット点スプライン、
両端は直線と接線（曲率）連続にする。または

長方形を押し出し → 縦の4辺にフィレットR8の
「曲率（G2）連続」でも近い形になる
2. 正確な形はDXF（dxf/plate_*.dxf の外形）

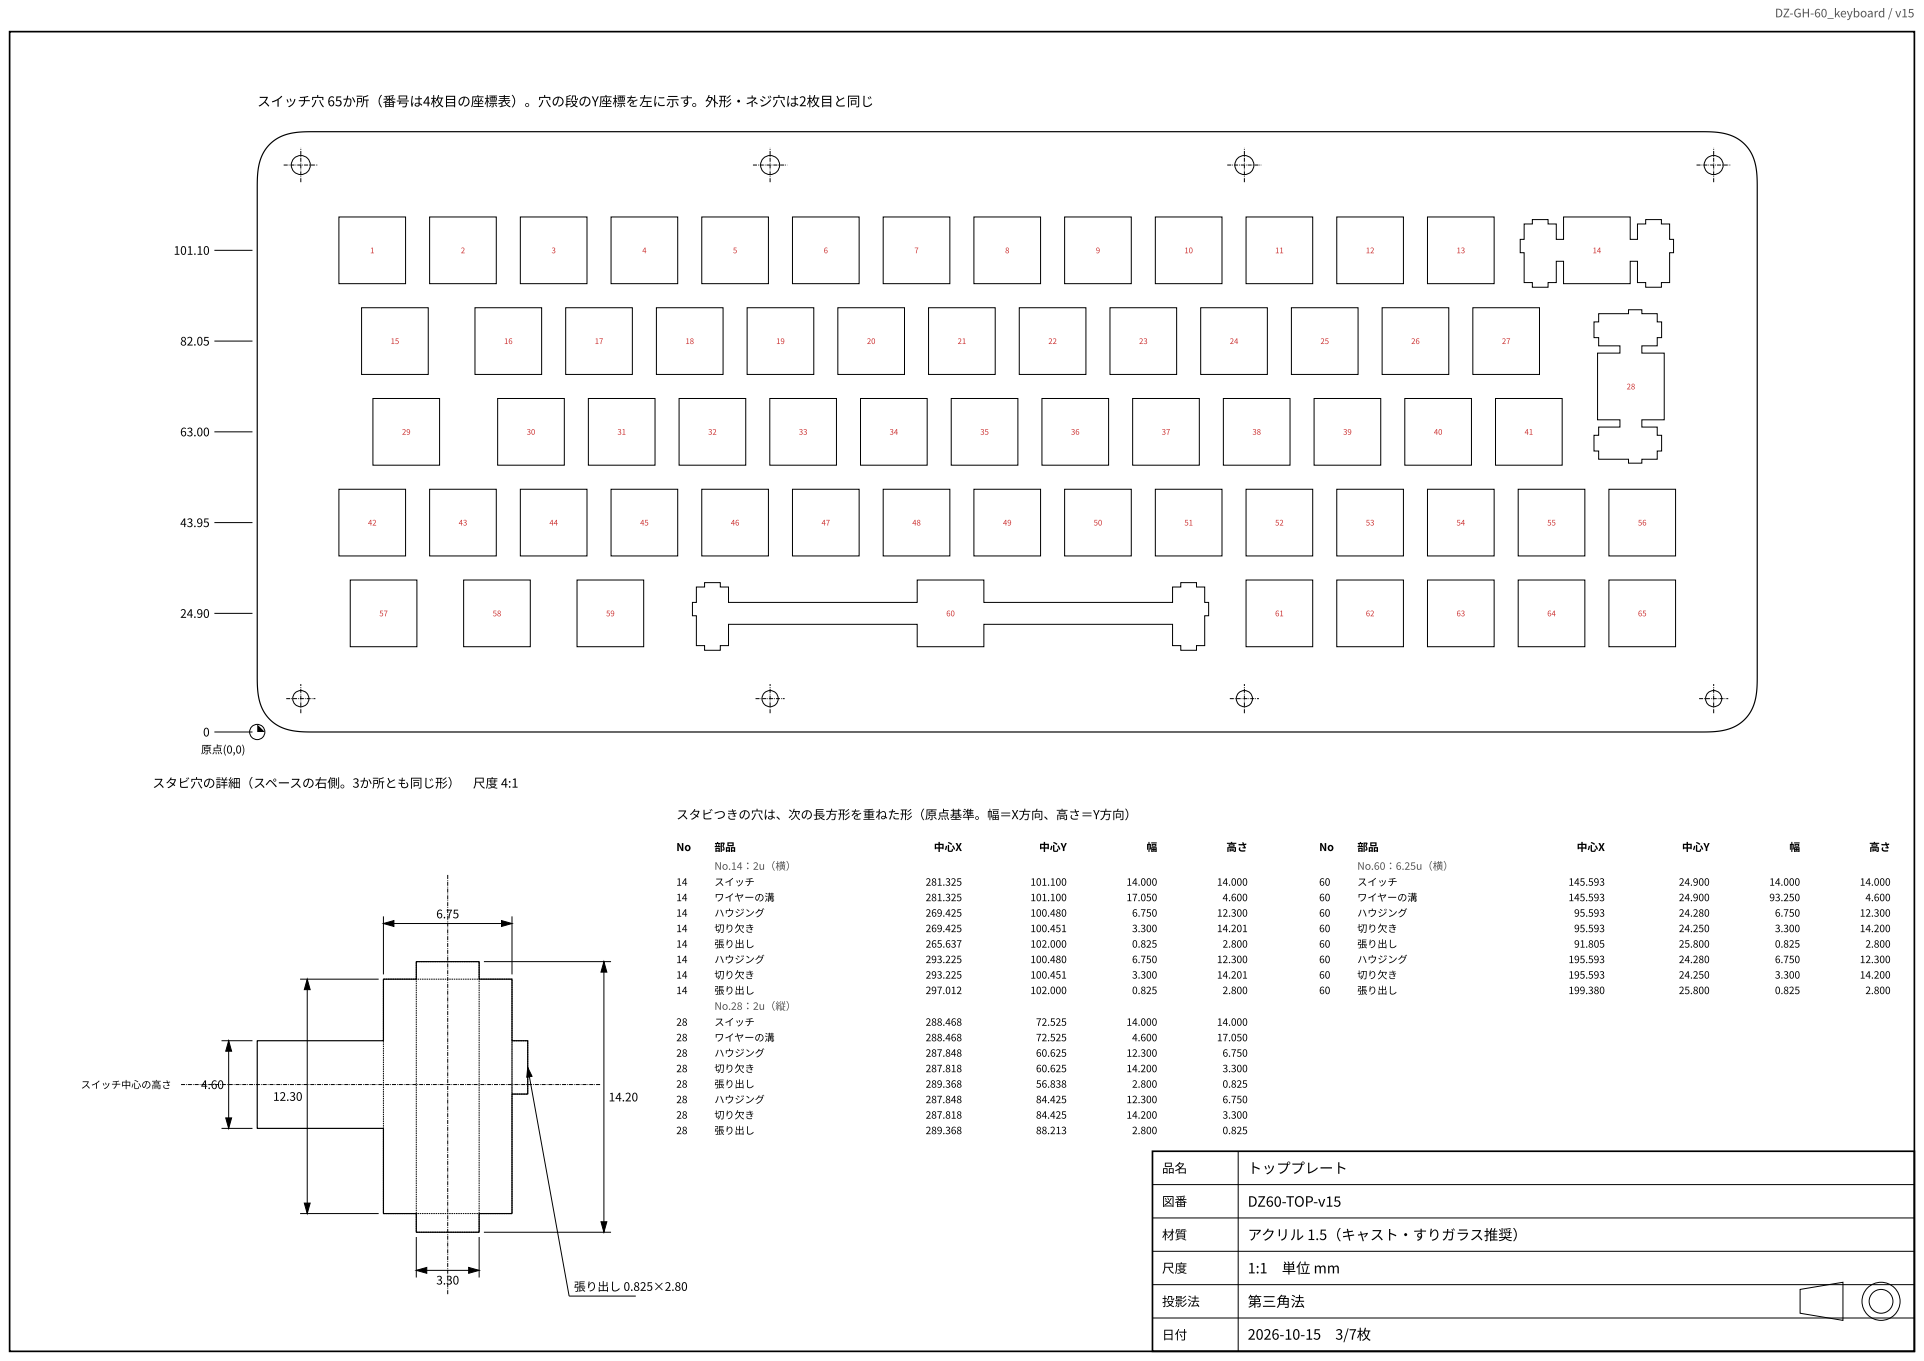
[picture p93: page 3]
トッププレート; DZ60-TOP-v15; アクリル 1.5（キャスト・すりガラス推奨）; スイッチ中心の高さ; 張り出し 0.825×2.80; 中心X; 中心Y; スイッチ; ワイヤーの溝; ハウジング; 切り欠き; 張り出し

スイッチ穴 65か所（番号は4枚目の座標表）。穴の段のY座標を左に示す。外形・ネジ穴は2枚目と同じ

スタビ穴の詳細（スペースの右側。3か所とも同じ形）　尺度 4:1

スタビつきの穴は、次の長方形を重ねた形（原点基準。幅＝X方向、高さ＝Y方向）

品名 | スイッチ穴の中心座標表
図番 | DZ60-TBL-v15
材質 | —
尺度 | —　単位 mm
日付 | 2026-10-15　4/7枚

スイッチ穴の中心（14.0角の中心）。原点＝外形の左下。1uの穴はすべて 14.0 × 14.0 の正方形（カーフ補正前）
No 種類 | X | Y
1 | 1u | 24.15 | 101.10
2 | 1u | 43.20 | 101.10
3 | 1u | 62.25 | 101.10
4 | 1u | 81.30 | 101.10
5 | 1u | 100.35 | 101.10
6 | 1u | 119.40 | 101.10
7 | 1u | 138.45 | 101.10
8 | 1u | 157.50 | 101.10
9 | 1u | 176.55 | 101.10
10 | 1u | 195.60 | 101.10
11 | 1u | 214.65 | 101.10
12 | 1u | 233.70 | 101.10
13 | 1u | 252.75 | 101.10
14 | 2u（横） | 281.32 | 101.10
15 | 1u | 28.91 | 82.05
16 | 1u | 52.73 | 82.05
17 | 1u | 71.78 | 82.05
18 | 1u | 90.83 | 82.05
19 | 1u | 109.88 | 82.05
20 | 1u | 128.93 | 82.05
21 | 1u | 147.97 | 82.05
22 | 1u | 167.03 | 82.05
No 種類 | X | Y
23 | 1u | 186.07 | 82.05
24 | 1u | 205.12 | 82.05
25 | 1u | 224.18 | 82.05
26 | 1u | 243.22 | 82.05
27 | 1u | 262.27 | 82.05
28 | 2u（縦） | 288.47 | 72.53
29 | 1u | 31.29 | 63.00
30 | 1u | 57.49 | 63.00
31 | 1u | 76.54 | 63.00
32 | 1u | 95.59 | 63.00
33 | 1u | 114.64 | 63.00
34 | 1u | 133.69 | 63.00
35 | 1u | 152.74 | 63.00
36 | 1u | 171.79 | 63.00
37 | 1u | 190.84 | 63.00
38 | 1u | 209.89 | 63.00
39 | 1u | 228.94 | 63.00
40 | 1u | 247.99 | 63.00
41 | 1u | 267.04 | 63.00
42 | 1u | 24.15 | 43.95
43 | 1u | 43.20 | 43.95
44 | 1u | 62.25 | 43.95
No 種類 | X | Y
45 | 1u | 81.30 | 43.95
46 | 1u | 100.35 | 43.95
47 | 1u | 119.40 | 43.95
48 | 1u | 138.45 | 43.95
49 | 1u | 157.50 | 43.95
50 | 1u | 176.55 | 43.95
51 | 1u | 195.60 | 43.95
52 | 1u | 214.65 | 43.95
53 | 1u | 233.70 | 43.95
54 | 1u | 252.75 | 43.95
55 | 1u | 271.80 | 43.95
56 | 1u | 290.85 | 43.95
57 | 1u | 26.53 | 24.90
58 | 1u | 50.34 | 24.90
59 | 1u | 74.16 | 24.90
60 | 6.25u（横） | 145.59 | 24.90
61 | 1u | 214.65 | 24.90
62 | 1u | 233.70 | 24.90
63 | 1u | 252.75 | 24.90
64 | 1u | 271.80 | 24.90
65 | 1u | 290.85 | 24.90

注記

1. Fusionの例：1か所目を「中心の長方形」14×14で描き、残りは座標表どおりに配置（または「矩形状パターン」で 19.05 ピッチ）
2. 1段の中では X が 19.05 ずつ（1u）並ぶ。段のずれはキーの幅（1.25u・1.5u・1.75u など）による
3. スタビつきの3か所（2u・ISO Enter・スペース）は3枚目の長方形の表で描く
4. いちばん確実なのは DXF（dxf/plate_*.dxf）をスケッチに挿入する方法。座標は同じ
5. 同じ内容の CSV：case/drawings/switch_cutouts_v15.csv

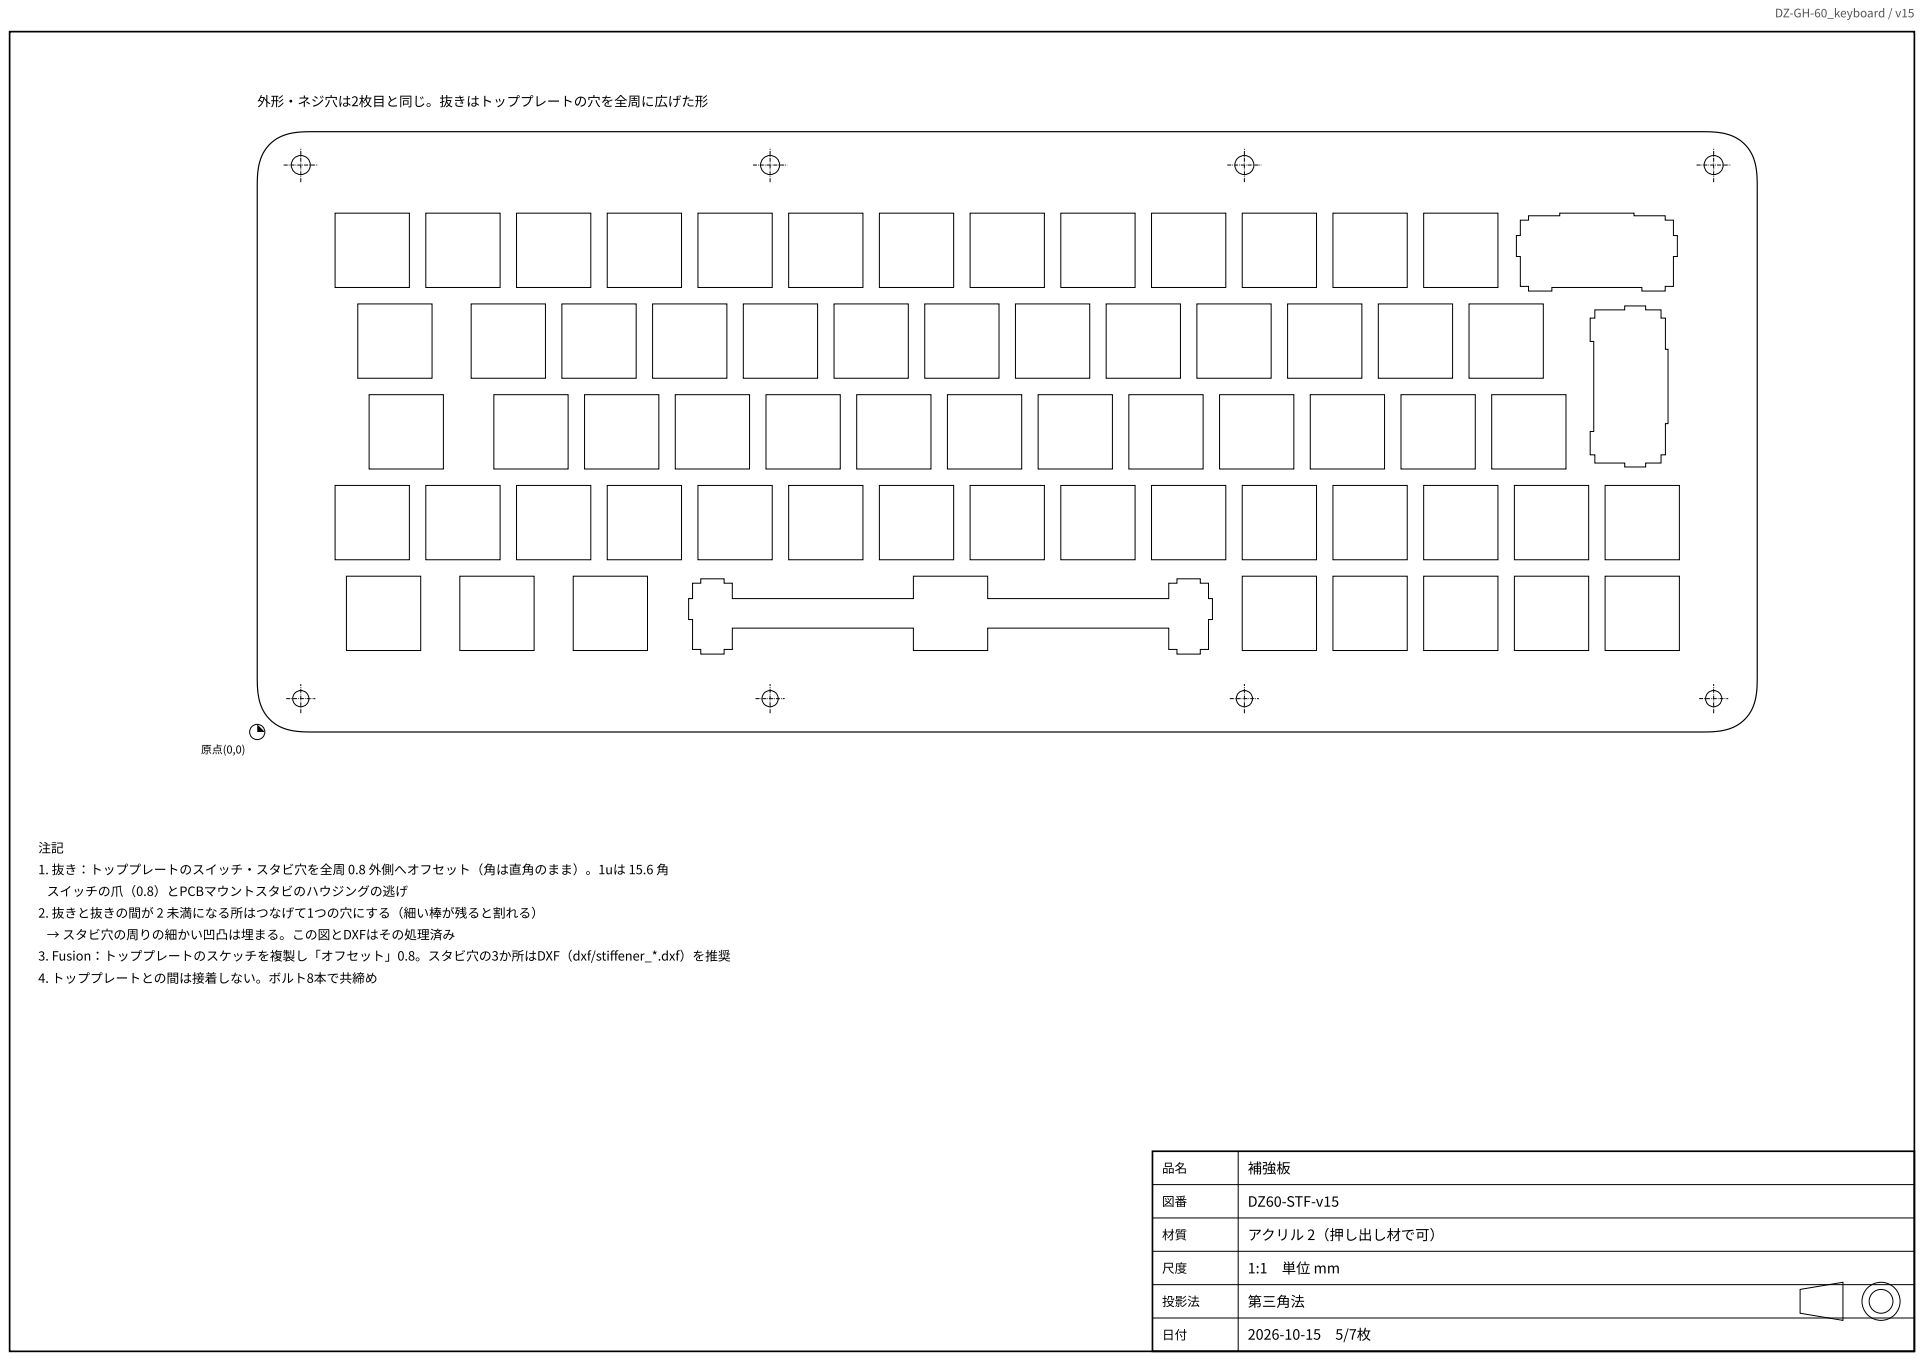
[picture p94: page 5]
補強板; DZ60-STF-v15; アクリル 2（押し出し材で可）; 外形・ネジ穴は2枚目と同じ。抜きはトッププレートの穴を全周に広げた形; スイッチの爪（0.8）とPCBマウントスタビのハウジングの逃げ; 2. 抜きと抜きの間が 2 未満になる所はつなげて1つの穴にする（細い棒が残ると割れる）; → スタビ穴の周りの細かい凹凸は埋まる。この図とDXFはその処理済み; 4. トッププレートとの間は接着しない。ボルト8本で共締め

1. 抜き：トッププレートのスイッチ・スタビ穴を全周 0.8 外側へオフセット（角は直角のまま）。1uは 15.6 角

3. Fusion：トッププレートのスケッチを複製し「オフセット」0.8。スタビ穴の3か所はDXF（dxf/stiffener_*.dxf）を推奨

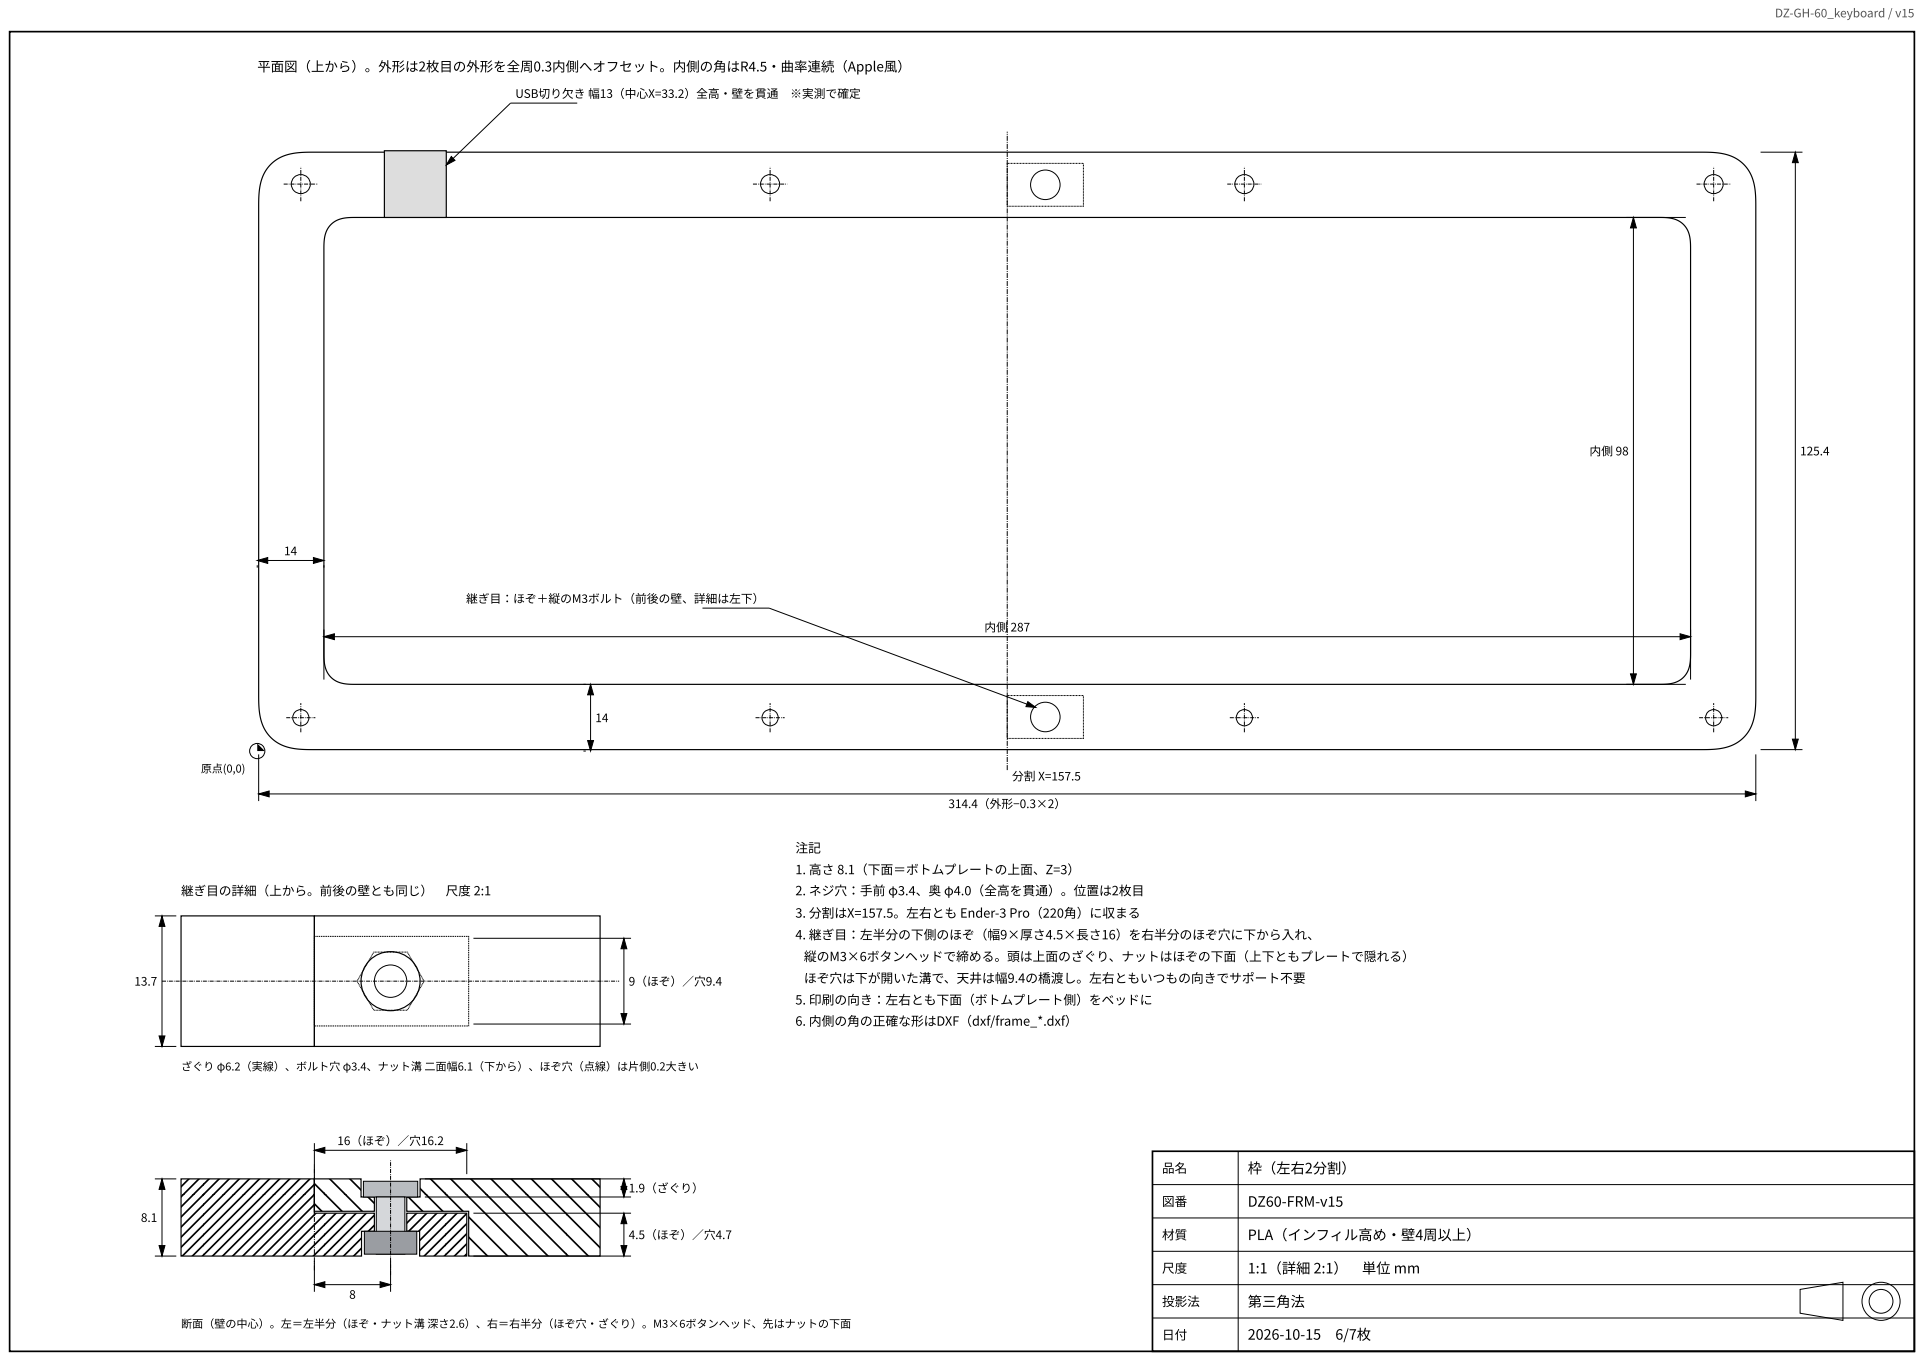
[picture p95: page 6]
DZ60-FRM-v15; PLA（インフィル高め・壁4周以上）; 1.9（ざぐり）; ほぞ穴は下が開いた溝で、天井は幅9.4の橋渡し。左右ともいつもの向きでサポート不要

平面図（上から）。外形は2枚目の外形を全周0.3内側へオフセット。内側の角はR4.5・曲率連続（Apple風）

USB切り欠き 幅13（中心X=33.2）全高・壁を貫通　※実測で確定

継ぎ目：ほぞ＋縦のM3ボルト（前後の壁、詳細は左下）

1. 高さ 8.1（下面＝ボトムプレートの上面、Z=3）

継ぎ目の詳細（上から。前後の壁とも同じ）　尺度 2:1

2. ネジ穴：手前 φ3.4、奥 φ4.0（全高を貫通）。位置は2枚目
3. 分割はX=157.5。左右とも Ender-3 Pro（220角）に収まる

4. 継ぎ目：左半分の下側のほぞ（幅9×厚さ4.5×長さ16）を右半分のほぞ穴に下から入れ、

縦のM3×6ボタンヘッドで締める。頭は上面のざぐり、ナットはほぞの下面（上下ともプレートで隠れる）

5. 印刷の向き：左右とも下面（ボトムプレート側）をベッドに
6. 内側の角の正確な形はDXF（dxf/frame_*.dxf）

ざぐり φ6.2（実線）、ボルト穴 φ3.4、ナット溝 二面幅6.1（下から）、ほぞ穴（点線）は片側0.2大きい

断面（壁の中心）。左＝左半分（ほぞ・ナット溝 深さ2.6）、右＝右半分（ほぞ穴・ざぐり）。M3×6ボタンヘッド、先はナットの下面

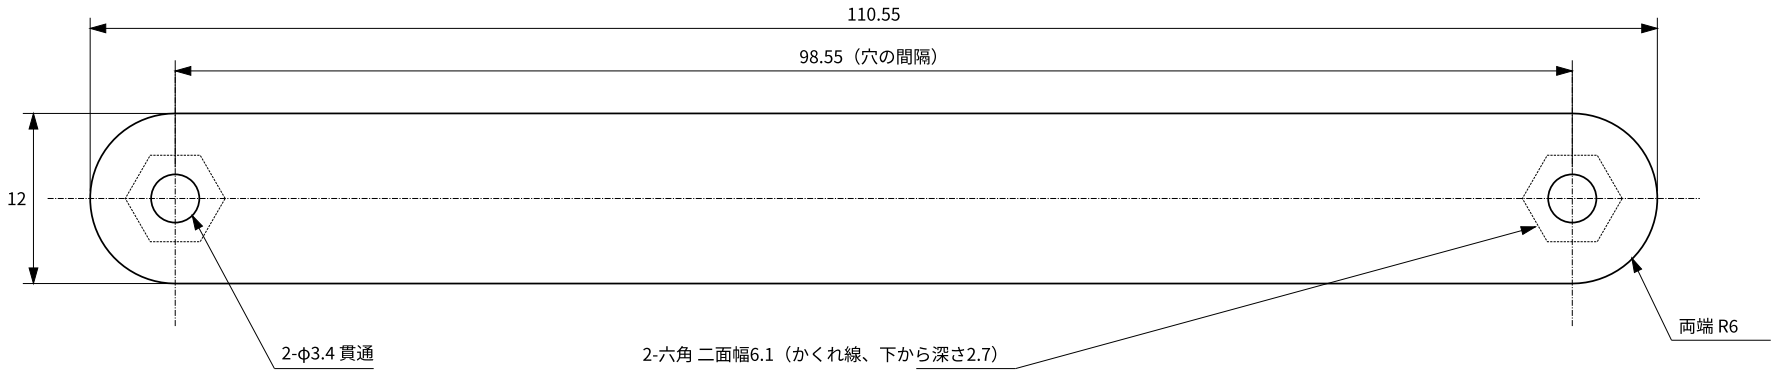
[picture p96: figure]
98.55（穴の間隔）; 2-六角 二面幅6.1（かくれ線、下から深さ2.7）

品名 | 足（4本とも同じ形）
図番 | DZ60-FT-v15
材質 | PLA（インフィル100%）　数量 4
尺度 | 2:1　単位 mm
日付 | 2026-10-15　7/7枚

平面図（上から＝ボトムプレートに当たる面）　尺度 2:1。六角は辺が長手方向と平行

3.7
2.7（六角の深さ）

1（上の肉）

6.1（二面幅）

φ3.4

断面 B-B（穴の中心を通る）　尺度 4:1。上＝ボトムプレート側、下＝机側

取り付け位置（足の中心、原点基準）

手前左 | X 58.425 | Y 7.000
奥左 | X 58.425 | Y 119.000
手前右 | X 256.575 | Y 7.000
奥右 | X 256.575 | Y 119.000

注記

1. 4本とも同じ形。ナットM3（二面幅5.5・厚さ2.4）を下から入れる
2. ボルトM3×18の先端はナットの下面とほぼ同じ高さ
3. 印刷の向き：上面（ボトムプレート側）をベッドに。六角が上を向く
4. 底に滑り止めゴムを貼ると、ナットも落ちない
