Pinticketaro/DZ-GH-60_keyboard/(commit log)

2026-10-14 初期構成：決定事項・基準寸法・Tips・配列データ
    - DZ60 V2（はんだ付け版）、CO2レーザーでプレート、PLAで2分割ケースの方針
    - GH60オープンソースPCBから抽出した基準寸法
    - 配列データ（KLE JSON）
    - 実測値の記入表、製作ログ
    Claude-Session: https://claude.ai/code/session_01G4EiQ1Pv8qzYUGegYMyckp
2026-10-14 事例調査とマイルストーン方式を追加
    - GitHub等のGH60ケース・プレート生成ツール・試作記録を調査
    - プレートはai03生成＋カーフ補正、キャリブレーション板から始める方針
    - M0〜M6のマイルストーンと完了条件、タグ運用
    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
2026-10-14 旧デザイン踏襲：積層ケースの図面v01/v02、Apple風角丸、配列を2u BSに
    - 旧プロジェクト（2025年2〜3月）を調査 → docs/旧プロジェクト.md
    - 構造：トッププレート（アクリル・レーザー）／枠（PLA・3Dプリント）／ボトムプレート（アクリル・レーザー）、M3×8
    - 外形315×126、枠の幅14（旧デザイン）
    - 配列：2u Backspaceに戻す。Caps段のキー数の誤りを修正。旧swillkbのスイッチ穴65個と全数一致
    - 角：曲率が連続するApple風の角丸（クロソイド＋円弧）。外側は仮R12、比較図とA4テスト片で決める
    - v02：枠の内側の角もR4.5で丸め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
2026-10-14 v03: PCBは挟み込み固定、トッププレート3mm（仮）、高さ方向をパラメータ化
    - PCBはネジ止めせず、ボトムプレート側の柔らかい台座で押し上げ、トッププレートとスイッチで挟み込む
    - トッププレートは剛性のため3mm（仮）。MXのツメはかからないが挟み込みで固定
    - 枠の厚さを自動計算：(5.0 − プレート厚) + PCB 1.6 + 台座 5.0 = 8.6、合計14.6
    - 断面図 docs/img/section_v03.png、tools/section.py
    - スタビワイヤーの溝はプレートで貫通済み（スペース幅4.6mm）を確認
    Claude-Session: https://claude.ai/co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
2026-10-14 v04: トッププレート1.5mm＋補強板2mm（共締め）、PCBは爪と肩で固定
    - 訂正：3mmの1枚板ではMXの爪が掛からず、台座で押し上げるとPCBとスイッチが浮く
    - トッププレート1.5mm（爪が掛かる）＋補強板2mm（穴は片側0.8mm大きい＝爪の逃げ）
    - 補強板は接着せず、枠との間に挟んでM3×8で共締め
    - 枠の厚さ8.1mm（補強板〜PCB 1.5＋PCB 1.6＋台座5）、合計14.6mm
    - 補強板の穴と穴の間の最小幅2.7mm。stiffener_v04_t2_kerf0.svg
    - 断面図・重ね合わせ図をv04に更新
    Claude-Session: https://claude.ai/code/session_011T1ANsB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
2026-10-14 v05: 外観・打鍵感の改善（足兼ナット受け、フォーム型紙、枠の影の線、3Dモデルと外観プレビュー）
    - 調査と見積もり → docs/改善案.md。はんだ後はプレート＋スイッチ＋PCBの箱で約0.004mm/N。
    打鍵感は板の厚さより留め方とフォームで決まる
    - 足：PLAの丸台φ12×8（ナット受け兼用、外形より1mm内側）、傾き5°（仮）、M3×18で全層共締め
    - 枠をアクリルより0.3mm内側へ（影の線）、継ぎ目に位置決め穴φ1.9（1.75mmフィラメント）
    - フォームの型紙：ケースフォーム（台座兼用）、プレートフォーム（1.5mm）。PORONはレーザ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
    [assembly_v05.stl, feet_v05.stl, frame_left_v05.stl, frame_right_v05.stl]
2026-10-14 v06: 奥側の足を真鍮丸棒φ12に（横から端の丸が見える配置）
    - 丸棒をボトムプレートの奥側の下面に沿わせて左右方向に置く。端は側面にそろえる
    - 後ろの4穴を一直線（Y=-8.7）に並べ、M3×20で丸棒のめねじ（下穴φ2.5・深さ7）へ。ねじ込み5.4mm
    - 傾きは前の足の底と丸棒の下側が同じ面に乗る角度で自動計算（φ12で約4.1°）
    - 前の足はPLAの丸台4個（ナット受け）。丸棒の穴あけ型紙 rod_drill_template_v06.svg
    - 外観プレビューに斜め後ろからの視点を追加
    Claude-Session: https://claude.ai/code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
    [assembly_v06.stl, brass_rod_reference_v06.stl, feet_v06.stl, frame_left_v06.stl, frame_right_v06.stl]
2026-10-14 図：真鍮丸棒の固定方法の断面（rod_mount_v06.png）
    Claude-Session: https://claude.ai/code/session_011T1ANsB1HtaDG6jniGQn6Z
2026-10-14 v07: 丸棒の受け台（PLA）、後ろの穴φ4.0、穴あけ治具と加工図
    - 丸棒とボトムプレートの間に受け台（上は平ら・下は凹面、最も薄い所1mm、左右2分割）
    → 丸棒の線当たりでアクリルが割れるのを防ぐ。傾きは約4.6°（φ12）
    - 後ろの4穴を全層φ4.0に。丸棒の穴位置±0.3を吸収（ボタンヘッドφ5.7で隠れる）
    - 後ろのボルトM3×20、丸棒へのねじ込み4.4mm（ワッシャーなし）
    - 穴あけ治具（左端基準・右端基準の2つ、丸棒を差し込み突き当てる、ガイド穴φ2.7）
    - 加工図 case/rod_drawing_v07.pdf（持ち込み・外注用）、固定方法の断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
    [assembly_v07.stl, brass_rod_reference_v07.stl, feet_v07.stl, frame_left_v07.stl, frame_right_v07.stl, rod_jig_left_v07.stl, rod_jig_right_v07.stl, rod_saddle_left_v07.stl]
2026-10-14 v08: 足を前後一体の4本に（手前のナット受け＋奥の丸棒受け）
    - 列ごとに、手前の足（ナット受け、机の面に合わせた斜めの台）と奥の丸棒受け（上は平ら・下は凹面、
    最も薄い所1mm）を1本につないだ足×4（幅12・厚さ3・長さ約120mm）
    - 受け台（左右2分割）と丸台4個をやめ、部品は足4＋丸棒1に。Ender-3でそのまま印刷できる
    - 丸棒・ボトムプレートと干渉なし、机とのすき間は中央で約5.5mm、傾き4.6°（φ12）は変わらず
    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
    [assembly_v08.stl, brass_rod_reference_v08.stl, feet_v08.stl, foot_1_v08.stl, foot_2_v08.stl, foot_3_v08.stl, foot_4_v08.stl, frame_left_v08.stl]
2026-10-14 v09: 足を左右ずつまとめる（手前バー×2＋奥の丸棒受け×2）、中央のネジを左右対称に
    - 手前：2つのナット受けをつないだバー（左・右、各110mm、底は机の面に合わせて斜め）
    - 奥：2穴ぶんの丸棒受け（左・右、各110mm、最も薄い所1mm）
    - 中央2本のネジを左右対称に（X=92.7／192.3、旧デザインは177）→ 左右の部品が鏡像の同じ形、
    丸棒の穴位置も左右対称（8.21/105.46/205.06/302.31）で治具1つを両端に使える
    - v08の前後一体の足は意図と違ったため置き換え
    Claude-Session: https://claude.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
    [assembly_v09.stl, brass_rod_reference_v09.stl, feet_v09.stl, foot_front_left_v09.stl, foot_front_right_v09.stl, frame_left_v09.stl, frame_right_v09.stl, rod_jig_left_v09.stl]
2026-10-14 v10: 丸棒の上面を平面加工（幅6）、受け台なし、渡せる加工図（A3）
    - 丸棒の上面に幅6の平面（削り深さ0.80、平面から下端11.20）。ボトムプレートに面で当てるので受け台不要
    - 後ろのボルトM3×20のねじ込みは5.4mm、下穴φ2.5深さ7.5・有効ねじ深さ6
    - 傾き約3.7°（φ12）、手前の高さ18.6mm
    - 加工図 rod_drawing.py：A3・第三角法・図枠と表題欄・平面図/正面図1:1・断面A-A 5:1・注記
    （材質C3604BD、全長310.5±0.2、穴位置±0.1、一般公差JIS B 0405-m）
    - 平面加工ができない場合の予備としてv09（受け台方式）を残す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
    [assembly_v10.stl, brass_rod_reference_v10.stl, feet_v10.stl, foot_front_left_v10.stl, foot_front_right_v10.stl, frame_left_v10.stl, frame_right_v10.stl, rod_jig_left_v10.stl]
2026-10-14 v11: 丸棒に旋盤の溝×4＋ゴムテープ（平面加工・受け台なし）
    - ねじ穴を中心に全周の溝（幅10.5、溝底φ10.4＝深さ0.8）、ゴムテープ幅10・厚さ1を巻く
    - テープは溝より0.2厚い → 締めると上側が沈み、丸棒の外周がほぼプレートに接する（4層もしっかり締まる）
    - 下側のテープが机に当たる。ボルトはテープを貫通。ねじ込み4.6（溝底から）、傾き約4.1°（φ12）
    - 加工図を溝つきに更新（平面図・正面図に段、断面A-Aは溝底φ10.4、注記にテープ）。
    端面は旋盤仕上げと明記、平面の高さ公差は±0.1に緩和（平面加工版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
    [assembly_v11.stl, brass_rod_reference_v11.stl, feet_v11.stl, foot_front_left_v11.stl, foot_front_right_v11.stl, frame_left_v11.stl, frame_right_v11.stl, rod_jig_left_v11.stl]
2026-10-14 docs: 改善案の傾きをv11（溝＋テープ）の値に更新
    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
2026-10-15 v12: 角R8・丸棒φ8で一旦検討（めねじ貫通、端の溝を避けて後ろの角の穴を内側へ）
    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
    [assembly_v12.stl, brass_rod_reference_v12.stl, feet_v12.stl, foot_front_left_v12.stl, foot_front_right_v12.stl, frame_left_v12.stl, frame_right_v12.stl, rod_jig_left_v12.stl]
2026-10-15 v13: 奥の足もPLAのバーに（丸棒は保留、穴位置と傾きは丸棒φ8版と同じ）
    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
    [assembly_v13.stl, feet_v13.stl, foot_front_left_v13.stl, foot_front_right_v13.stl, foot_rear_left_v13.stl, foot_rear_right_v13.stl, frame_left_v13.stl, frame_right_v13.stl]
2026-10-15 v14: 傾き0°、足を同じ形のPLAのバー×4に（手前の角の穴を奥と対称に）
    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
    [assembly_v14.stl, feet_v14.stl, foot_bar_x4_v14.stl, frame_left_v14.stl, frame_right_v14.stl]
2026-10-15 Fusion 360用の図面セット（A3・7枚）とDXF・CSVを追加
    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
    [bottom_v14.dxf, feet_layout_v14.dxf, foot_v14.dxf, frame_v14.dxf, plate_v14.dxf, stiffener_v14.dxf, switch_cutouts_v14.csv]
2026-10-15 v15: 枠の継ぎ目をほぞ＋横向きのM3×20ボルトに（ピン廃止）、継ぎ目の拡大図
    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
    [assembly_v15.stl, bottom_v15.dxf, feet_layout_v15.dxf, feet_v15.stl, foot_bar_x4_v15.stl, foot_v15.dxf, frame_left_v15.stl, frame_right_v15.stl]
2026-10-15 v15訂正: 継ぎ目を縦向きのM3×6ボタンヘッド＋ほぞ（下側の舌）に（横向きボルトは取り消し）
    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
    [assembly_v15.stl, bottom_v15.dxf, feet_layout_v15.dxf, foot_v15.dxf, frame_left_v15.stl, frame_right_v15.stl, frame_v15.dxf, plate_v15.dxf]
2026-10-15 v15: 解析・重ね合わせ・断面・外観プレビューを再生成
    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
2026-10-15 Fusion 360用：寸法ベースで組み立てるスクリプトとSTEP（v15）
    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
    [assembly_v15.step, bottom_plate_v15.step, foot_v15.step, frame_left_v15.step, frame_right_v15.step, pcb_reference_v15.step, stiffener_v15.step, top_plate_v15.step]
2026-10-22 WIP v16: スカート案（ボトムプレートを枠の内側に、ネジ穴はU字の切り欠き、継ぎ目のほぞを上側へ）。箱型案の確認待ちで中断
    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
    [assembly_v16.stl, feet_v16.stl, foot_bar_x4_v16.stl, frame_left_v16.stl, frame_right_v16.stl]
2026-10-22 v16: スカート型サンドイッチ（ボトムプレートを枠の内側・U字の切り欠き、継ぎ目のほぞを上側へ、枠は上面を下にして印刷）。図面8枚・STEP・Fusionスクリプト・側面比較を更新
    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
    [assembly_v16.step, bottom_plate_v16.step, bottom_v16.dxf, feet_layout_v16.dxf, foot_v16.dxf, foot_v16.step, frame_left_v16.step, frame_right_v16.step]
2026-10-22 Add monozukuri review board (v05-v16)
    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
    [bottom.stl, foot_1.stl, foot_2.stl, foot_3.stl, foot_4.stl, frame_left.stl, frame_right.stl, pcb.stl]
2026-10-27 v17（モック）: 補強板を枠の上面の掘り込みに入れる。確認ボードを新しいスキルで作り直し（選べる問い・STL/STEP書き出し・サポートの確認）
    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
    [assembly_v17.step, bottom.stl, bottom_plate_v17.step, foot_1.stl, foot_2.stl, foot_3.stl, foot_4.stl, foot_v17.step]
2026-10-27 v18（モック）: トレー型（枠と底を一体のPLAトレーに、底を下にして印刷）。確認ボードに v18 を追加、PC で開く serve_review.py を同梱
    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
    [assembly_v18.step, foot_1.stl, foot_2.stl, foot_3.stl, foot_4.stl, foot_v18.step, frame_left.stl, frame_left_v18.step]
2026-10-27 v18 を v18b（v17 から分けた案 B：トレー型）に改名。寸法ファイルに meta.parent
    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
    [assembly_v18.step, assembly_v18b.step, foot_1.stl, foot_2.stl, foot_3.stl, foot_4.stl, foot_v18.step, foot_v18b.step]
2026-10-27 確認ボードを monozukuri 最新（版の枝分かれ・ツリー）で作り直し、v18a・v18b を v17 から分けた案として掲載
    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
    [assembly_v18a.step, bottom.stl, bottom_plate_v18a.step, foot_1.stl, foot_2.stl, foot_3.stl, foot_4.stl, foot_v18a.step]
2026-10-27 寸法と根拠：tools/dims_export.py で params/params_<版>.json（根拠・資料・状態つき）を書き出し、refs/ に資料を置く（v18b）
    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
2026-10-27 確認ボード：v18a・v18b に寸法と根拠（params/）と資料（refs/）を載せる
    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
2026-10-27 v19（モック・v18b から）：底2mm・M3×16、補強板の穴をU字の切り欠き（角は角ごと）、USBの窓を長穴＋窓の上は掘り込みを止める、内角の逃げ RELIEF、下面の面取り、継ぎ目のV溝、マットブラック＋すりガラス。確認ボードに掲載
    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
    [assembly_v19.step, foot_1.stl, foot_2.stl, foot_3.stl, foot_4.stl, foot_v19.step, frame_left.stl, frame_left_v19.step]
2026-10-27 改善案：PCBを下からねじ止めする案を保留として記録
    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
2026-11-06 道具を monozukuri 0.8.0 に更新（scaffold.py --update-tools）。make_version.py 用の tools/model.py、仮の寸法の書き方、確認ボードを 0.8.0 のテンプレートで再公開、v19 の問い（底の中央のほぞ→いいえ）を記録
    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
    [assembly_v19.step, foot_v19.step, frame_left_v19.step, frame_right_v19.step, pcb_reference_v19.step, stiffener_v19.step, top_plate_v19.step]
